UW-VexU/UWAT-Centurion-Board/centurion/fab/gerber_preview_copper_layers.png

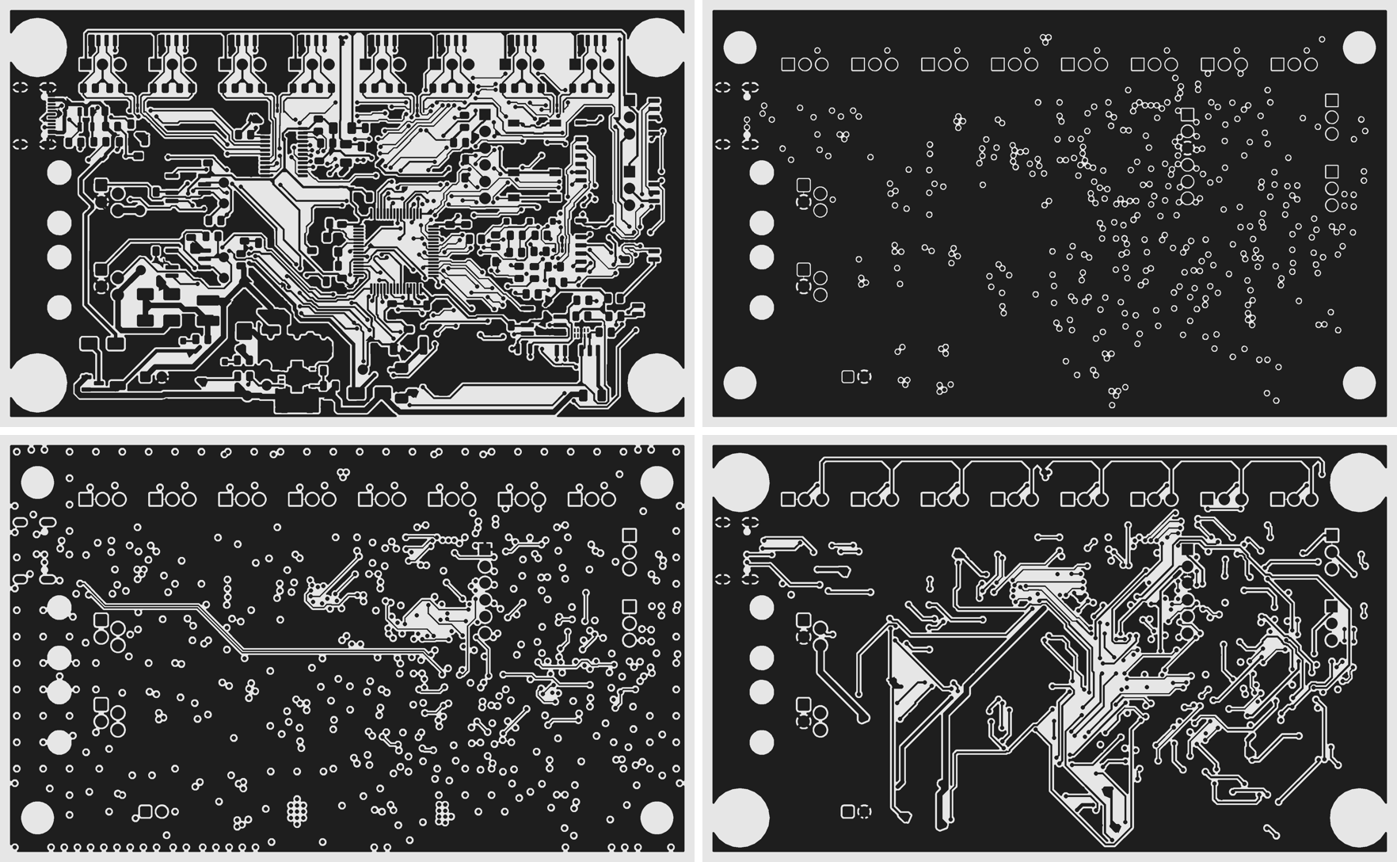
centurion/fab/gerber_preview_copper_layers.png
