UW-VexU/UWAT-Centurion-Board/centurion/sim/connectors_can.png

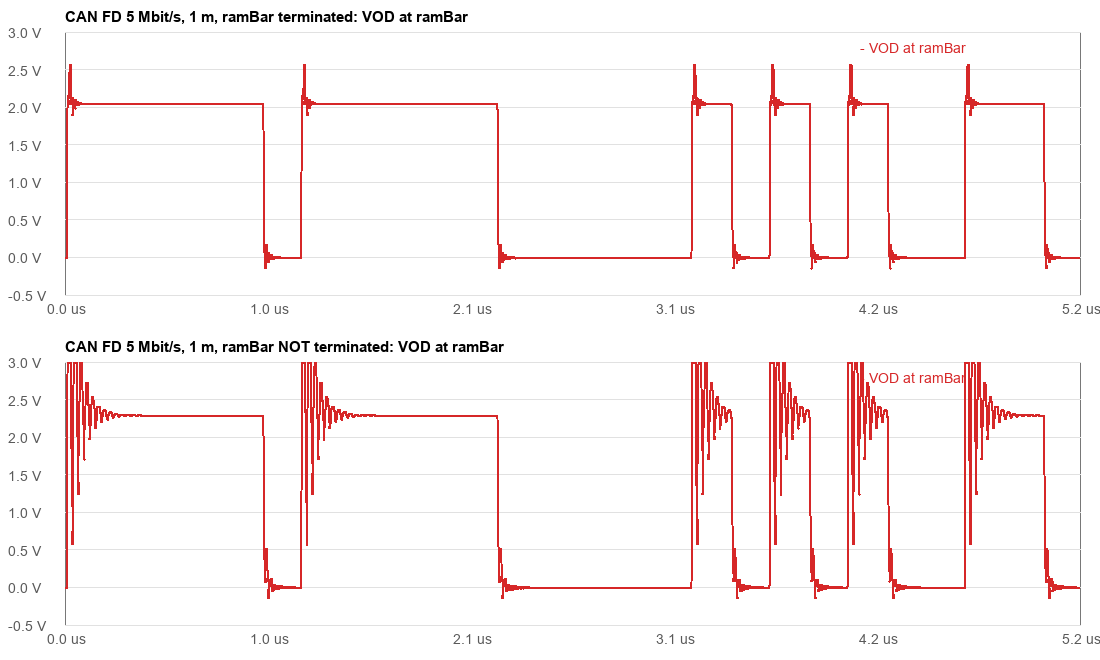
centurion/sim/connectors_can.png
