UW-VexU/UWAT-Centurion-Board/centurion/sim/connectors_i2c.png

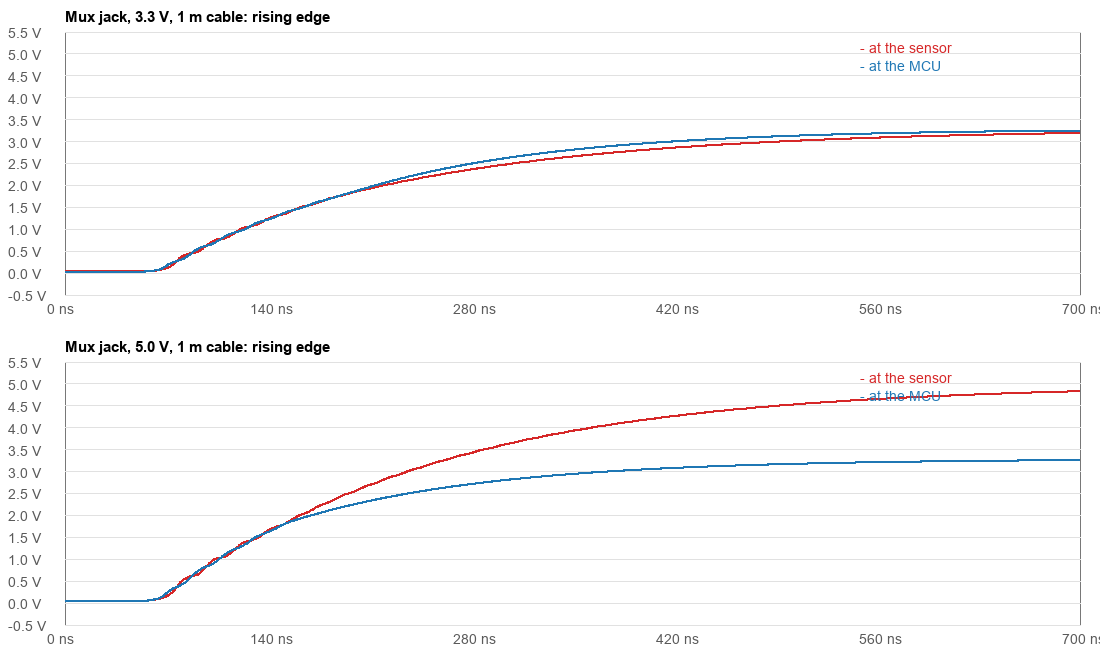
centurion/sim/connectors_i2c.png
