UW-VexU/UWAT-Centurion-Board/centurion/sim/connectors_power.png

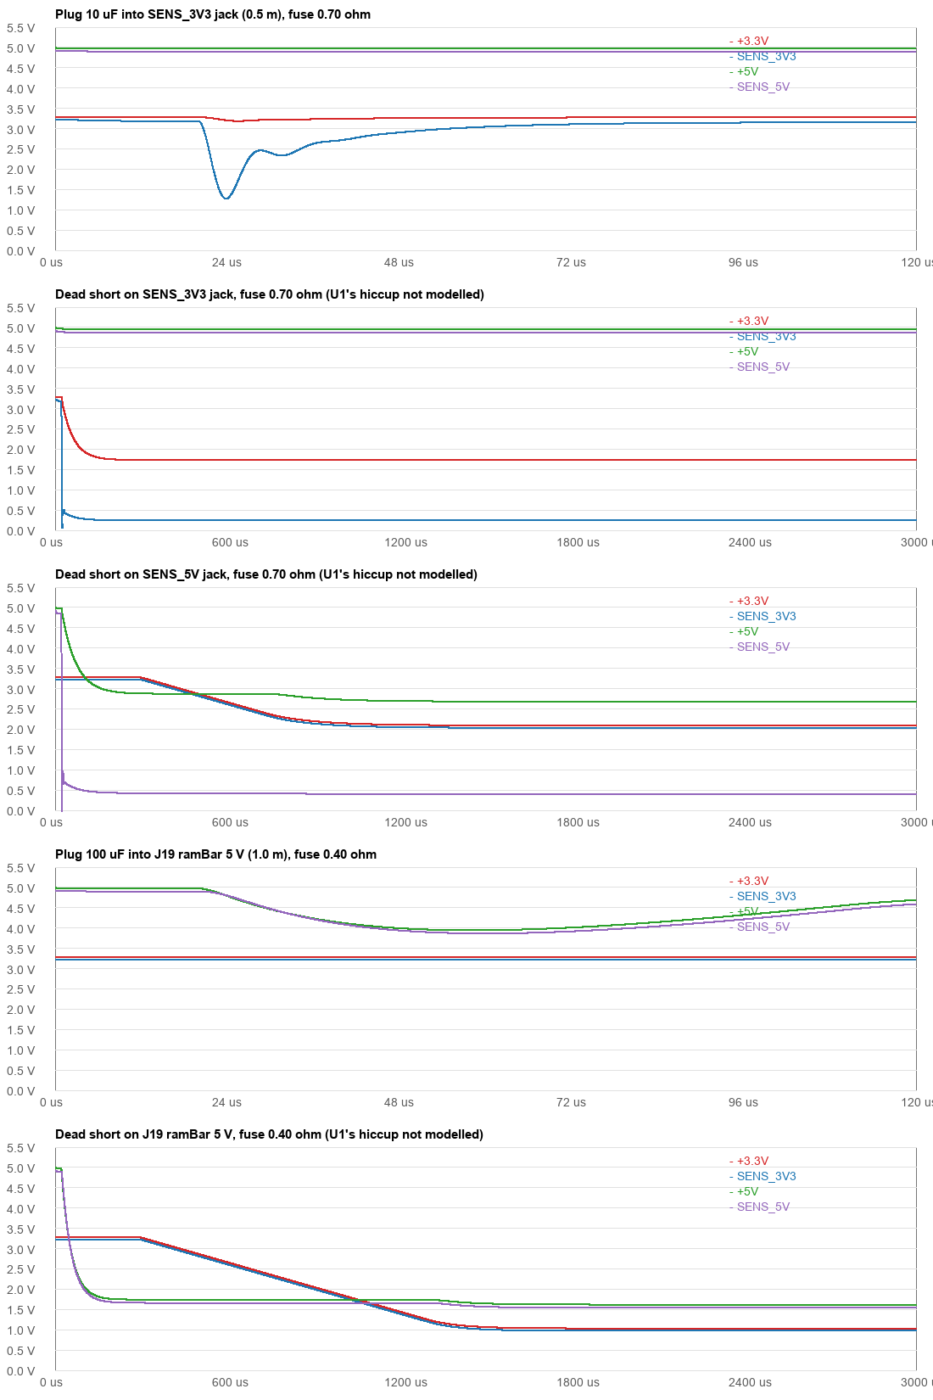
centurion/sim/connectors_power.png
