UW-VexU/UWAT-Centurion-Board/centurion/sim/connectors_rs485.png

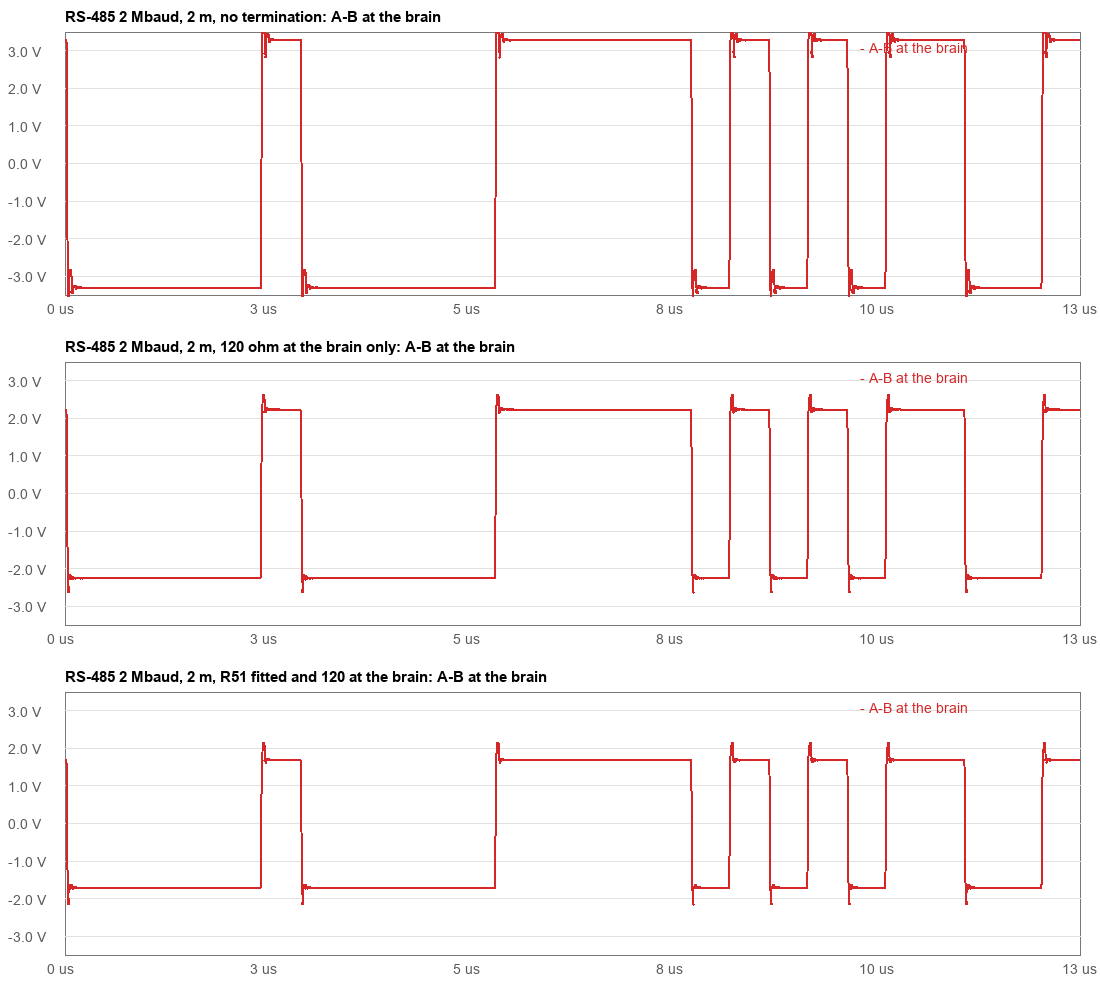
centurion/sim/connectors_rs485.png
