UW-VexU/UWAT-Centurion-Board/centurion/sim/connectors_spi.png

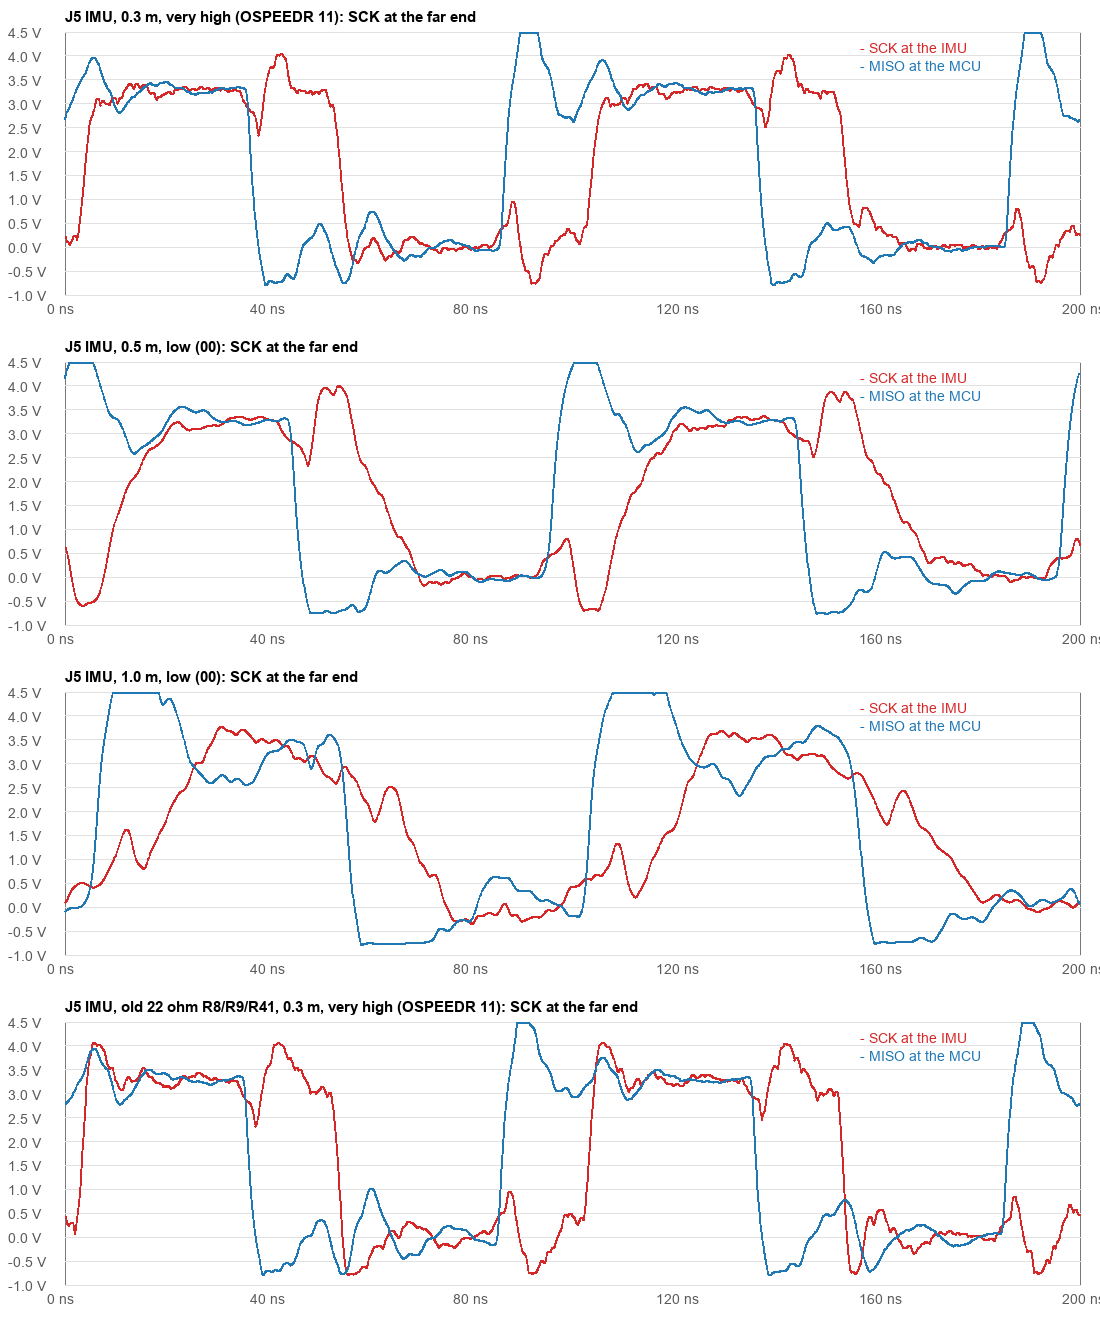
centurion/sim/connectors_spi.png
