UW-VexU/UWAT-Centurion-Board/centurion/sim/connectors_uart.png

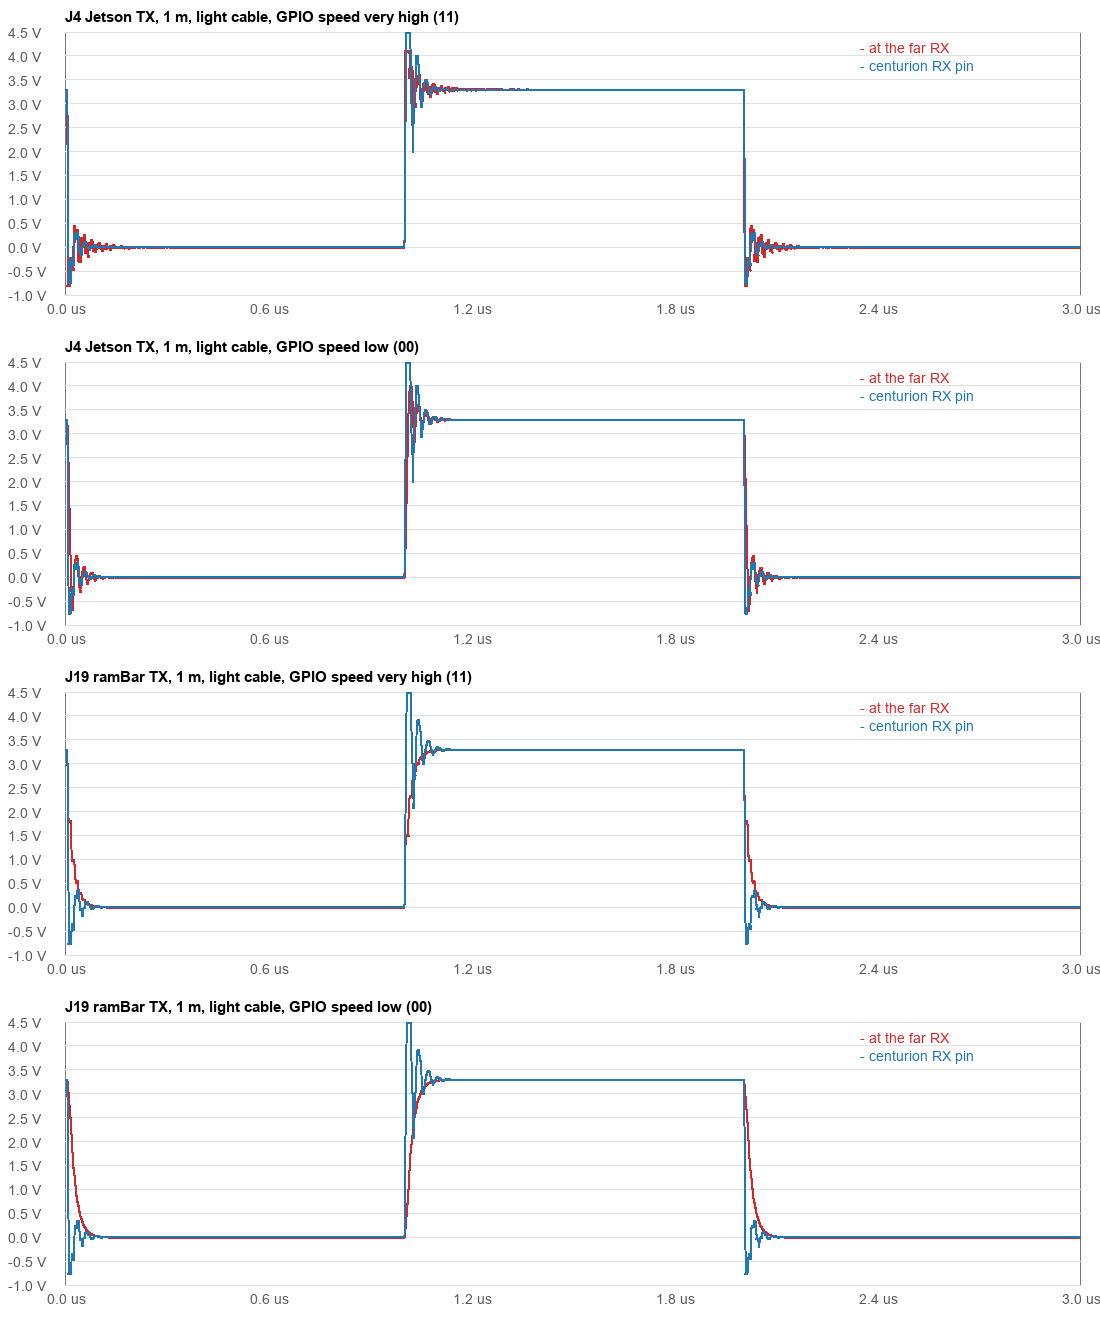
centurion/sim/connectors_uart.png
