UW-VexU/UWAT-Centurion-Board/centurion/sim/usb_hotplug_1u.png

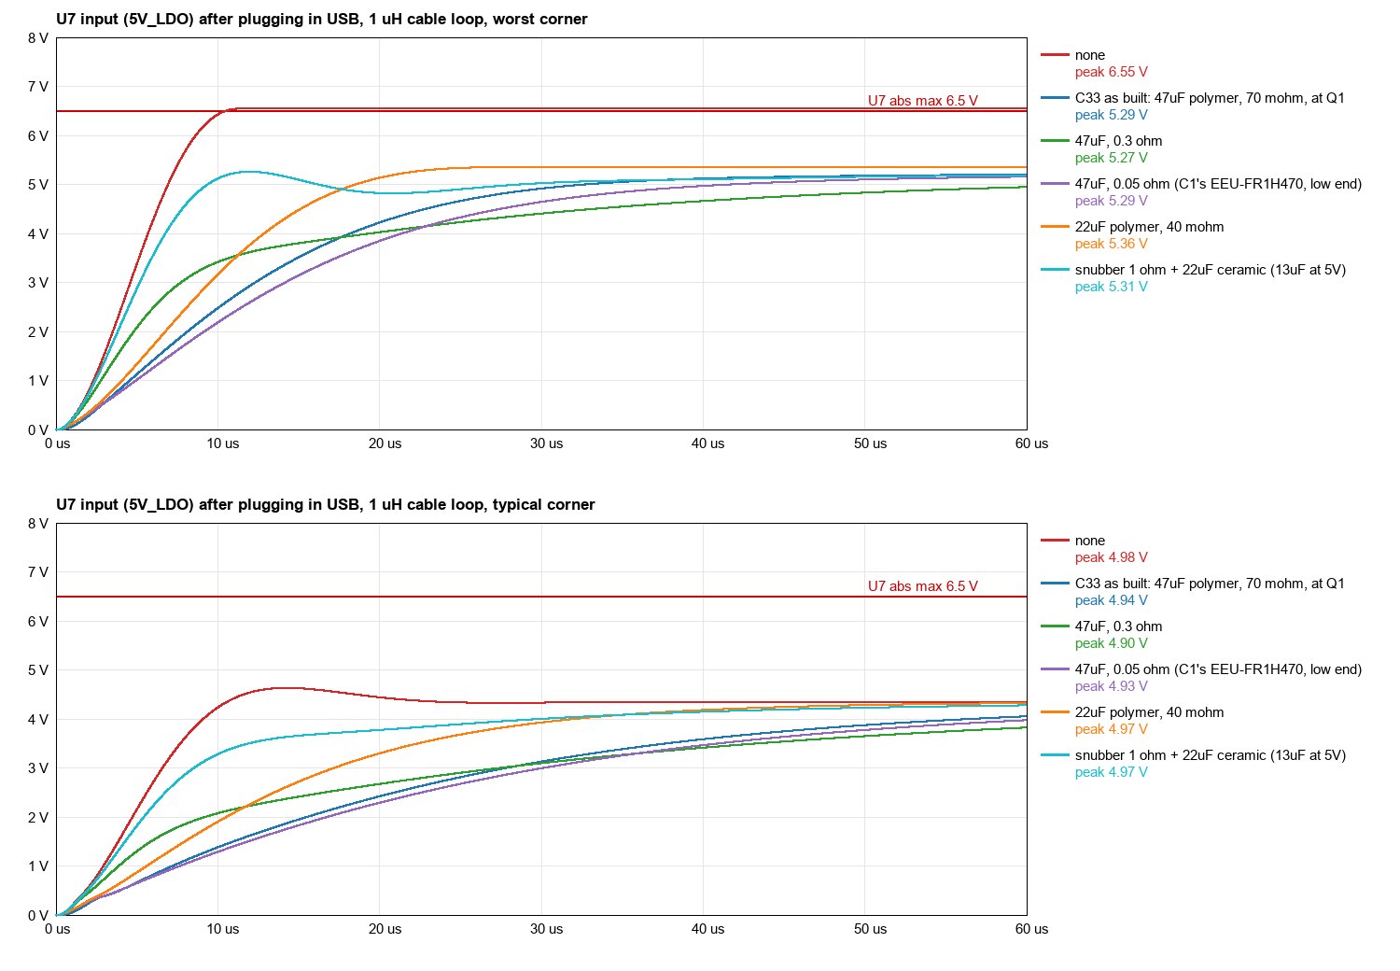
centurion/sim/usb_hotplug_1u.png
