UW-VexU/UWAT-Centurion-Board/centurion/sim/xtalk_worst.png

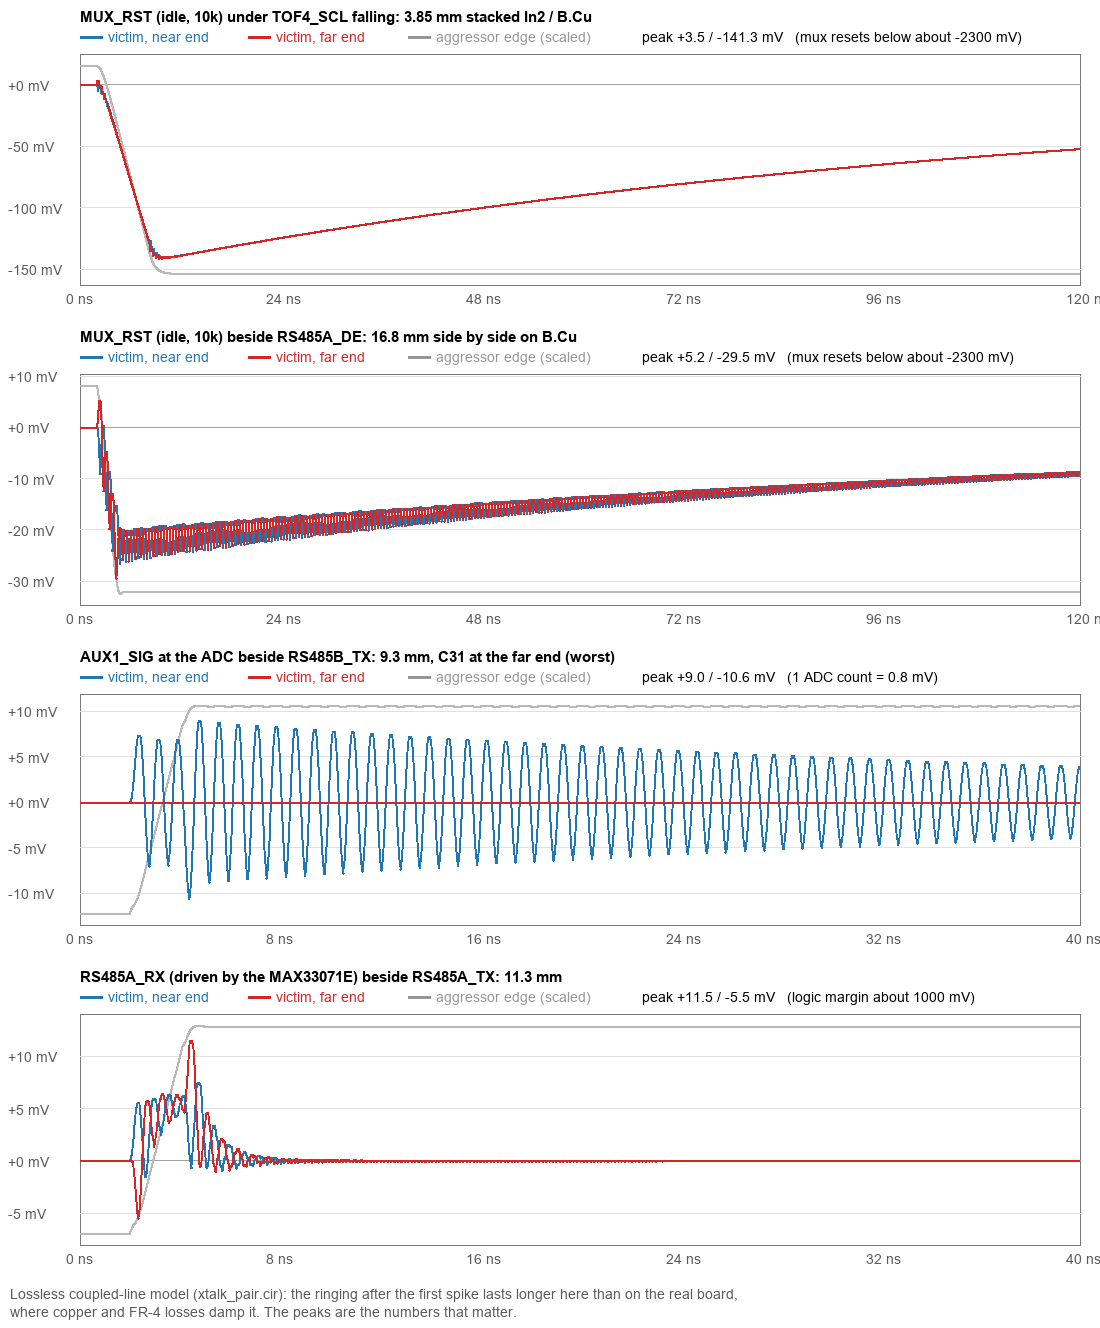
centurion/sim/xtalk_worst.png
