UW-VexU/UWAT-Centurion-Board/powerJackal/docs/images/scl_and_j2_ground.png

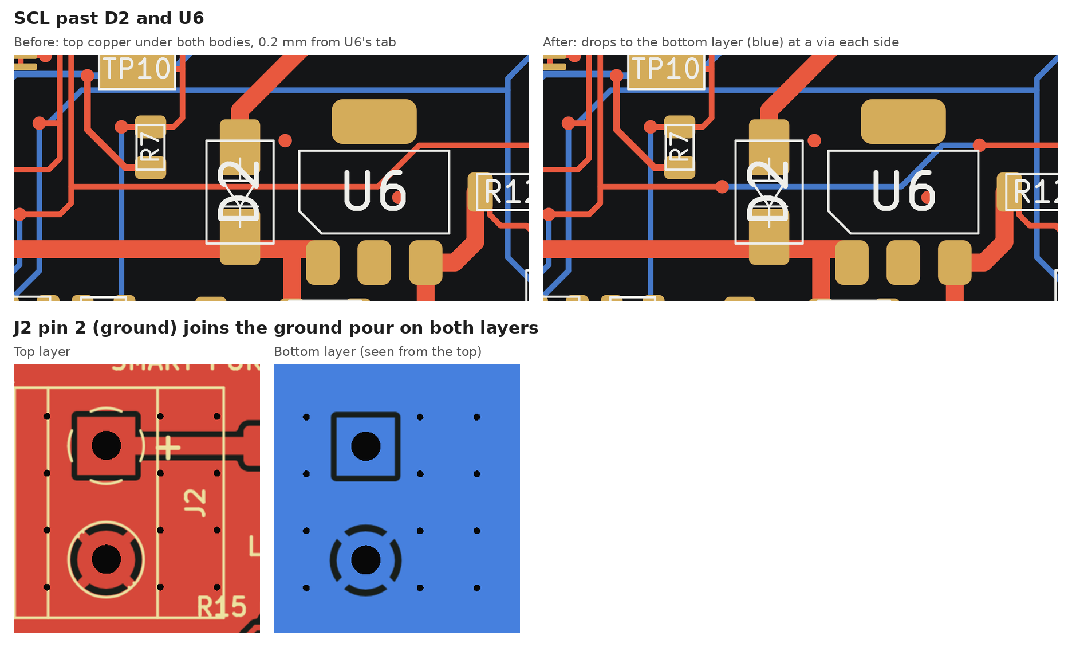
powerJackal/docs/images/scl_and_j2_ground.png
