UW-VexU/UWAT-Centurion-Board/stellaNova/docs/uwat-stellaNova-iso.png

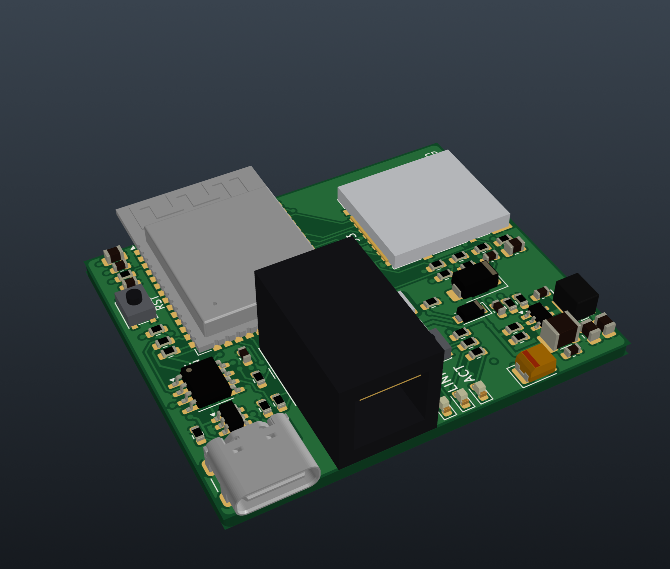
stellaNova/docs/uwat-stellaNova-iso.png
