UW-VexU/UWAT-Centurion-Board/centurion/bom/centurion_revA_BOM.xlsx

Sheet: BOM
Centurion Sensor Board, Bill of Materials, Rev A (STM32G491 + TCA9548A + TCAN334G, 103.2 x 62.6 mm, 4 layers)
UWAT VEXU. DigiKey Canada stock and CAD price breaks, read from digikey.ca on November 4, 2026; stock rechecked November 5, 2026 (parts also on powerJackal or stellaNova: October 29-30, 2026). The unit price follows the order quantity, using the breaks on the Price breaks tab. OUT OF STOCK at DigiKey CA on Nov 5, 2026: the JST GH right-angle headers SM04B-GHS-TB (J6-J13, J18) and SM03B-GHS-TB (J17), shaded red below. They come from LCSC only (link in column V, LCSC order tab). Two other parts that were out (TCA9548APWR, RC0805FR-07470RL) are replaced by in-stock equivalents; see their notes.
Boards to build |  | 6 | Edit the yellow cells. Type your own quantity in the yellow Your order qty column to override the suggested one. Order qty already takes off the parts left over from the powerJackal and stellaNova orders (On hand, from the Stock check tab).
Ref | Block | Description | Manufacturer | Mfr part number | DigiKey part number | Qty per board | Spares | Needed (boards x qty + spares) | Your order qty (optional) | Order qty | Unit price at order qty (CAD) | Order cost (CAD) | Next price break (qty) | Unit price at next break (CAD) | Tip | DigiKey stock | DigiKey Canada link | Notes | On hand (left from earlier orders) | Earlier order | LCSC link (only where DigiKey CA is out of stock) | LCSC stock (Nov 5, 2026)
C1 | Power | Aluminum electrolytic, 47 µF 50 V, 6.3 mm radial | Panasonic | EEU-FR1H470 | P124235-ND | 1 | 0 |  | 10 |  |  |  |  |  |  | 25727 | https://www.digikey.ca/en/products/detail/panasonic-industry/EEU-FR1H470/9921029 |  |  | powerJackal
C2, C3, C16, C32 | Power | Ceramic capacitor, 10 µF 50 V X7R, 1210 | Samsung Electro-Mechanics | CL32B106KBJNNNE | 1276-3387-1-ND | 4 | 2 |  | 50 |  |  |  |  |  |  | 628307 | https://www.digikey.ca/en/products/detail/samsung-electro-mechanics/CL32B106KBJNNNE/3889045 | C2, C3, C32: buck input ceramics at U1 VIN (TI asks for 20 uF effective). C16: LDO input. |  | powerJackal, stellaNova
C4, C5, C17 | Power | Ceramic capacitor, 47 µF 10 V X5R, 1206 | Murata | GRM31CR61A476ME15L | 490-5528-1-ND | 3 | 2 |  | 0 |  |  |  |  |  |  | 1078 | https://www.digikey.ca/en/products/detail/murata-electronics/GRM31CR61A476ME15L/2334879 |  |  | powerJackal
C6, C8, C9, C11, C12, C13, C14, C15, C19, C20, C21, C24, C25, C26, C27, C30 | Power, MCU, Sensor ports, Smart ports | Ceramic capacitor, 100 nF 50 V X7R, 0805 | Yageo | CC0805KRX7R9BB104 | 311-1140-1-ND | 16 | 2 |  | 50 |  |  |  |  |  |  | 4917789 | https://www.digikey.ca/en/products/detail/yageo/CC0805KRX7R9BB104/302874 | Place at NRST pin 7. Place at U14/U15 pin 8. Place at VBAT pin 1. Place at VDD pin 16. Place at VDD pin 32. Place at VDD pin 48. Place at VDD pin 64. Place at VDDA pin 29. Place at VREF+ pin 28. Place at the MCU ADC pin |  | powerJackal
D4 | Power | TVS diode, 16 V standoff, unidirectional, SMB | Littelfuse | SMBJ16A | SMBJ16ALFCT-ND | 1 | 1 |  | 10 |  |  |  |  |  |  | 22780 | https://www.digikey.ca/en/products/detail/littelfuse-inc/SMBJ16A/762784 |  |  | powerJackal
D9, D10 | Power | Schottky diode, 40 V 1 A, SMA | Vishay | SS14-E3/61T | SS14-E3/61TGICT-ND | 2 | 1 |  | 10 |  |  |  |  |  |  | 174599 | https://www.digikey.ca/en/products/detail/vishay-general-semiconductor-diodes-division/SS14-E3-61T/1091538 |  |  | powerJackal
F1 | Power | Polyfuse, 1.5 A hold, 33 V, 2016 | Littelfuse | 2016L150/33DR | 18-2016L150/33DRCT-ND | 1 | 1 |  | 10 |  |  |  |  |  |  | 29203 | https://www.digikey.ca/en/products/detail/littelfuse-inc/2016L150-33DR/6347051 |  |  | powerJackal
J16 | Power | USB-C receptacle, USB 2.0, 16 pin | GCT | USB4105-GF-A | 2073-USB4105-GF-ACT-ND | 1 | 0 |  | 0 |  |  |  |  |  |  | 82141 | https://www.digikey.ca/en/products/detail/gct/USB4105-GF-A/11198441 |  |  | powerJackal, stellaNova
Q1 | Power | P-channel MOSFET, -30 V, SOT-23 (USB power switch) | Alpha & Omega Semiconductor | AO3401A | 785-1001-1-ND | 1 | 1 |  | 10 |  |  |  |  |  |  | 303524 | https://www.digikey.ca/en/products/detail/alpha-omega-semiconductor-inc/AO3401A/1855773 | USB power switch. On only while the 5 V rail is down, so USB powers the board only with robot and bench power off. |  | powerJackal
R1 | Power | Resistor, 100 kΩ 1%, 0805 | Yageo | RC0805FR-07100KL | 311-100KCRCT-ND | 1 | 2 |  | 100 |  |  |  |  |  |  | 352614 | https://www.digikey.ca/en/products/detail/yageo/RC0805FR-07100KL/727544
R18, R32, R33 | Power, Sensor ports | Resistor, 2.2 kΩ 1%, 0805 | Yageo | RC0805FR-072K2L | 311-2.20KCRCT-ND | 3 | 2 |  | 0 |  |  |  |  |  |  | 375944 | https://www.digikey.ca/en/products/detail/yageo/RC0805FR-072K2L/727676 | R18: LED2. R32, R33: bus 2 (I2C3) pullups, 2.2k so two cables still meet 400 kHz rise time. |  | powerJackal
R29 | Power | Resistor, 2.49 kΩ 1%, 0805 (5 V feedback) | Yageo | RC0805FR-072K49L | 311-2.49KCRCT-ND | 1 | 2 |  | 0 |  |  |  |  |  |  | 1175983 | https://www.digikey.ca/en/products/detail/yageo/RC0805FR-072K49L/727695 | RFBB, sets 5.0 V |  | powerJackal
R31, R37, R48 | Power | Resistor, 5.1 kΩ 1%, 0805 | Stackpole Electronics | RMCF0805FT5K10 | RMCF0805FT5K10CT-ND | 3 | 2 |  | 0 |  |  |  |  |  |  | 122915 | https://www.digikey.ca/en/products/detail/stackpole-electronics-inc/RMCF0805FT5K10/1760394 |  |  | powerJackal
R40 | Power | Resistor, 22 kΩ 1%, 0805 | Yageo | RC0805FR-0722KL | 311-22.0KCRCT-ND | 1 | 2 |  | 100 |  |  |  |  |  |  | 186684 | https://www.digikey.ca/en/products/detail/yageo/RC0805FR-0722KL/727736 | Battery sense, 100k over 22k: 3.3 V full scale is 18.3 V.
U1 | Power | 5 V step-down power module, 2 A, B3QFN-14 | Texas Instruments | TPSM53602RDAR | 296-TPSM53602RDARCT-ND | 1 | 0 |  | 5 |  |  |  |  |  |  | 2776 | https://www.digikey.ca/en/products/detail/texas-instruments/TPSM53602RDAR/11502301 | EN tied to VIN. DNC pins 4, 5 and V5V (13) stay unconnected. |  | powerJackal
U7 | Power | LDO regulator, 3.3 V 1 A, SOT-223 | Microchip Technology | MCP1826ST-3302E/DB | MCP1826ST-3302E/DBCT-ND | 1 | 0 |  | 0 |  |  |  |  |  |  | 39394 | https://www.digikey.ca/en/products/detail/microchip-technology/MCP1826ST-3302E-DB/1635505 | Drawn with the AP7361C-33E symbol. Same SOT-223 pinout: 1 IN, 2 GND and tab, 3 OUT. |  | powerJackal
U13 | Power | USB ESD protection, SOT-23-6 | STMicroelectronics | USBLC6-2SC6 | 497-5235-1-ND | 1 | 1 |  | 0 |  |  |  |  |  |  | 32077 | https://www.digikey.ca/en/products/detail/stmicroelectronics/USBLC6-2SC6/1040559 |  |  | powerJackal, stellaNova
D5, D11 | Smart ports | Schottky diode, 40 V 3 A, SMA (smart port OR diodes) | Diodes Incorporated | B340A-13-F | B340A-FDICT-ND | 2 | 1 |  | 0 |  |  |  |  |  |  | 233706 | https://www.digikey.ca/en/products/detail/diodes-incorporated/B340A-13-F/725015 |  |  | powerJackal
J1, J2 | Smart ports | Smart port jack, 4P4C modular, right angle, through hole | Molex | 0955012441 | WM5568-ND | 2 | 0 |  | 10 |  |  |  |  |  |  | 4091 | https://www.digikey.ca/en/products/detail/molex/0955012441/1835860 | Pin map assumes the usual black, red, green, yellow order. Check with a meter. |  | powerJackal, stellaNova
U14, U15 | Smart ports | RS-485 transceiver, half duplex, 3.3 V, ±65 V fault protected, 2 Mbps, SOIC-8 | Analog Devices | MAX33071EASA+ | 505-MAX33071EASA+-ND | 2 | 0 |  | 10 |  |  |  |  |  |  | 2911 | https://www.digikey.ca/en/products/detail/analog-devices-inc-maxim-integrated/MAX33071EASA/14115470 | RE tied low: the receiver is always on, so the MCU hears its own echo when sending. |  | stellaNova
C10, C28, C29 | MCU, Sensor ports | Ceramic capacitor, 10 µF 25 V X5R, 0805 | Murata | GRM21BR61E106KA73K | 490-16824-1-ND | 3 | 2 |  | 20 |  |  |  |  |  |  | 27467 | https://www.digikey.ca/en/products/detail/murata-electronics/GRM21BR61E106KA73K/4905532 | C10: bulk at U3. C28, C29: bulk on SENS_3V3 and SENS_5V after F2/F3. |  | stellaNova
C18 | MCU | Ceramic capacitor, 1 µF 25 V X7R, 0805 | Yageo | CC0805KKX7R8BB105 | 311-1456-1-ND | 1 | 2 |  | 0 |  |  |  |  |  |  | 327250 | https://www.digikey.ca/en/products/detail/yageo/CC0805KKX7R8BB105/2833621 | Place at VDDA pin 29 |  | powerJackal
D6, LED1, LED2 | MCU, Power | LED, green, 0603 | Lite-On | LTST-C191KGKT | 160-1446-1-ND | 3 | 2 |  | 100 |  |  |  |  |  |  | 2259167 | https://www.digikey.ca/en/products/detail/liteon/LTST-C191KGKT/386835 |  |  | stellaNova
D7 | MCU | LED, orange, 0603 | Lite-On | LTST-C191KFKT | 160-1445-1-ND | 1 | 2 |  | 10 |  |  |  |  |  |  | 185113 | https://www.digikey.ca/en/products/detail/liteon/LTST-C191KFKT/386833 |  |  | stellaNova
D8 | MCU | LED, red, 0603 | Lite-On | LTST-C191KRKT | 160-1447-1-ND | 1 | 2 |  | 10 |  |  |  |  |  |  | 1343250 | https://www.digikey.ca/en/products/detail/liteon/LTST-C191KRKT/386837 |  |  | stellaNova
J3, JP1, JP2, JP3, JP4, JP5, JP6, JP7, JP8, JP9, JP10 | MCU, Sensor ports | Pin header, 2.54 mm, 40-pin breakaway strip (cut to 1x6 and ten 1x3) | Sullins Connector Solutions | PRPC040SAAN-RC |  | 1 | 0 |  | 0 |  |  |  |  |  |  |  |  | Team stock: not ordered from DigiKey. One strip per board: 6 pins for J3 (SWD) and 30 for the ten shunt headers JP1 to JP10. |  | Team stock
R2, R10, R17, R30, R34, R45, R46, R49, R50, R54, R56, R57, R58 | MCU, Sensor ports, Power, Smart ports | Resistor, 10 kΩ 1%, 0805 | Yageo | RC0805FR-0710KL | 311-10.0KCRCT-ND | 13 | 2 |  | 100 |  |  |  |  |  |  | 1315842 | https://www.digikey.ca/en/products/detail/yageo/RC0805FR-0710KL/727535 | RFBT |  | powerJackal
R3, R4, R5, R44 | MCU, Sensor ports | Resistor, 1 kΩ 1%, 0805 | Yageo | RC0805FR-071KL | 311-1.00KCRCT-ND | 4 | 2 |  | 0 |  |  |  |  |  |  | 418142 | https://www.digikey.ca/en/products/detail/yageo/RC0805FR-071KL/730391 |  |  | powerJackal
SW1, SW2 | MCU | Tactile switch, SMD, low profile | E-Switch | TL3342F160QG | EG2531CT-ND | 2 | 1 |  | 10 |  |  |  |  |  |  | 71875 | https://www.digikey.ca/en/products/detail/e-switch/TL3342F160QG-TR/379004 |  |  | powerJackal
U3 | MCU | MCU, Cortex-M4F 170 MHz, 512 KB flash, LQFP-64 | STMicroelectronics | STM32G491RET6 | 497-STM32G491RET6-ND | 1 | 0 |  | 10 |  |  |  |  |  |  | 508 | https://www.digikey.ca/en/products/detail/stmicroelectronics/STM32G491RET6/13592591 | Pin plan in centurion/README.md. USART2 and USART3 drive RS-485 DE in hardware.
F2, F3 | Sensor ports | Polyfuse, 0.5 A hold, 1206 (sensor 3.3 V and 5 V branches) | Bourns | MF-NSMF050-2 | MF-NSMF050-2CT-ND | 2 | 1 |  | 50 |  |  |  |  |  |  | 61010 | https://www.digikey.ca/en/products/detail/bourns-inc/MF-NSMF050-2/662808 | F2 feeds SENS_3V3, F3 feeds SENS_5V. 0.5 A hold derates to about 0.35 A at 60 C. F2 was 0.35 A (MF-NSMF035X-2) until the 2026-11-04 review: 8 or more jacks on 3.3 V would trip it.
J6, J7, J8, J9, J10, J11, J12, J13, J18 | Sensor ports | JST GH 4-pin, right angle SMD | JST | SM04B-GHS-TB | 455-1566-1-ND | 9 | 0 |  | 55 |  |  |  |  |  |  | 0 | https://www.digikey.ca/en/products/detail/jst-sales-america-inc/SM04B-GHS-TB/807788 | OUT OF STOCK AT DIGIKEY CA (0 on Nov 5, 2026; 2,500 due Nov 16) and 0 at Mouser. Bought from LCSC only (C189895, genuine JST SM04B-GHS-TB(LF)(SN), link in column V): 55 for the 6 boards (9 x 6 = 54, LCSC sells in 5s). Not ordered from DigiKey. Unit price is LCSC USD x the rate on the LCSC order tab. No other connector fits this footprint and takes GH cables. |  |  | https://www.lcsc.com/product-detail/C189895.html | 17515
J14 | Sensor ports | JST GH 5-pin, right angle SMD | JST | SM05B-GHS-TB | 455-SM05B-GHS-TBCT-ND | 1 | 0 |  | 10 |  |  |  |  |  |  | 12473 | https://www.digikey.ca/en/products/detail/jst-sales-america-inc/SM05B-GHS-TB/807789
J17 | Sensor ports | JST GH 3-pin, right angle SMD | JST | SM03B-GHS-TB | 455-SM03B-GHS-TBCT-ND | 1 | 0 |  | 10 |  |  |  |  |  |  | 0 | https://www.digikey.ca/en/products/detail/jst-sales-america-inc/SM03B-GHS-TB/807787 | OUT OF STOCK AT DIGIKEY CA (0 on Nov 5, 2026; 2,500 due Nov 16) and 0 at Mouser. Bought from LCSC only (C514175, genuine JST SM03B-GHS-TB(LF)(SN), link in column V): 10 for the 6 boards (6 needed; LCSC sells in 5s). Not ordered from DigiKey. Unit price is LCSC USD x the rate on the LCSC order tab. |  |  | https://www.lcsc.com/product-detail/C514175.html | 30395
R11, R12 | Sensor ports | Resistor, 4.7 kΩ 1%, 0805 | Yageo | RC0805FR-074K7L | 311-4.70KCRCT-ND | 2 | 2 |  | 0 |  |  |  |  |  |  | 571750 | https://www.digikey.ca/en/products/detail/yageo/RC0805FR-074K7L/727929 | R11, R12: upstream I2C pullups to the mux. |  | powerJackal
R35, R47 | Sensor ports, Power | Resistor, 15 kΩ 1%, 0805 | Yageo | RC0805FR-0715KL | 311-15.0KCRCT-ND | 2 | 2 |  | 100 |  |  |  |  |  |  | 33866 | https://www.digikey.ca/en/products/detail/yageo/RC0805FR-0715KL/727608
U6 | Sensor ports | I2C mux, 8 channel, TSSOP-24 | NXP USA Inc. | PCA9548APW,118 | 568-10297-1-ND | 1 | 0 |  | 10 |  |  |  |  |  |  | 14996 | https://www.digikey.ca/en/products/detail/nxp-usa-inc/PCA9548APW-118/1157063 | Drop-in for TCA9548APWR, which was 0 at DigiKey CA on Nov 5, 2026 (2,000 due Nov 10). NXP's PCA9548A has the same TSSOP-24 pinout, I2C addresses (0x70-0x77) and control register, 2.3-5.5 V supply and 5 V tolerant channels, so the footprint and firmware are unchanged. The schematic and silkscreen still say TCA9548APWR. Mouser also had 32 TCA9548APWR (595-TCA9548APWR) if you would rather keep the TI part.
U5, U8, U9, U10, U11, U12, U17 | IMU and spare SPI, Sensor ports, ramBar link | ESD protection, 4 channel, USON-10 (automotive grade) | Texas Instruments | TPD4E05U06QDQARQ1 | 296-40696-1-ND | 7 | 1 |  | 50 |  |  |  |  |  |  | 131276 | https://www.digikey.ca/en/products/detail/texas-instruments/TPD4E05U06QDQARQ1/4972148 | TPD4E05U06-Q1: TI's AEC-Q101 version of TPD4E05U06DQAR, same 10-USON (DQA) package, pinout and ratings. Picked because TPD4E05U06DQAR is out of stock at DigiKey CA until Feb 18, 2027.
Y1 | MCU | Crystal, 8 MHz, 8 pF load, 4-pad SMD, 3.2 x 2.5 mm | Abracon | ABM8AIG-8.000MHZ-8-V1R-T | 535-15255-1-ND | 1 | 1 |  | 10 |  |  |  |  |  |  | 1456 | https://www.digikey.ca/en/products/detail/abracon-llc/ABM8AIG-8-000MHZ-8-V1R-T/10313750 | Now fitted: CAN FD needs an accurate clock, and the USB DFU bootloader then doesn't rely on HSI.
C22, C23 | MCU | Ceramic capacitor, 10 pF 50 V C0G, 0805 | Yageo | CC0805JRNPO9BN100 | 311-1099-1-ND | 2 | 2 |  | 50 |  |  |  |  |  |  | 76359 | https://www.digikey.ca/en/products/detail/yageo/CC0805JRNPO9BN100/302833 | Y1 load caps: 2 x (8 pF load - about 3 pF stray)
J4 | Jetson link | JST GH 3-pin, vertical (top entry) SMD | JST | BM03B-GHS-TBT | 455-BM03B-GHS-TBTCT-ND | 1 | 0 |  | 10 |  |  |  |  |  |  | 99570 | https://www.digikey.ca/en/products/detail/jst-sales-america-inc/BM03B-GHS-TBT/807801 | 1 TX, 2 RX, 3 GND
J5 | IMU and spare SPI | JST GH 8-pin, vertical (top entry) SMD | JST | BM08B-GHS-TBT | 455-BM08B-GHS-TBTCT-ND | 1 | 0 |  | 10 |  |  |  |  |  |  | 35487 | https://www.digikey.ca/en/products/detail/jst-sales-america-inc/BM08B-GHS-TBT/807806
J15 | IMU and spare SPI | JST GH 7-pin, vertical (top entry) SMD | JST | BM07B-GHS-TBT | 455-BM07B-GHS-TBTCT-ND | 1 | 0 |  | 10 |  |  |  |  |  |  | 21317 | https://www.digikey.ca/en/products/detail/jst-sales-america-inc/BM07B-GHS-TBT/807805
J19 | ramBar link | JST GH 6-pin, vertical (top entry) SMD | JST | BM06B-GHS-TBT | 455-BM06B-GHS-TBTCT-ND | 1 | 0 |  | 10 |  |  |  |  |  |  | 24646 | https://www.digikey.ca/en/products/detail/jst-sales-america-inc/BM06B-GHS-TBT/807804 | 1 5V, 2 TX, 3 RX, 4 GND, 5 CANH, 6 CANL
U16 | ramBar link | CAN FD transceiver, 3.3 V, 5 Mbps, SOIC-8 | Texas Instruments | TCAN334GDR | 296-49940-1-ND | 1 | 1 |  | 10 |  |  |  |  |  |  | 315 | https://www.digikey.ca/en/products/detail/texas-instruments/TCAN334GDR/5957539 | SHDN and STB tied low: always on
R38, R39 | Power | Resistor, 0 Ω jumper, 0805 (USB D+ / D- series position) | Yageo | RC0805JR-070RL | 311-0.0ARCT-ND | 2 | 2 |  | 100 |  |  |  |  |  |  | 2238394 | https://www.digikey.ca/en/products/detail/yageo/RC0805JR-070RL/728216 | 0 Ω: the STM32G4's USB pins need no external series resistor (DS13122); 22 Ω came from an ESP32 design and pushed the line outside the USB full-speed spec. The pads stay for tuning.
R53 | ramBar link | Resistor, 120 Ω 1%, 0805 | Yageo | RC0805FR-07120RL | 311-120CRCT-ND | 1 | 2 |  | 100 |  |  |  |  |  |  | 171849 | https://www.digikey.ca/en/products/detail/yageo/RC0805FR-07120RL/727575 | CAN termination at this end of the bus. Same part as the not-fitted R51/R52.
R8, R9, R41, R55 | IMU and spare SPI, Sensor ports | Resistor, 100 Ω 1%, 0805 | Yageo | RC0805FR-07100RL | 311-100CRCT-ND | 4 | 2 |  | 100 |  |  |  |  |  |  | 876166 | https://www.digikey.ca/en/products/detail/yageo/RC0805FR-07100RL/727543 | R8, R9, R41: IMU SPI series resistors (SCK, MOSI, CS). 100 Ω (was 22 Ω) damps the JST GH cable: see centurion/sim/README.md. R55: turret pot supply from +3.3V (same rail as VREF+), limits a cable short.
D12 | ramBar link | CAN bus TVS, dual line, 24 V working, SOT-23 | onsemi | NUP2105LT1G | NUP2105LT1GOSCT-ND | 1 | 1 |  | 10 |  |  |  |  |  |  | 4738 | https://www.digikey.ca/en/products/detail/onsemi/NUP2105LT1G/1749081 | Clamps CANH and CANL without clipping CAN's -2 to +7 V common mode.
JP1, JP2, JP3, JP4, JP5, JP6, JP7, JP8, JP9, JP10 | Sensor ports | Jumper shunt, 2.54 mm, 2 position | Sullins Connector Solutions | QPC02SXGN-RC | S9337-ND | 10 | 0 |  | 60 |  |  |  |  |  |  | 3272954 | https://www.digikey.ca/en/products/detail/sullins-connector-solutions/QPC02SXGN-RC/2618262 | One per shunt header: pins 1-2 = 3.3 V, pins 2-3 = 5 V, none = jack off. Ordered from DigiKey (team stock is short of the 60 needed for 6 boards). | 0
R13, R14, R15, R16, R19, R20, R21, R22, R23, R24, R25, R26, R27, R28, R42, R43 | Sensor ports | Resistor, 2.7 kΩ 1%, 0805 | Yageo | RC0805FR-072K7L | 311-2.70KCRCT-ND | 16 | 2 |  | 250 |  |  |  |  |  |  | 78988 | https://www.digikey.ca/en/products/detail/yageo/RC0805FR-072K7L/727706 | Jack I2C pullups, to each jack's VCC. 2.7k meets 400 kHz rise time on a 1 m cable and stays under 3 mA on a 5 V jack.
F4 | ramBar link | Polyfuse, 0.75 A hold, 1206 (5 V to ramBar) | Bourns | MF-NSMF075-2 | MF-NSMF075-2CT-ND | 1 | 1 |  | 10 |  |  |  |  |  |  | 53656 | https://www.digikey.ca/en/products/detail/bourns-inc/MF-NSMF075-2/662809 | 6 V rating. Holds about 0.52 A at 60 C, so ramBar can draw up to about 0.5 A.
R59 | ramBar link | Resistor, 470 Ω 1%, 0805 | Yageo | RC0805FR-13470RL | 13-RC0805FR-13470RLCT-ND | 1 | 2 |  | 100 |  |  |  |  |  |  | 38067 | https://www.digikey.ca/en/products/detail/yageo/RC0805FR-13470RL/14286700 | Same Yageo resistor as RC0805FR-07470RL, from a 13-inch reel instead of 7-inch (-07 was 0 at DigiKey CA on Nov 5, 2026). RAMBAR_TX series: limits current into an unpowered ramBar, damps the 1 m cable. 0 in stock at DigiKey CA on Nov 4, 2026; 5,000 expected Nov 9, 2026. Any 470 Ω 0805 resistor works.
R60 | Sensor ports | Resistor, 1 MΩ 1%, 0805 | Yageo | RC0805FR-071ML | 311-1.00MCRCT-ND | 1 | 2 |  | 100 |  |  |  |  |  |  | 644254 | https://www.digikey.ca/en/products/detail/yageo/RC0805FR-071ML/727445 | POT_IN pulldown: an unplugged pot reads 0.
C31 | Sensor ports | Ceramic capacitor, 10 nF 50 V X7R, 0805 | Yageo | CC0805KRX7R9BB103 | 311-1136-1-ND | 1 | 2 |  | 50 |  |  |  |  |  |  | 424884 | https://www.digikey.ca/en/products/detail/yageo/CC0805KRX7R9BB103/302870 | AUX1 ADC input cap on PC2.
C33 | Power | Polymer tantalum capacitor, 47 µF 10 V, 70 mΩ ESR, 3528 (EIA case B) | KEMET | T520B476M010ATE070 | 399-4982-1-ND | 1 | 1 |  | 10 |  |  |  |  |  |  | 50082 | https://www.digikey.ca/en/products/detail/kemet/T520B476M010ATE070/1129669 | Bulk cap on 5V_LDO, next to Q1. Damps the USB hot-plug ring so U7 stays under its 6.5 V rating (sim/README.md: 5.3 to 5.5 V instead of up to 7.2 V). Polymer, 100% surge tested. Panasonic 10TPB47M is the same spec.
R36 | Sensor ports | Resistor, 0 Ω jumper, 0805 (not fitted) | Yageo | RC0805JR-070RL | 311-0.0ARCT-ND | 0 | 0 |  |  |  |  |  |  |  |  | 2238394 | https://www.digikey.ca/en/products/detail/yageo/RC0805JR-070RL/728216 | Not fitted
R51, R52 | Smart ports | Resistor, 120 Ω 1%, 0805 (not fitted) | Yageo | RC0805FR-07120RL | 311-120CRCT-ND | 0 | 0 |  |  |  |  |  |  |  |  | 171849 | https://www.digikey.ca/en/products/detail/yageo/RC0805FR-07120RL/727575 | Not fitted
 |  | Order total at the quantities above (CAD; the two LCSC lines at the LCSC order tab rate)
 |  | Parts cost for 1 board at the order unit prices, everything on the board (CAD)
 |  | Lines still to order (DigiKey and LCSC)
 |  | Lines covered by parts on hand (earlier orders or team stock)
 |  | Lines where stock (DigiKey, or LCSC for the GH headers) is below the order qty
 |  | Lowest DigiKey stock on any line
Unit prices are digikey.ca CAD on cut tape (tray for U3), at the price break for the order qty, or for the needed qty on lines already covered by parts on hand. The yellow order quantities are suggestions: what is still needed after the parts on hand, rounded up to a price break when that costs at most $0.50 more in total (free spares on cheap parts). Tip: a green cell means buying up to the next break costs less in total. Stock turns red if it is below the order qty. Not fitted lines (qty 0) and Team stock lines are not ordered. Cable parts and crimping tools are on the Cables and tools tab. The PCB itself, sensors, screws and shipping are not included. Blue cells are inputs, black cells are formulas.

Sheet: Cables and tools
Centurion cables and crimping tools (JST GH)
Every cable jack on centurion is JST GH: 1.25 mm pitch, with a latch. Qwiic and STEMMA QT are JST SH, which is smaller (1.0 mm) and uses a different pin order, so Qwiic cables do not plug in. DigiKey Canada stock and CAD prices read from digikey.ca on November 4, 2026.
Cable sets to make |  | 3 | Two robots plus a spare set. A set is one cable for every centurion jack: J4, J5, J6 to J14, J15, J17, J18 and J19. Edit the yellow cells.
Extra contacts for bad crimps |  | 50% | Crimping 1.25 mm contacts takes practice: expect to scrap some while learning.
Item | Use | Description | Manufacturer | Mfr part number | DigiKey part number | Per set | Spares | Needed | Your order qty (optional) | Order qty | Unit price at order qty (CAD) | Order cost (CAD) | DigiKey stock | DigiKey Canada link | Notes
Connector housings: one per cable end
GH 3-pin housing | J4 Jetson UART, J17 pot | Housing, JST GH, 3 positions, 1.25 mm, natural | JST | GHR-03V-S | 455-1593-ND | 2 | 2 |  |  |  |  |  | 7683 | https://www.digikey.ca/en/products/detail/jst-sales-america-inc/GHR-03V-S/807815 | Centurion end of J4 and J17.
GH 4-pin housing | J6 to J13 sensors, J18 | Housing, JST GH, 4 positions, 1.25 mm, natural | JST | GHR-04V-S | 455-1594-ND | 9 | 4 |  |  |  |  |  | 15391 | https://www.digikey.ca/en/products/detail/jst-sales-america-inc/GHR-04V-S/807816 | Centurion end of the eight mux jacks and J18. Add one per sensor if the sensor end is JST GH too (a custom sensor board).
GH 5-pin housing | J14 AUX1 | Housing, JST GH, 5 positions, 1.25 mm, natural | JST | GHR-05V-S | 455-1595-ND | 1 | 2 |  |  |  |  |  | 57574 | https://www.digikey.ca/en/products/detail/jst-sales-america-inc/GHR-05V-S/807817 | Centurion end of J14.
GH 6-pin housing | J19 ramBar, both ends | Housing, JST GH, 6 positions, 1.25 mm, natural | JST | GHR-06V-S | 455-1596-ND | 2 | 2 |  |  |  |  |  | 38927 | https://www.digikey.ca/en/products/detail/jst-sales-america-inc/GHR-06V-S/807818 | J19 and ramBar's matching jack, joined with the pre-crimped leads below.
GH 7-pin housing | J15 spare SPI | Housing, JST GH, 7 positions, 1.25 mm, natural | JST | GHR-07V-S | 455-1597-ND | 1 | 1 |  |  |  |  |  | 41226 | https://www.digikey.ca/en/products/detail/jst-sales-america-inc/GHR-07V-S/807819 | J15 is a spare port: make its cable when something plugs in.
GH 8-pin housing | J5 IMU, both ends | Housing, JST GH, 8 positions, 1.25 mm, natural | JST | GHR-08V-S | 455-1598-ND | 2 | 2 |  |  |  |  |  | 85156 | https://www.digikey.ca/en/products/detail/jst-sales-america-inc/GHR-08V-S/807820 | J5, plus the IMU end if the IMU board has a JST GH 8-pin jack. Keep this cable 30 cm or less (sim/README.md).
Contacts, pre-crimped leads and wire
GH crimp contact | Every crimped GH end | Socket contact, JST GH, 26 to 30 AWG, tin, loose strip | JST | SSHL-002T-P0.2 |  | 54 |  |  |  |  |  |  | 8300 | https://www.digikey.ca/en/products/detail/jst-sales-america-inc/SSHL-002T-P0-2/27687535 | Per set: J4 3 + J17 3 + nine 4-pin cables 36 + J14 5 + J15 7 = 54, centurion ends only (add the sensor ends if they are JST GH too). ramBar and IMU cables use the pre-crimped leads. Sold in strips of 100, 500 or 1000; the DigiKey number follows the order qty (stock is for the strip of 100).
Pre-crimped GH lead, 305 mm | J19 ramBar and J5 IMU cables | Jumper wire, 28 AWG, JST GH contact on both ends, 305 mm (12 in) | JST | AGHGH28K305 | 455-3074-ND | 14 | 4 |  |  |  |  |  | 280056 | https://www.digikey.ca/en/products/detail/jst-sales-america-inc/AGHGH28K305/6009450 | No crimping: push one end into each housing. Per set: 6 for ramBar (J19) and 8 for the IMU (J5). 305 mm is the longest JST makes; crimp longer cables from wire instead. Twist pins 5 and 6 (CANH, CANL) together.
Wire, red | VCC | Hook-up wire, 28 AWG stranded, PVC (UL1061), red, 100 ft | Alpha Wire | 422807 RD005 | A422807R-100-ND | 25 | 0 |  |  |  |  |  | 197 | https://www.digikey.ca/en/products/detail/alpha-wire/422807-RD005/4928104 | VCC on every cable. Per set and Spares are in feet (about 2 ft per wire, with waste); Needed and the order are 100 ft spools. 28 AWG 7/36 with 0.89 mm insulation: inside the GH contact's 26 to 30 AWG and 0.8 to 1.0 mm.
Wire, black | GND | Hook-up wire, 28 AWG stranded, PVC (UL1061), black, 100 ft | Alpha Wire | 422807 BK005 | A422807B-100-ND | 30 | 0 |  |  |  |  |  | 319 | https://www.digikey.ca/en/products/detail/alpha-wire/422807-BK005/4928099 | GND on every cable. Same wire as the red line.
Wire, yellow | SCL, Jetson TX | Hook-up wire, 28 AWG stranded, PVC (UL1061), yellow, 100 ft | Alpha Wire | 422807 YL005 | A422807Y-100-ND | 25 | 0 |  |  |  |  |  | 72 | https://www.digikey.ca/en/products/detail/alpha-wire/422807-YL005/4928108 | SCL, and TX on the Jetson cable. Same wire as the red line.
Wire, blue | SDA, Jetson RX | Hook-up wire, 28 AWG stranded, PVC (UL1061), blue, 100 ft | Alpha Wire | 422807 BL005 | A422807L-100-ND | 25 | 0 |  |  |  |  |  | 54 | https://www.digikey.ca/en/products/detail/alpha-wire/422807-BL005/4928100 | SDA, and RX on the Jetson cable. Same wire as the red line.
Wire, white | Other signals | Hook-up wire, 28 AWG stranded, PVC (UL1061), white, 100 ft | Alpha Wire | 422807 WH005 | A422807W-100-ND | 15 | 0 |  |  |  |  |  | 78 | https://www.digikey.ca/en/products/detail/alpha-wire/422807-WH005/4928107 | AUX1 signal, pot wiper and the spare SPI lines. Same wire as the red line.
Tools: one each for the team
Crimper | JST GH (and SH, Dupont, PH) contacts | Micro connector crimping pliers, 20 to 32 AWG (Engineer PA-09) | Adafruit | 350 | 1528-350-ND |  |  | 1 |  |  |  |  | 277 | https://www.digikey.ca/en/products/detail/adafruit-industries-llc/350/6026207 | The Engineer PA-09, sold by Adafruit as product 350. JST's own GH hand tool (YRS-1590) is $2,737 and out of stock. Practice on a few contacts before the real cables, and tug-test every crimp.
Wire stripper | 28 AWG wire | Adjustable wire stripper, 20 to 30 AWG | American Hakko | CSP-30-1 | 1691-1281-ND |  |  | 1 |  |  |  |  | 709 | https://www.digikey.ca/en/products/detail/american-hakko-products-inc/CSP-30-1/8346234 | Set the stop for 28 AWG so it doesn't nick the strands. Strip only enough to fill the contact's wire barrel.
Optional: sensors with a Qwiic or STEMMA QT jack
Qwiic cable, 150 mm | Sensor end for a Qwiic breakout | Cable, JST SH 4-pin on both ends, 150 mm (STEMMA QT / Qwiic) | Adafruit | 4397 | 1528-4397-ND | 0 | 0 |  |  |  |  |  | 8009 | https://www.digikey.ca/en/products/detail/adafruit-industries-llc/4397/10824270 | Type how many Qwiic sensors one set has in the yellow Per set cell. Cut each cable in half: each half is a sensor-end tail. Solder it to the 28 AWG wire and cover the joint with heat shrink. Qwiic is GND, VCC, SDA, SCL (black, red, blue, yellow) and centurion is VCC, SCL, SDA, GND, so match by colour, not position. JST SH contacts only take wire up to 0.8 mm over the insulation, so the wire above won't crimp into them. Cut 2.2k pull-ups on the breakout (sim/README.md).
 |  | Order total (CAD), at the order unit prices
 |  | Lines to order
 |  | Lines where DigiKey stock is below the order qty
Wiring, looking at the pins as numbered on centurion
Jack | Cable | Pins, 1 first | Wire colours
J6 to J13, J18 | GH 4-pin, I2C sensor | 1 VCC, 2 SCL, 3 SDA, 4 GND | red, yellow, blue, black
J14 AUX1 | GH 5-pin | 1 VCC, 2 GND, 3 SDA, 4 SCL, 5 signal | red, black, blue, yellow, white
J17 pot | GH 3-pin | 1 POT_VCC, 2 wiper, 3 GND | red, white, black
J4 Jetson | GH 3-pin | 1 TX (centurion out), 2 RX, 3 GND | yellow, blue, black. Cross TX and RX at the Jetson end.
J5 IMU | GH 8-pin, pre-crimped leads | 1 3V3, 2 GND, 3 SCK, 4 MOSI, 5 MISO, 6 CS, 7 INT1, 8 INT2 | One colour: mark pin 1 at both ends. 30 cm at most.
J15 spare SPI | GH 7-pin | 1 3V3, 2 GND, 3 SCK, 4 MOSI, 5 MISO, 6 CS, 7 INT | red, black, then white
J19 ramBar | GH 6-pin, pre-crimped leads | 1 5V, 2 TX (centurion out), 3 RX, 4 GND, 5 CANH, 6 CANL | One colour: mark pin 1. Twist 5 and 6. Check TX/RX against ramBar's jack.
Not listed: heat shrink; the sensor-end parts, which depend on the breakouts (solder the wires straight to header-pin breakouts, or use the Qwiic tails above); and the Jetson end of J4, which plugs onto 0.1 in header pins (a female jumper wire cut in half works). Upload: save the lines with an order qty as CSV, or use bom/centurion_cables_tools_DigiKey_upload.csv, which has the suggested quantities.

Sheet: Price breaks
Mfr part number | Min qty | Unit price (CAD) | Packaging
EEU-FR1H470 | 1 | $0.70000 | Bulk
EEU-FR1H470 | 10 | $0.43200 | Bulk
EEU-FR1H470 | 50 | $0.31780 | Bulk
EEU-FR1H470 | 200 | $0.25150 | Bulk
EEU-FR1H470 | 600 | $0.21365 | Bulk
EEU-FR1H470 | 1000 | $0.19946 | Bulk
EEU-FR1H470 | 2600 | $0.17757 | Bulk
EEU-FR1H470 | 5000 | $0.16549 | Bulk
CL32B106KBJNNNE | 1 | $1.02000 | Cut Tape
CL32B106KBJNNNE | 10 | $0.63600 | Cut Tape
CL32B106KBJNNNE | 50 | $0.48300 | Cut Tape
CL32B106KBJNNNE | 100 | $0.43600 | Cut Tape
CL32B106KBJNNNE | 500 | $0.35672 | Cut Tape
GRM31CR61A476ME15L | 1 | $0.61000 | Cut Tape
GRM31CR61A476ME15L | 10 | $0.36200 | Cut Tape
GRM31CR61A476ME15L | 50 | $0.26680 | Cut Tape
GRM31CR61A476ME15L | 100 | $0.23720 | Cut Tape
GRM31CR61A476ME15L | 500 | $0.18736 | Cut Tape
CC0805KRX7R9BB104 | 1 | $0.27000 | Cut Tape
CC0805KRX7R9BB104 | 10 | $0.14600 | Cut Tape
CC0805KRX7R9BB104 | 50 | $0.10180 | Cut Tape
CC0805KRX7R9BB104 | 100 | $0.08840 | Cut Tape
CC0805KRX7R9BB104 | 500 | $0.06584 | Cut Tape
SMBJ16A | 1 | $0.79000 | Cut Tape
SMBJ16A | 10 | $0.48700 | Cut Tape
SMBJ16A | 50 | $0.35220 | Cut Tape
SMBJ16A | 100 | $0.30840 | Cut Tape
SMBJ16A | 500 | $0.23086 | Cut Tape
SS14-E3/61T | 1 | $0.70000 | Cut Tape
SS14-E3/61T | 10 | $0.42500 | Cut Tape
SS14-E3/61T | 50 | $0.30680 | Cut Tape
SS14-E3/61T | 100 | $0.26820 | Cut Tape
SS14-E3/61T | 500 | $0.20024 | Cut Tape
2016L150/33DR | 1 | $1.32000 | Cut Tape
2016L150/33DR | 5 | $1.09800 | Cut Tape
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

Sheet: Stock check
Parts reused from the powerJackal and stellaNova orders: what is left over for centurion
Ordered = Order qty in each board's BOM xlsx (what was bought). Left over = ordered - boards built x qty per board, summed over both boards. The BOM tab's On hand column reads Left over from here.
Centurion boards to build
powerJackal boards built |  | 2
stellaNova boards built |  | 3
Ref | Mfr part number | Description | Qty per board | Spares | Need (boards x qty) | Need + spares | powerJackal qty per board | powerJackal ordered | stellaNova qty per board | stellaNova ordered | Left over | Short (with spares) | Verdict
C1 | EEU-FR1H470 | Aluminum electrolytic, 47 µF 50 V, 6.3 mm radial |  |  |  |  | 1 | 10
C2, C3, C16, C32 | CL32B106KBJNNNE | Ceramic capacitor, 10 µF 50 V X7R, 1210 |  |  |  |  | 3 | 25 | 1 | 10
C4, C5, C17 | GRM31CR61A476ME15L | Ceramic capacitor, 47 µF 10 V X5R, 1206 |  |  |  |  | 4 | 50
C6, C8, C9, C11, C12, C13, C14, C15, C19, C20, C21, C24, C25, C26, C27, C30 | CC0805KRX7R9BB104 | Ceramic capacitor, 100 nF 50 V X7R, 0805 |  |  |  |  | 6 | 100
D4 | SMBJ16A | TVS diode, 16 V standoff, unidirectional, SMB |  |  |  |  | 1 | 10
D9, D10 | SS14-E3/61T | Schottky diode, 40 V 1 A, SMA |  |  |  |  | 2 | 15
F1 | 2016L150/33DR | Polyfuse, 1.5 A hold, 33 V, 2016 |  |  |  |  | 1 | 10
J16 | USB4105-GF-A | USB-C receptacle, USB 2.0, 16 pin |  |  |  |  | 1 | 10 | 1 | 10
Q1 | AO3401A | P-channel MOSFET, -30 V, SOT-23 (USB power switch) |  |  |  |  | 1 | 10
R18, R32, R33 | RC0805FR-072K2L | Resistor, 2.2 kΩ 1%, 0805 |  |  |  |  | 1 | 100
R29 | RC0805FR-072K49L | Resistor, 2.49 kΩ 1%, 0805 (5 V feedback) |  |  |  |  | 1 | 110
R31, R37, R48 | RMCF0805FT5K10 | Resistor, 5.1 kΩ 1%, 0805 |  |  |  |  | 2 | 250
U1 | TPSM53602RDAR | 5 V step-down power module, 2 A, B3QFN-14 |  |  |  |  | 1 | 5
U7 | MCP1826ST-3302E/DB | LDO regulator, 3.3 V 1 A, SOT-223 |  |  |  |  | 1 | 10
U13 | USBLC6-2SC6 | USB ESD protection, SOT-23-6 |  |  |  |  | 1 | 10 | 1 | 10
D5, D11 | B340A-13-F | Schottky diode, 40 V 3 A, SMA (smart port OR diodes) |  |  |  |  | 2 | 25
J1, J2 | 0955012441 | Smart port jack, 4P4C modular, right angle, through hole |  |  |  |  | 1 | 10 | 1 | 10
U14, U15 | MAX33071EASA+ | RS-485 transceiver, half duplex, 3.3 V, ±65 V fault protected, 2 Mbps, SOIC-8 |  |  |  |  |  |  | 1 | 10
C10, C28, C29 | GRM21BR61E106KA73K | Ceramic capacitor, 10 µF 25 V X5R, 0805 |  |  |  |  |  |  | 2 | 15
C18 | CC0805KKX7R8BB105 | Ceramic capacitor, 1 µF 25 V X7R, 0805 |  |  |  |  | 1 | 20
D6, LED1, LED2 | LTST-C191KGKT | LED, green, 0603 |  |  |  |  |  |  | 1 | 10
D7 | LTST-C191KFKT | LED, orange, 0603 |  |  |  |  |  |  | 1 | 10
D8 | LTST-C191KRKT | LED, red, 0603 |  |  |  |  |  |  | 1 | 10
R2, R10, R17, R30, R34, R45, R46, R49, R50, R54, R56, R57, R58 | RC0805FR-0710KL | Resistor, 10 kΩ 1%, 0805 |  |  |  |  | 7 | 100
R3, R4, R5, R44 | RC0805FR-071KL | Resistor, 1 kΩ 1%, 0805 |  |  |  |  | 1 | 100
SW1, SW2 | TL3342F160QG | Tactile switch, SMD, low profile |  |  |  |  | 2 | 12
R11, R12 | RC0805FR-074K7L | Resistor, 4.7 kΩ 1%, 0805 |  |  |  |  | 2 | 250
Blue cells are inputs copied from the powerJackal and stellaNova BOMs, black cells are formulas.

Sheet: DigiKey upload
Quantity | Manufacturer Part Number | Manufacturer | DigiKey Part Number | Customer Reference
This sheet follows the Order qty column on the BOM tab and lists the fitted parts bought from DigiKey (not fitted R36, R51, R52 and the team-stock header strip are left out; the JST GH right-angle headers J6-J13, J18 and J17 are bought from LCSC only (LCSC order tab)). Lines with quantity 0 are covered by parts left over from earlier orders: delete them before uploading. After changing quantities, save this sheet as CSV and upload it in DigiKey BOM Manager on digikey.ca. The CSV sent with this file uses the suggested quantities and leaves out the 0 lines.

Sheet: LCSC order
LCSC order: JST GH right-angle headers (0 at DigiKey CA and Mouser on Nov 5, 2026)
USD to CAD rate (edit) |  | 1.4 | Estimate: web sources gave 1.35-1.41 on Nov 5, 2026. LCSC sells in USD only. The BOM tab prices these two lines in CAD with this rate.
Quantity | Manufacturer Part Number | Manufacturer | LCSC Part Number | Customer Reference | Unit price at qty (USD) | Line total (USD) | LCSC stock (Nov 5, 2026) | Link
 | SM04B-GHS-TB(LF)(SN) | JST | C189895 |  |  |  | 17515 | https://www.lcsc.com/product-detail/C189895.html
 | SM03B-GHS-TB(LF)(SN) | JST | C514175 |  |  |  | 30395 | https://www.lcsc.com/product-detail/C514175.html
 |  |  |  |  | Total (USD)
 |  |  |  |  | Total (CAD, at the rate above)
Upload: in LCSC BOM Tool (lcsc.com, BOM Tool), upload centurion_revA_LCSC_upload.csv and map Quantity and LCSC Part Number. Shipping and import duties to Canada are extra and shown at checkout.

Sheet: Design notes
Topic | Note
Board | 103.2 x 62.6 mm, 4 layers, 1.6 mm: F.Cu signals, In1 solid GND plane, In2 +3.3 V plane, B.Cu signals with a GND pour. Four 4.5 mm #8-32 holes for the VEX bracket, not tied to GND. Order a standard 4-layer board with no impedance control, ENIG or lead-free HASL.
MCU | STM32G491RET6 (U3), LQFP-64, 170 MHz Cortex-M4F with FDCAN. Y1 8 MHz crystal with C22/C23 10 pF: CAN FD needs the crystal's accuracy. Full pin map in centurion/README.md.
Power | Smart port battery through the OR diodes D5/D11 and F1 to U1 (TPSM53602, 5.0 V, same as powerJackal), then U7 (MCP1826S) for 3.3 V. On USB-C alone, Q1 feeds the 3.3 V side and the 5 V jacks stay off.
USB hot-plug | C33 (47 µF polymer tantalum) on 5V_LDO keeps the USB plug-in spike to about 5.3 V. See centurion/sim/README.md.
Smart ports | J1, J2: two MAX33071E half-duplex RS-485 transceivers (U14, U15) on USART2 and USART3, with hardware DE. RE is tied low, so the MCU hears its own bytes.
Sensor ports | U6 TCA9548A I2C mux to J6 to J13 (JST GH 4-pin), plus J18 on I2C bus 2, J14 AUX1 and J17 pot. Each jack picks 3.3 V or 5 V with a shunt on JP1 to JP10. 2.7k pullups go to each jack's VCC. F2 (3.3 V) and F3 (5 V) are 0.5 A hold polyfuses.
ESD | TPD4E05U06-Q1 clamps (U5, U8 to U12, U17) sit between every cable connector and the rest of the board. D12 NUP2105L clamps CANH/CANL, U13 USBLC6 the USB lines.
ramBar link | J19 (JST GH 6-pin): 5 V through F4 (0.75 A hold), UART5, and CAN FD through U16 TCAN334G. R53 terminates this end of the bus; ramBar needs 120 Ω at its end too.
IMU and Jetson | J5 (8-pin) carries the IMU's SPI with 100 Ω series resistors R8, R9, R41 on SCK, MOSI and CS; J15 (7-pin) is a spare SPI port. J4 (3-pin) is the Jetson backup UART.
Programming | USB DFU from the ROM bootloader: hold BOOT, tap RESET. Unplug the smart ports, the IMU and ramBar while flashing. J3 is SWD for step-through debugging only.
Stock (Nov 4, 2026) | Out of stock at DigiKey CA, restock expected: TCA9548APWR (Nov 10), SM04B-GHS-TB and SM03B-GHS-TB (Nov 16), RC0805FR-07470RL (Nov 9). TPD4E05U06DQAR was out until February 2027, so the board uses TPD4E05U06QDQARQ1 instead.
Not in this list | PCB, VEX smart cables, sensors (JST GH cable parts and crimping tools are on the Cables and tools tab), USB-C cable, #8-32 screws and standoffs, solder paste and stencil. TP1 to TP12 are bare copper pads, so they are not parts.
