UW-VexU/UWAT-Centurion-Board/imuBoard/bom/imuBoard_revA_BOM.xlsx

Sheet: BOM
Centurion IMU board, Bill of Materials, Rev A (BMI270 on SPI, plugs into centurion J5, 38 x 24 mm, 2 layers)
UWAT VEXU. DigiKey Canada stock and CAD price breaks, read from digikey.ca on November 4, 2026 (parts shared with centurion: from centurion's BOM, read the same day). The unit price follows the order quantity, using the breaks on the Price breaks tab.
Boards to build |  | 4 | Edit the yellow cells. Type your own quantity in the yellow Your order qty column to override the suggested one.
Ref | Block | Description | Manufacturer | Mfr part number | DigiKey part number | Qty per board | Spares | Needed (boards x qty + spares) | Your order qty (optional) | Order qty | Unit price at order qty (CAD) | Order cost (CAD) | Next price break (qty) | Unit price at next break (CAD) | Tip | DigiKey stock | DigiKey Canada link | Notes
U1 | IMU | 6-axis IMU (accelerometer and gyroscope), LGA-14 2.5 x 3.0 mm | Bosch Sensortec | BMI270 | 828-1091-1-ND | 1 | 1 | 5 |  | 5 | $5.9960 | $29.98 | 10 | $5.7370 |  | 32589 | https://www.digikey.ca/en/products/detail/bosch-sensortec/BMI270/9974486 | Reflow or hot air: the pads are under the part. Firmware uploads Bosch's config file at every power-up.
U2 | Cable jack | ESD protection, 4 channel, USON-10 (automotive grade) | Texas Instruments | TPD4E05U06QDQARQ1 | 296-40696-1-ND | 1 | 1 | 5 |  | 5 | $2.0600 | $10.30 | 10 | $1.3010 |  | 132598 | https://www.digikey.ca/en/products/detail/texas-instruments/TPD4E05U06QDQARQ1/4972148 | Same part as centurion U5, U8 to U12, U17. Flow-through: the traces run over pins 6, 7, 9 and 10.
J1 | Cable jack | JST GH 8-pin, vertical (top entry) SMD | JST | BM08B-GHS-TBT | 455-BM08B-GHS-TBTCT-ND | 1 | 0 | 4 |  | 4 | $0.7400 | $2.96 | 10 | $0.6360 |  | 35607 | https://www.digikey.ca/en/products/detail/jst-sales-america-inc/BM08B-GHS-TBT/807806 | Same jack as centurion J5; the cable is straight through (pin n to pin n). Cable parts are on centurion's Cables and tools tab.
R1 | IMU | Resistor, 100 Ω 1%, 0805 | Yageo | RC0805FR-07100RL | 311-100CRCT-ND | 1 | 2 | 6 | 10 | 10 | $0.0600 | $0.60 | 25 | $0.0448 |  | 926187 | https://www.digikey.ca/en/products/detail/yageo/RC0805FR-07100RL/727543 | MISO series resistor, same part as centurion R8, R9, R41, R55.
C1, C2 | IMU | Ceramic capacitor, 100 nF 50 V X7R, 0805 | Yageo | CC0805KRX7R9BB104 | 311-1140-1-ND | 2 | 2 | 10 |  | 10 | $0.1460 | $1.46 | 50 | $0.1018 |  | 4955773 | https://www.digikey.ca/en/products/detail/yageo/CC0805KRX7R9BB104/302874 | C1 at VDD (pin 8), C2 at VDDIO (pin 5).
C3 | Cable jack | Ceramic capacitor, 1 µF 25 V X7R, 0805 | Yageo | CC0805KKX7R8BB105 | 311-1456-1-ND | 1 | 2 | 6 | 10 | 10 | $0.2390 | $2.39 | 50 | $0.1704 |  | 327549 | https://www.digikey.ca/en/products/detail/yageo/CC0805KKX7R8BB105/2833621 | Bulk at the board input.
 |  | Order total (CAD), at the order unit prices |  |  |  |  |  |  |  |  |  | $47.69
 |  | Parts cost for 1 board at the order unit prices |  |  |  |  |  |  |  |  |  | $9.39
 |  | Lines to order |  |  |  |  |  |  |  |  |  | 6
 |  | Lines where DigiKey stock is below the order qty |  |  |  |  |  |  |  |  |  | 0
Unit prices are digikey.ca CAD on cut tape, at the price break for the order qty. The yellow order quantities are suggestions: what is needed, rounded up to a price break when that costs at most $0.50 more in total. Tip: a filled tip means buying up to the next break costs less in total. Stock turns red if it is below the order qty. H1 and H2 are screw holes, not parts. The PCB itself, the cable (centurion's Cables and tools tab), screws and shipping are not included. U2, R1, C1 to C3 and J1 are centurion parts too: when both boards are ordered together, combine those lines. Blue cells are inputs, black cells are formulas.

Sheet: Price breaks
Mfr part number | Min qty | Unit price (CAD) | Packaging
BMI270 | 1 | $6.7000 | Cut Tape
BMI270 | 5 | $5.9960 | Cut Tape
BMI270 | 10 | $5.7370 | Cut Tape
BMI270 | 25 | $5.4268 | Cut Tape
TPD4E05U06QDQARQ1 | 1 | $2.0600 | Cut Tape
TPD4E05U06QDQARQ1 | 10 | $1.3010 | Cut Tape
TPD4E05U06QDQARQ1 | 50 | $0.9676 | Cut Tape
TPD4E05U06QDQARQ1 | 100 | $0.8594 | Cut Tape
TPD4E05U06QDQARQ1 | 500 | $0.6696 | Cut Tape
BM08B-GHS-TBT | 1 | $0.7400 | Cut Tape
BM08B-GHS-TBT | 10 | $0.6360 | Cut Tape
BM08B-GHS-TBT | 100 | $0.5404 | Cut Tape
BM08B-GHS-TBT | 500 | $0.4823 | Cut Tape
BM08B-GHS-TBT | 1000 | $0.4592 | Cut Tape
RC0805FR-07100RL | 1 | $0.1600 | Cut Tape
RC0805FR-07100RL | 10 | $0.0600 | Cut Tape
RC0805FR-07100RL | 25 | $0.0448 | Cut Tape
RC0805FR-07100RL | 50 | $0.0368 | Cut Tape
RC0805FR-07100RL | 100 | $0.0304 | Cut Tape
RC0805FR-07100RL | 250 | $0.0240 | Cut Tape
RC0805FR-07100RL | 500 | $0.0204 | Cut Tape
RC0805FR-07100RL | 1000 | $0.0175 | Cut Tape
CC0805KRX7R9BB104 | 1 | $0.2700 | Cut Tape
CC0805KRX7R9BB104 | 10 | $0.1460 | Cut Tape
CC0805KRX7R9BB104 | 50 | $0.1018 | Cut Tape
CC0805KRX7R9BB104 | 100 | $0.0884 | Cut Tape
CC0805KRX7R9BB104 | 500 | $0.0658 | Cut Tape
CC0805KKX7R8BB105 | 1 | $0.4200 | Cut Tape
CC0805KKX7R8BB105 | 10 | $0.2390 | Cut Tape
CC0805KKX7R8BB105 | 50 | $0.1704 | Cut Tape
CC0805KKX7R8BB105 | 100 | $0.1495 | Cut Tape
CC0805KKX7R8BB105 | 500 | $0.1146 | Cut Tape
Source: digikey.ca product pages, CAD, November 4, 2026. One block per part, smallest break first. To update a price, edit the blue cells; add rows for new breaks inside the block of the same part, because the BOM tab takes the last break at or below the order quantity.

Sheet: DigiKey upload
Quantity | Manufacturer Part Number | Manufacturer | DigiKey Part Number | Customer Reference
5 | BMI270 | Bosch Sensortec | 828-1091-1-ND | U1
5 | TPD4E05U06QDQARQ1 | Texas Instruments | 296-40696-1-ND | U2
4 | BM08B-GHS-TBT | JST | 455-BM08B-GHS-TBTCT-ND | J1
10 | RC0805FR-07100RL | Yageo | 311-100CRCT-ND | R1
10 | CC0805KRX7R9BB104 | Yageo | 311-1140-1-ND | C1, C2
10 | CC0805KKX7R8BB105 | Yageo | 311-1456-1-ND | C3
This sheet follows the Order qty column on the BOM tab. After changing quantities, save this sheet as CSV and upload it in DigiKey BOM Manager on digikey.ca. The CSV sent with this file uses the suggested quantities.

Sheet: Design notes
Topic | Note
Board | 38 x 24 mm, 2 layers, 1.6 mm, GND pour on both sides. Two #8-32 holes (4.5 mm), 25.4 mm (1 in) apart on the long axis, not tied to GND, with a 5 mm copper keepout for the screw heads. Order a standard 2-layer board, ENIG or lead-free HASL.
IMU | U1 BMI270 on 4-wire SPI, 10 MHz max. ASDx, ASCx, OCSB and OSDO unconnected (BMI270 datasheet pin table). Firmware must do a dummy read to select SPI, then upload Bosch's 8 kB config file at every power-up.
Axes | Printed on the top silkscreen: +X toward J1, +Y toward H2, +Z up out of the board (BMI270 datasheet section 8.2, with U1 turned 180 degrees).
Cable | J1 matches centurion J5 pin for pin, so the cable is straight through: 1 3V3, 2 GND, 3 SCK, 4 MOSI, 5 MISO, 6 CS, 7 INT1, 8 INT2. Keep it 30 cm or less (centurion/sim/README.md); the JST pre-crimped 305 mm leads fit exactly.
Signal integrity | Centurion has 100 Ω in series with SCK, MOSI and CS (R8, R9, R41). R1 (100 Ω) does the same for MISO at the IMU: in centurion's spi_imu.cir it cuts the MISO overshoot at the MCU from 4.7 V to 3.6 V and lets a 0.5 m cable pass at any GPIO speed.
ESD | U2 TPD4E05U06-Q1 clamps SCK, MOSI, MISO and CS at the jack. INT1 and INT2 are outputs of the IMU and are not clamped.
Not in this list | PCB, the J5 cable (see centurion's BOM, Cables and tools tab), #8-32 screws and nuts, solder paste and stencil.
