UW-VexU/UWAT-Centurion-Board/powerJackal/bom/powerJackal_revA_DigiKey_upload.csv

Quantity | Manufacturer Part Number | Manufacturer | DigiKey Part Number | Customer Reference
10 | 0955012441 | Molex | WM5568-ND | J1
10 | 1935161 | Phoenix Contact | 277-1667-ND | J2
25 | B340A-13-F | Diodes Incorporated | B340A-FDICT-ND | D3, D5
10 | 2016L150/33DR | Littelfuse | 18-2016L150/33DRCT-ND | F1
10 | SMBJ16A | Littelfuse | SMBJ16ALFCT-ND | D1
10 | EEU-FR1H470 | Panasonic | P124235-ND | C1
5 | TPSM53602RDAR | Texas Instruments | 296-TPSM53602RDARCT-ND | U1
25 | CL32B106KBJNNNE | Samsung Electro-Mechanics | 1276-3387-1-ND | C2, C3, C10
50 | GRM31CR61A476ME15L | Murata | 490-5528-1-ND | C4, C5, C11, C12
110 | RC0805FR-072K49L | Yageo | 311-2.49KCRCT-ND | R4
12 | INA226AIDGSR | Texas Instruments | 296-29034-1-ND | U2, U3, U5
25 | WSL1206R0200FEA | Vishay Dale | WSLC-.02CT-ND | R1, R2
12 | WSL1206R0500FEA | Vishay Dale | WSLC-.05CT-ND | R12
100 | CC0805KRX7R9BB104 | Yageo | 311-1140-1-ND | C6 to C8, C13 to C15
20 | CC0805KKX7R8BB105 | Yageo | 311-1456-1-ND | C9
250 | RC0805FR-074K7L | Yageo | 311-4.70KCRCT-ND | R5, R6
10 | SM04B-SRSS-TB | JST | 455-SM04B-SRSS-TBCT-ND | J3
10 | MCP1826ST-3302E/DB | Microchip Technology | MCP1826ST-3302E/DBCT-ND | U6
15 | SS14-E3/61T | Vishay | SS14-E3/61TGICT-ND | D2, D4
10 | ESP32-C3-MINI-1U-N4X | Espressif Systems | 1965-ESP32-C3-MINI-1U-N4XCT-ND | U4
10 | USB4105-GF-A | GCT | 2073-USB4105-GF-ACT-ND | J7
10 | AO3401A | Alpha & Omega Semiconductor | 785-1001-1-ND | Q1
10 | USBLC6-2SC6 | STMicroelectronics | 497-5235-1-ND | U7
250 | RMCF0805FT5K10 | Stackpole Electronics | RMCF0805FT5K10CT-ND | R14, R15
100 | RC0805FR-0710KL | Yageo | 311-10.0KCRCT-ND | R3, R7, R8, R17, R21, R22, R23
100 | RC0805FR-0722RL | Yageo | 311-22.0CRCT-ND | R24, R25
100 | RC0805FR-071KL | Yageo | 311-1.00KCRCT-ND | R20
12 | TL3342F160QG | E-Switch | EG2531CT-ND | SW1, SW2
25 | LTST-C171GKT | Lite-On | 160-1423-1-ND | LED1 to LED3
100 | RC0805FR-072K2L | Yageo | 311-2.20KCRCT-ND | R9
10 | 1803277 | Phoenix Contact | 277-1206-ND | J6, J9
10 | 1803578 | Phoenix Contact | 277-1161-ND | J6 plug, J9 plug
