UW-VexU/UWAT-Centurion-Board/stellaNova/bom/uwat-stellaNova-BOM-JLCPCB.csv

Comment | Designator | Footprint | MPN
10uF 50V | C1 | C_1210_3225Metric | CL32B106KBJNNNE
100nF | C2,C3,C7,C9,C12 | C_0603_1608Metric | CC0603KRX7R9BB104
22uF | C4,C5 | C_0805_2012Metric | GRM21BR61A226ME51L
10uF | C8,C11 | C_0805_2012Metric | GRM21BR61E106KA73K
1uF | C10 | C_0603_1608Metric | C1608X5R1H105K080AB
56pF | C13 | C_0603_1608Metric | C0603C560J5GACTU
SMAJ18A | D1 | D_SMA | SMAJ18A
PMEG6020ER | D2,D3 | Nexperia_CFP3_SOD-123W | PMEG6020ER,115
USBLC6-2SC6 | D5 | SOT-23-6 | USBLC6-2SC6
Green | D6 | LED_0603_1608Metric | LTST-C191KGKT
Orange | D7 | LED_0603_1608Metric | LTST-C191KFKT
Red | D8 | LED_0603_1608Metric | LTST-C191KRKT
PTC 0.5 A 30 V | F1 | Fuse_1812_4532Metric | 0ZCG0050AF2C
V5 smart port (4P4C) | J1 | Molex_95501-2441_4P4C_Horizontal | 0955012441
USB-C 2.0 | J2 | USB_C_Receptacle_GCT_USB4105-xx-A_16P_TopMnt_Horizontal | USB4105-GF-A
microSD push-push | J3 | microSD_HC_Hirose_DM3AT-SF-PEJM5 | DM3AT-SF-PEJM5
10uH | L1 | L_Wuerth_MAPI-4030 | 74438357100
100k | R1 | R_0603_1608Metric | RMCF0603FT100K
10k | R3,R5,R6,R9,R10,R11,R12,R13,R14 | R_0603_1608Metric | RC0603FR-1310KL
5.1k | R7,R8,R22 | R_0603_1608Metric | RC0603FR-075K1L
1k | R15,R16,R17 | R_0603_1608Metric | RC0603FR-071KL
22 | R18,R19 | R_0603_1608Metric | RMCF0603FT22R0
93.1k | R20 | R_0603_1608Metric | RMCF0603FT93K1
30.1k | R21 | R_0603_1608Metric | RC0603FR-0730K1L
Tactile | SW1,SW2 | SW_SPST_PTS810 | PTS810 SJM 250 SMTR LFS
ESP32-S3-WROOM-1-N16R2 | U1 | ESP32-S3-WROOM-1 | ESP32-S3-WROOM-1-N16R2
AP63301WU-7 | U2 | TSOT-23-6 | AP63301WU-7
MAX33071EASA+ | U3 | SOIC-8_3.9x4.9mm_P1.27mm | MAX33071EASA+
Header 1x02 | J4 | PinHeader_1x02_P2.54mm_Vertical_Compact | PRPC040SAAN-RC
Header 1x01 | J5,J6 | PinHeader_1x01_P2.54mm_Vertical_Compact | PRPC040SAAN-RC
