UW-VexU/UWAT-Centurion-Board/centurion/bom/centurion_revA_LCSC_upload.csv

Quantity | Manufacturer Part Number | Manufacturer | LCSC Part Number | Customer Reference
55 | SM04B-GHS-TB(LF)(SN) | JST | C189895 | J6, J7, J8, J9, J10, J11, J12, J13, J18
10 | SM03B-GHS-TB(LF)(SN) | JST | C514175 | J17
