UW-VexU/UWAT-Centurion-Board/stellaNova/3dmodels/CK_PTS810.step

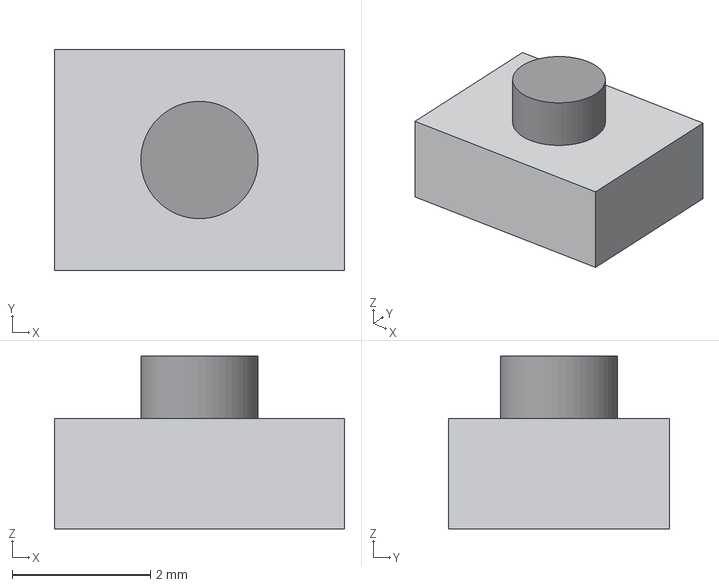
[picture p14: CAD file, 2026-10-31]
stellaNova/3dmodels/CK_PTS810.step
4.20 x 3.20 x 2.50 mm
