UW-VexU/UWAT-Centurion-Board/stellaNova/docs/uwat-stellaNova.step

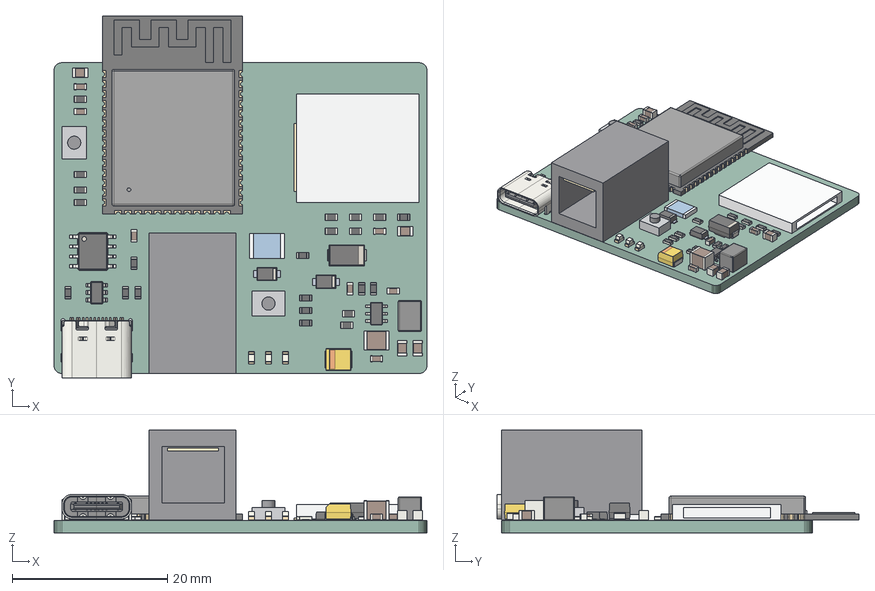
[picture p15: CAD file, 2026-10-31]
stellaNova/docs/uwat-stellaNova.step
48.0 x 46.6 x 13.2 mm
C_0603_1608Metric x 7
R_0603_1608Metric x 22
C_1210_3225Metric
SOIC_8_39x49mm_P127mm
C_0805_2012Metric x 4
USB_C_Receptacle_16P_TopMnt_Horizontal_GCT_USB4105-xx-A
LED_0603_1608Metric x 3
CP_EIA_3528_21_Kemet_B
ESP32-S3-WROOM-1
CQ assembly x 2
D_SMA
TSOT_23_6
SOT_23_6
L_Wuerth_MAPI_4030
uwat-stellaNova PCB
