UW-VexU/UWAT-Centurion-Board/stellaNova/3dmodels/Molex_0955012401.step

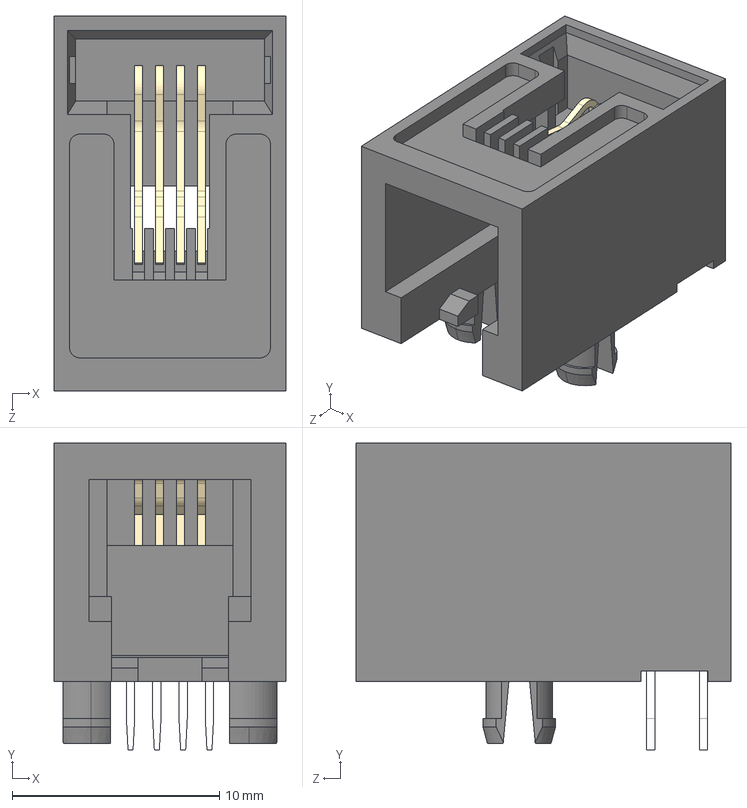
[picture p16: CAD file, 2026-10-31]
stellaNova/3dmodels/Molex_0955012401.step
11.2 x 14.8 x 18.1 mm
