UW-VexU/UWAT-Centurion-Board/powerJackal/docs/board_viewer/views/assembly.png

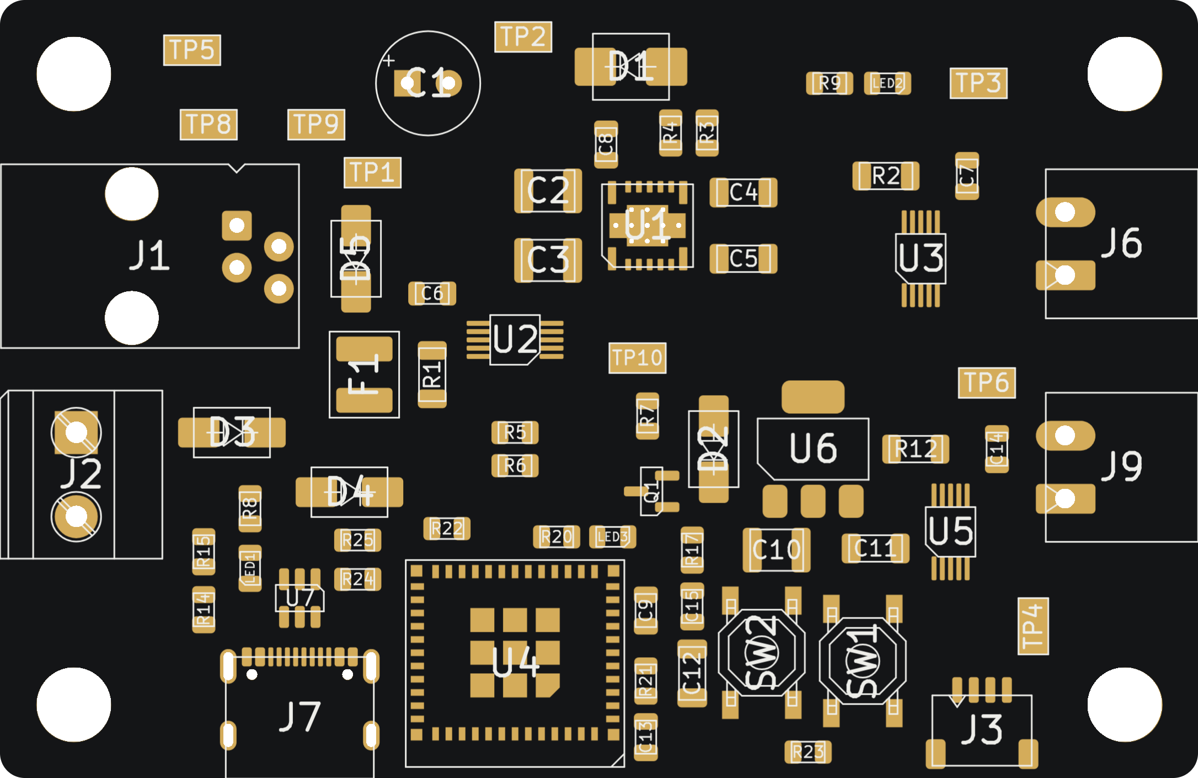
powerJackal/docs/board_viewer/views/assembly.png
