UW-VexU/UWAT-Centurion-Board/imuBoard/docs/imuBoard_schematic.pdf

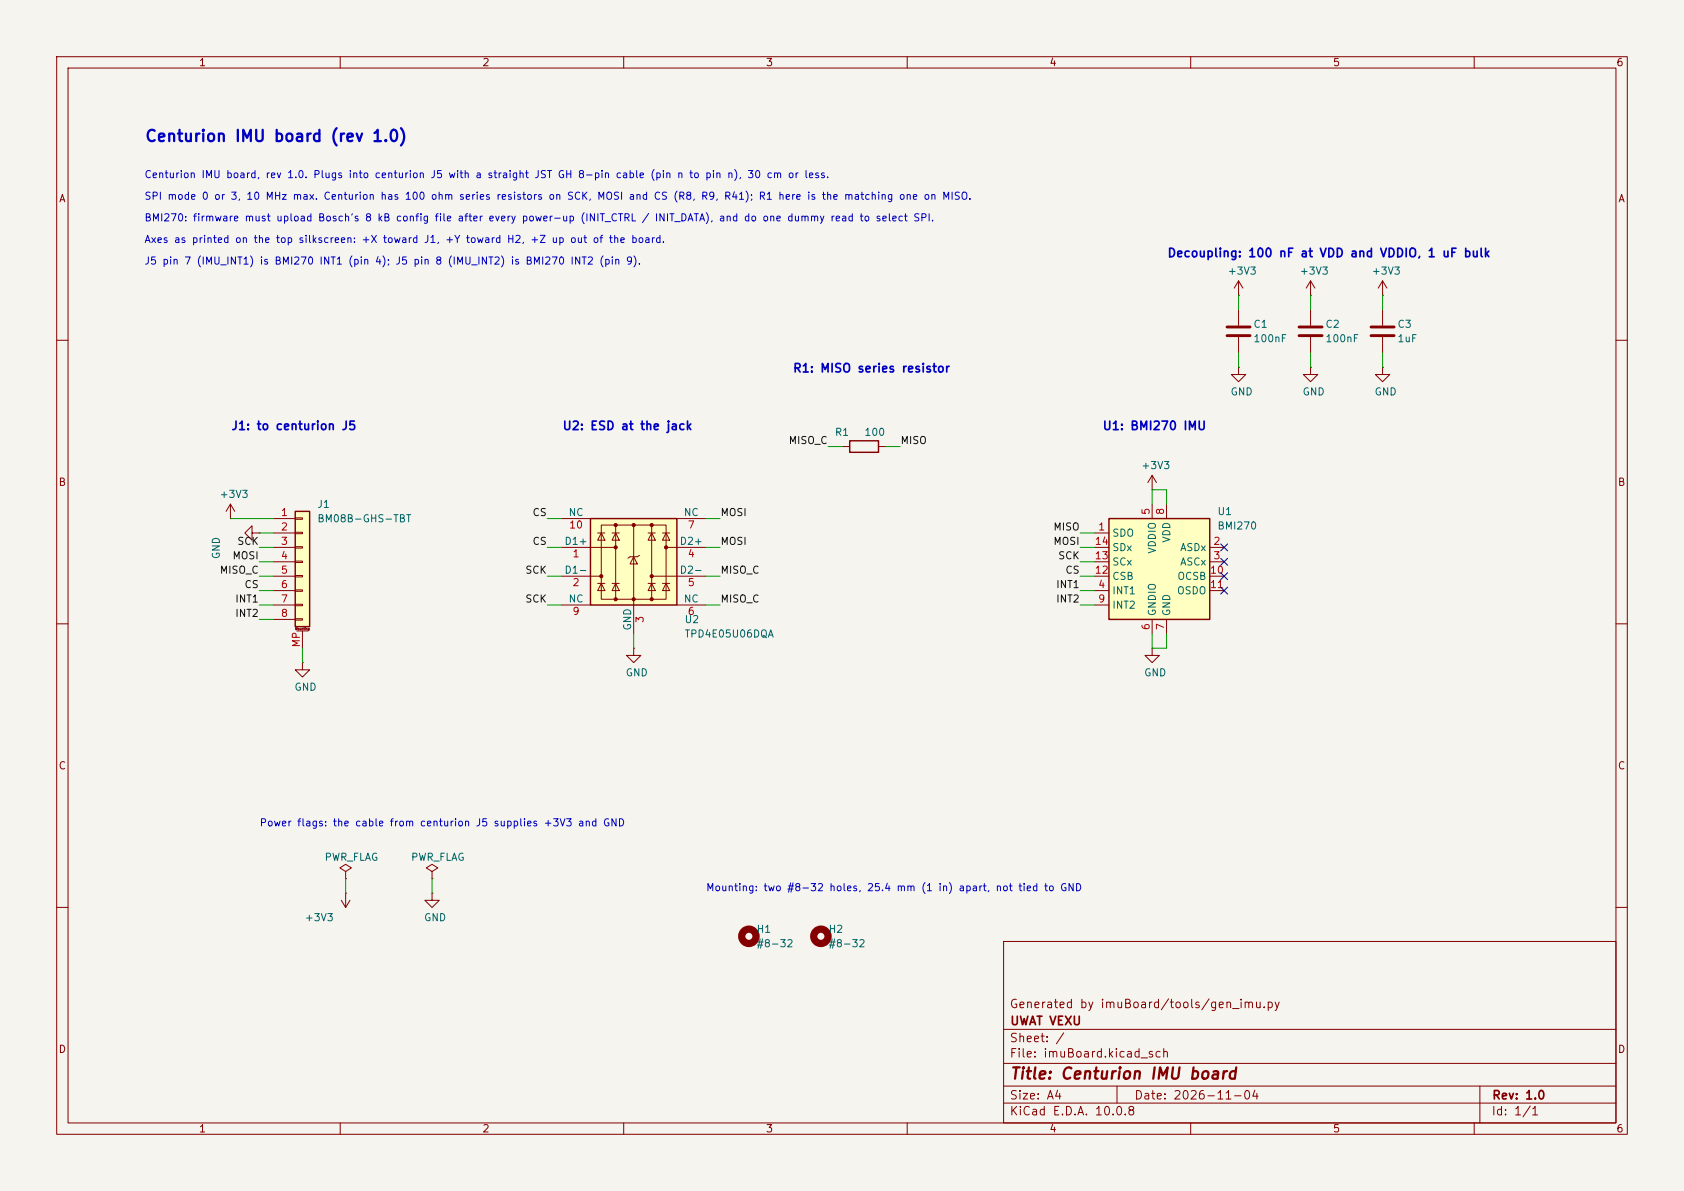
[picture p18: page 1]

Centurion IMU board (rev 1.0)

Decoupling: 100 nF at VDD and VDDIO, 1 uF bulk

J5 pin 7 (IMU_INT1) is BMI270 INT1 (pin 4); J5 pin 8 (IMU_INT2) is BMI270 INT2 (pin 9).

Power flags: the cable from centurion J5 supplies +3V3 and GND U2: ESD at the jack

Generated by imuBoard/tools/gen_imu.py PWR_FLAG

UWAT VEXU
Sheet: /
File: imuBoard.kicad_sch
Title: Centurion IMU board

Size: A4 | Rev: 1.0
KiCad E.D.A. 10.0.8 | Id: 1/1
