UW-VexU/UWAT-Centurion-Board/centurion/docs/centurion_revA_schematic.pdf

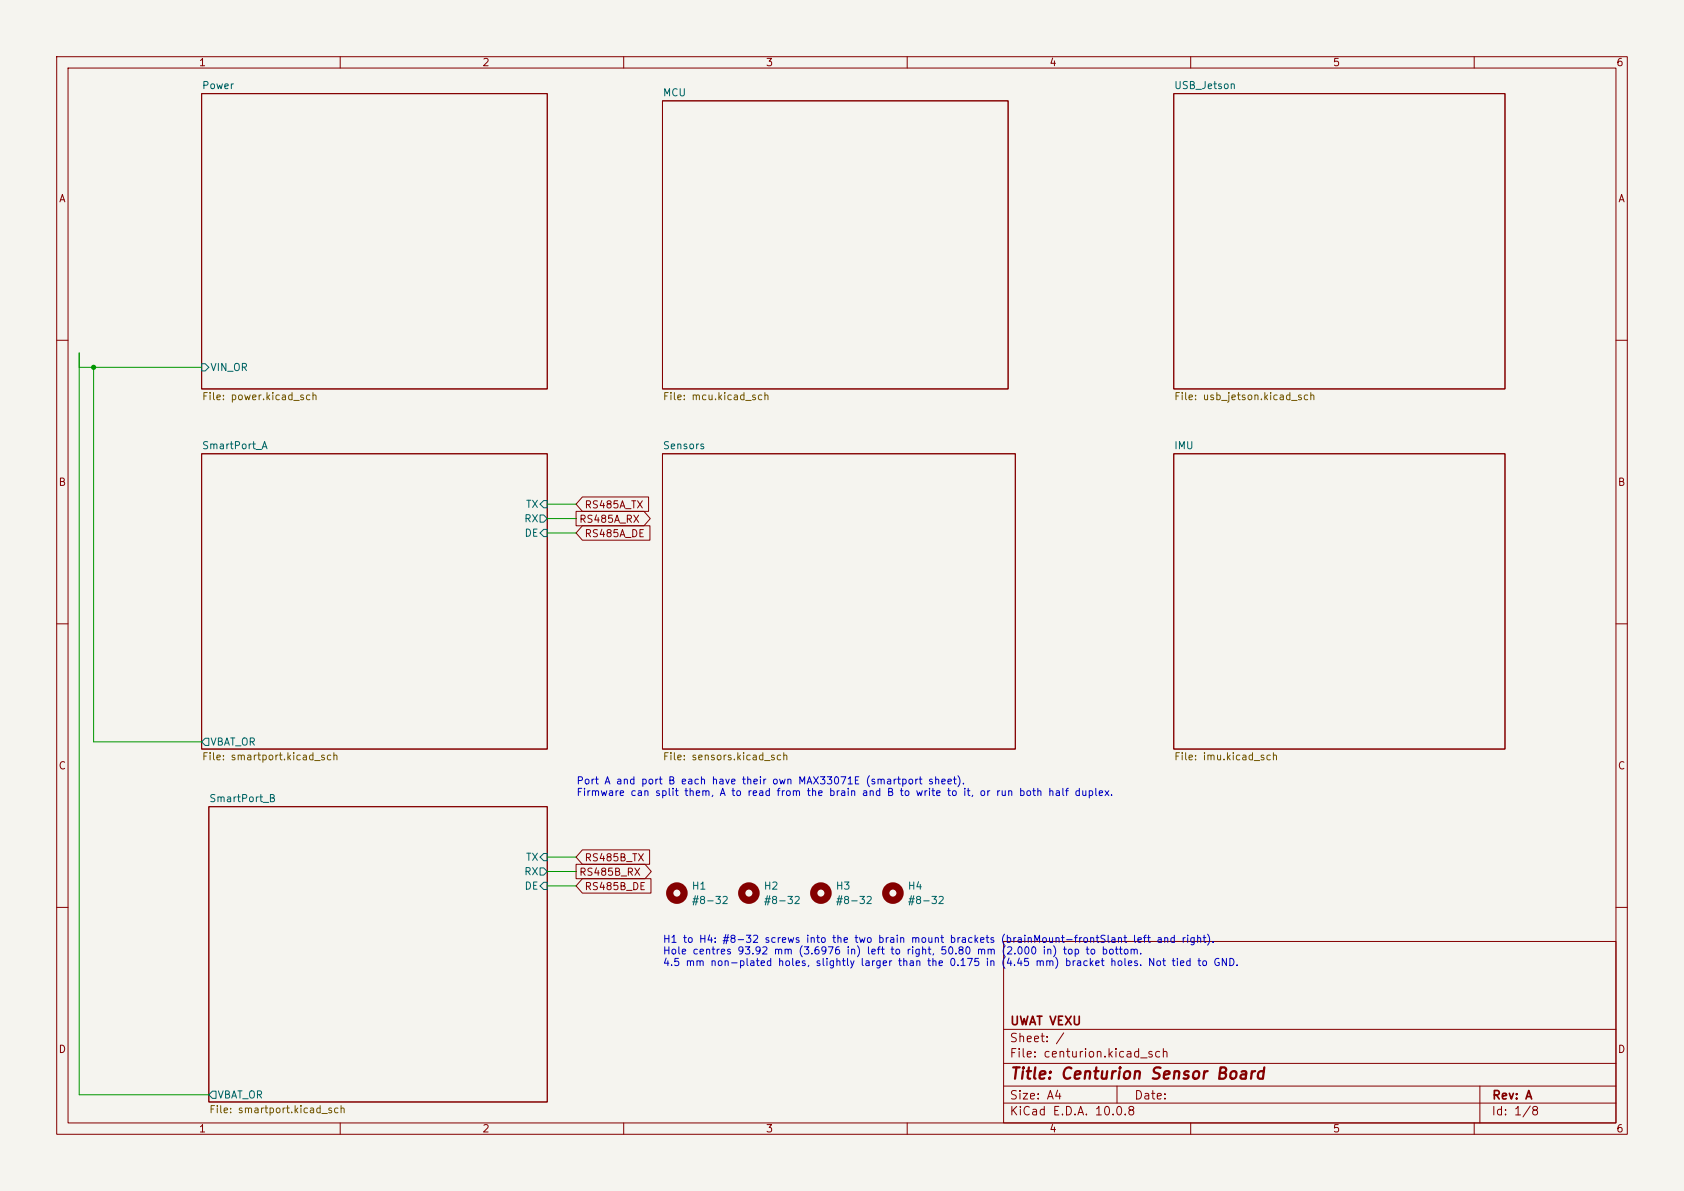
[picture p19: page 1]

File: mcu.kicad_sch Sensors File: sensors.kicad_sch

RS485B_DE Port A and port B each have their own MAX33071E (smartport sheet). Firmware can split them, A to read from the brain and B to write to it, or run both half duplex. H1 to H4: #8-32 screws into the two brain mount brackets (brainMount-frontSlant left and right). Hole centres 93.92 mm (3.6976 in) left to right, 50.80 mm (2.000 in) top to bottom. 4.5 mm non-plated holes, slightly larger than the 0.175 in (4.45 mm) bracket holes. Not tied to GND.

UWAT VEXU
Sheet: /
File: centurion.kicad_sch
Title: Centurion Sensor Board

Size: A4 | Rev: A
KiCad E.D.A. 10.0.8 | Id: 1/8

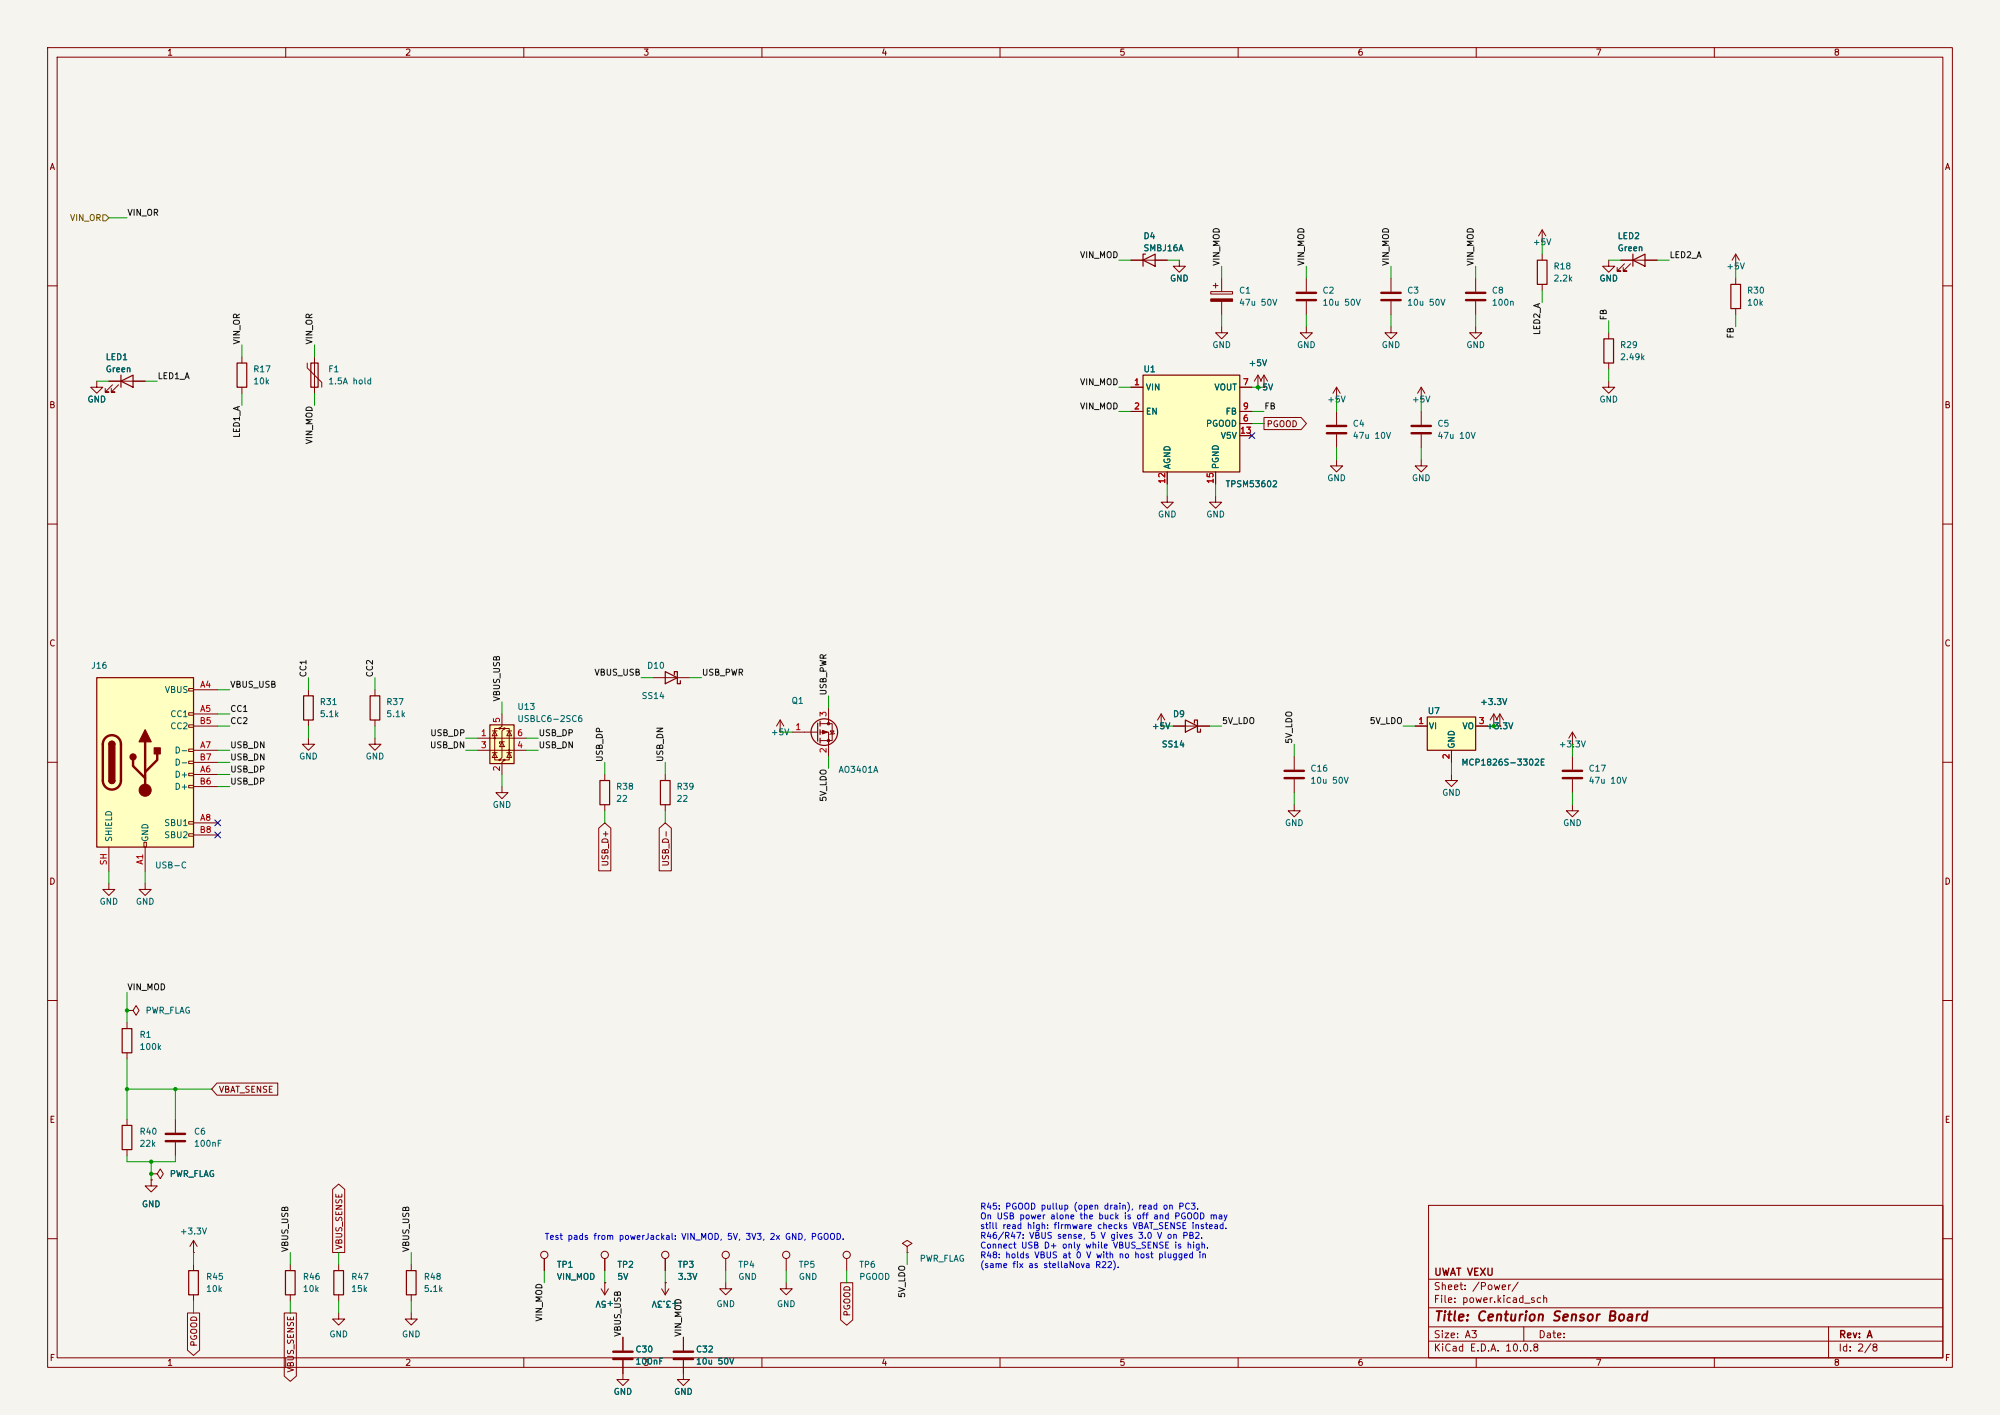
[picture p20: page 2]

(same fix as stellaNova R22).

UWAT VEXU
Sheet: /Power/
File: power.kicad_sch
Title: Centurion Sensor Board

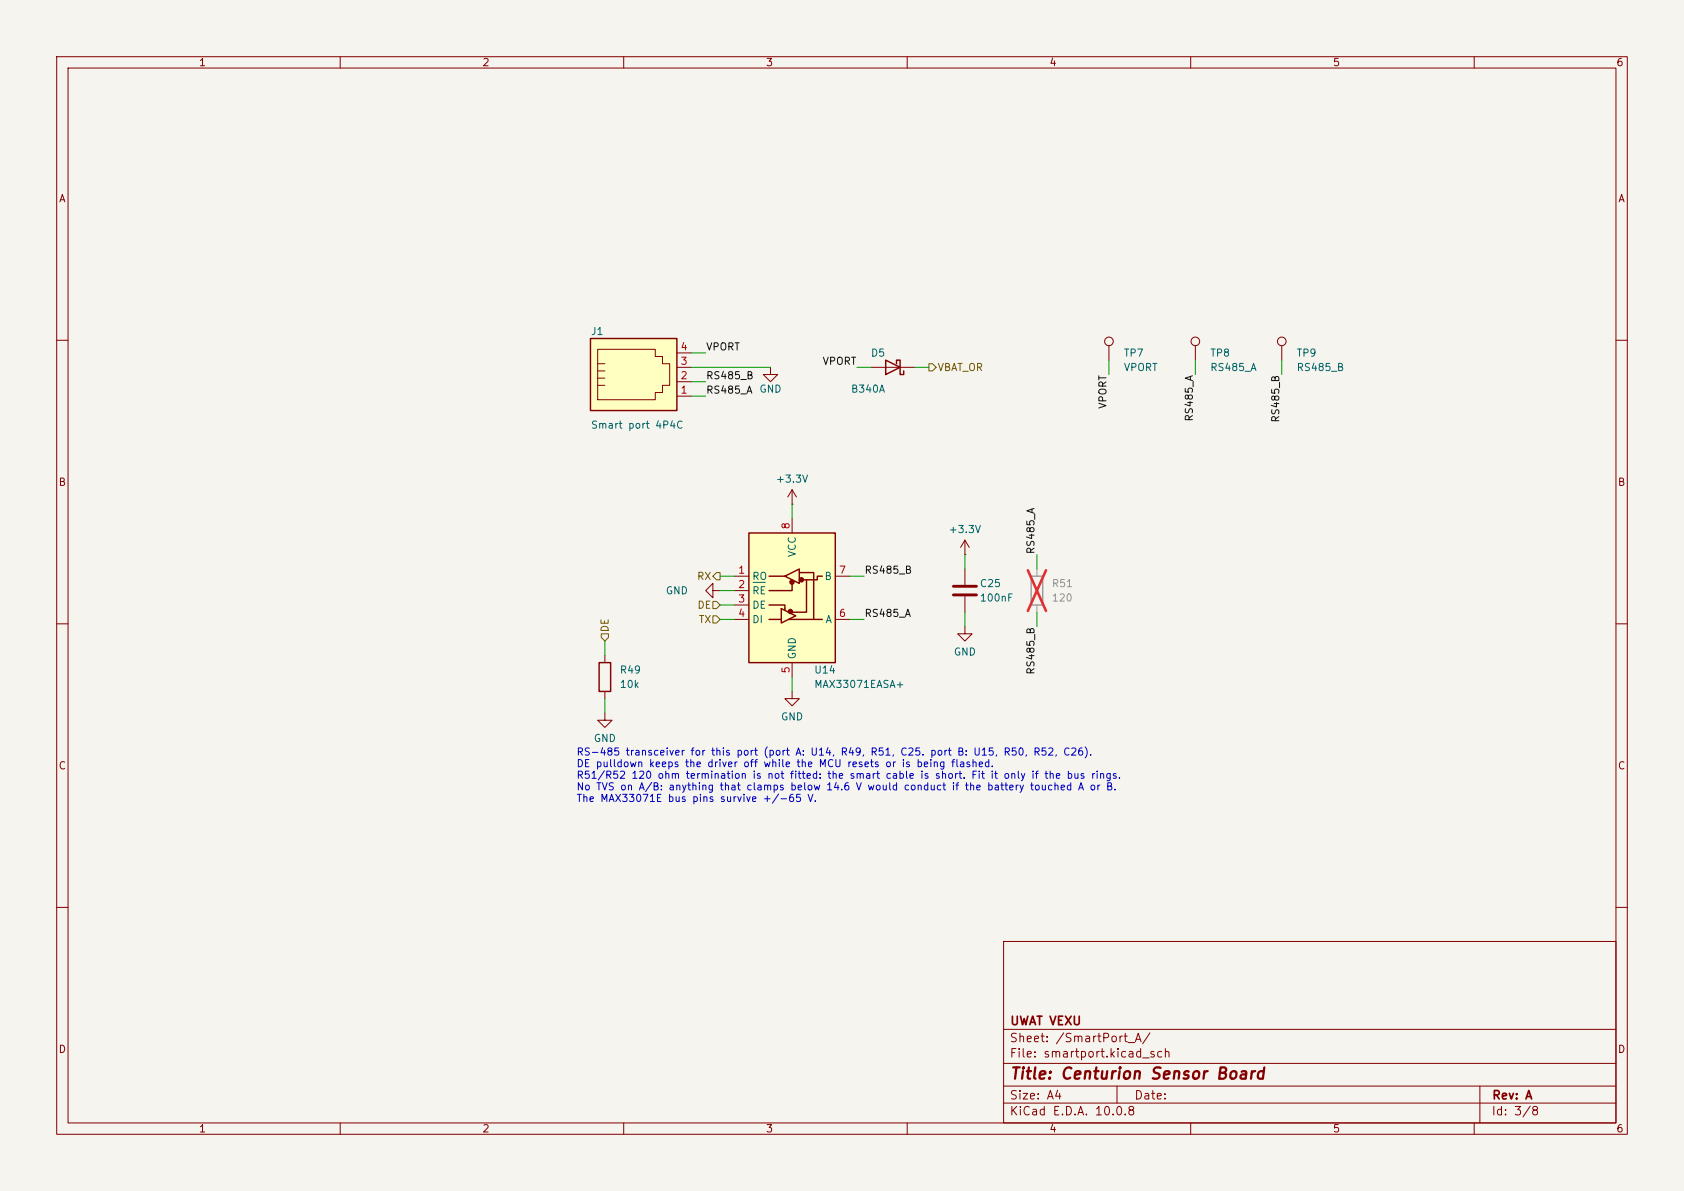
[picture p21: page 3]

RS-485 transceiver for this port (port A: U14, R49, R51, C25. port B: U15, R50, R52, C26). DE pulldown keeps the driver off while the MCU resets or is being flashed. R51/R52 120 ohm termination is not fitted: the smart cable is short. Fit it only if the bus rings. No TVS on A/B: anything that clamps below 14.6 V would conduct if the battery touched A or B. The MAX33071E bus pins survive +/-65 V.

UWAT VEXU
Sheet: /SmartPort_A/
File: smartport.kicad_sch
Title: Centurion Sensor Board

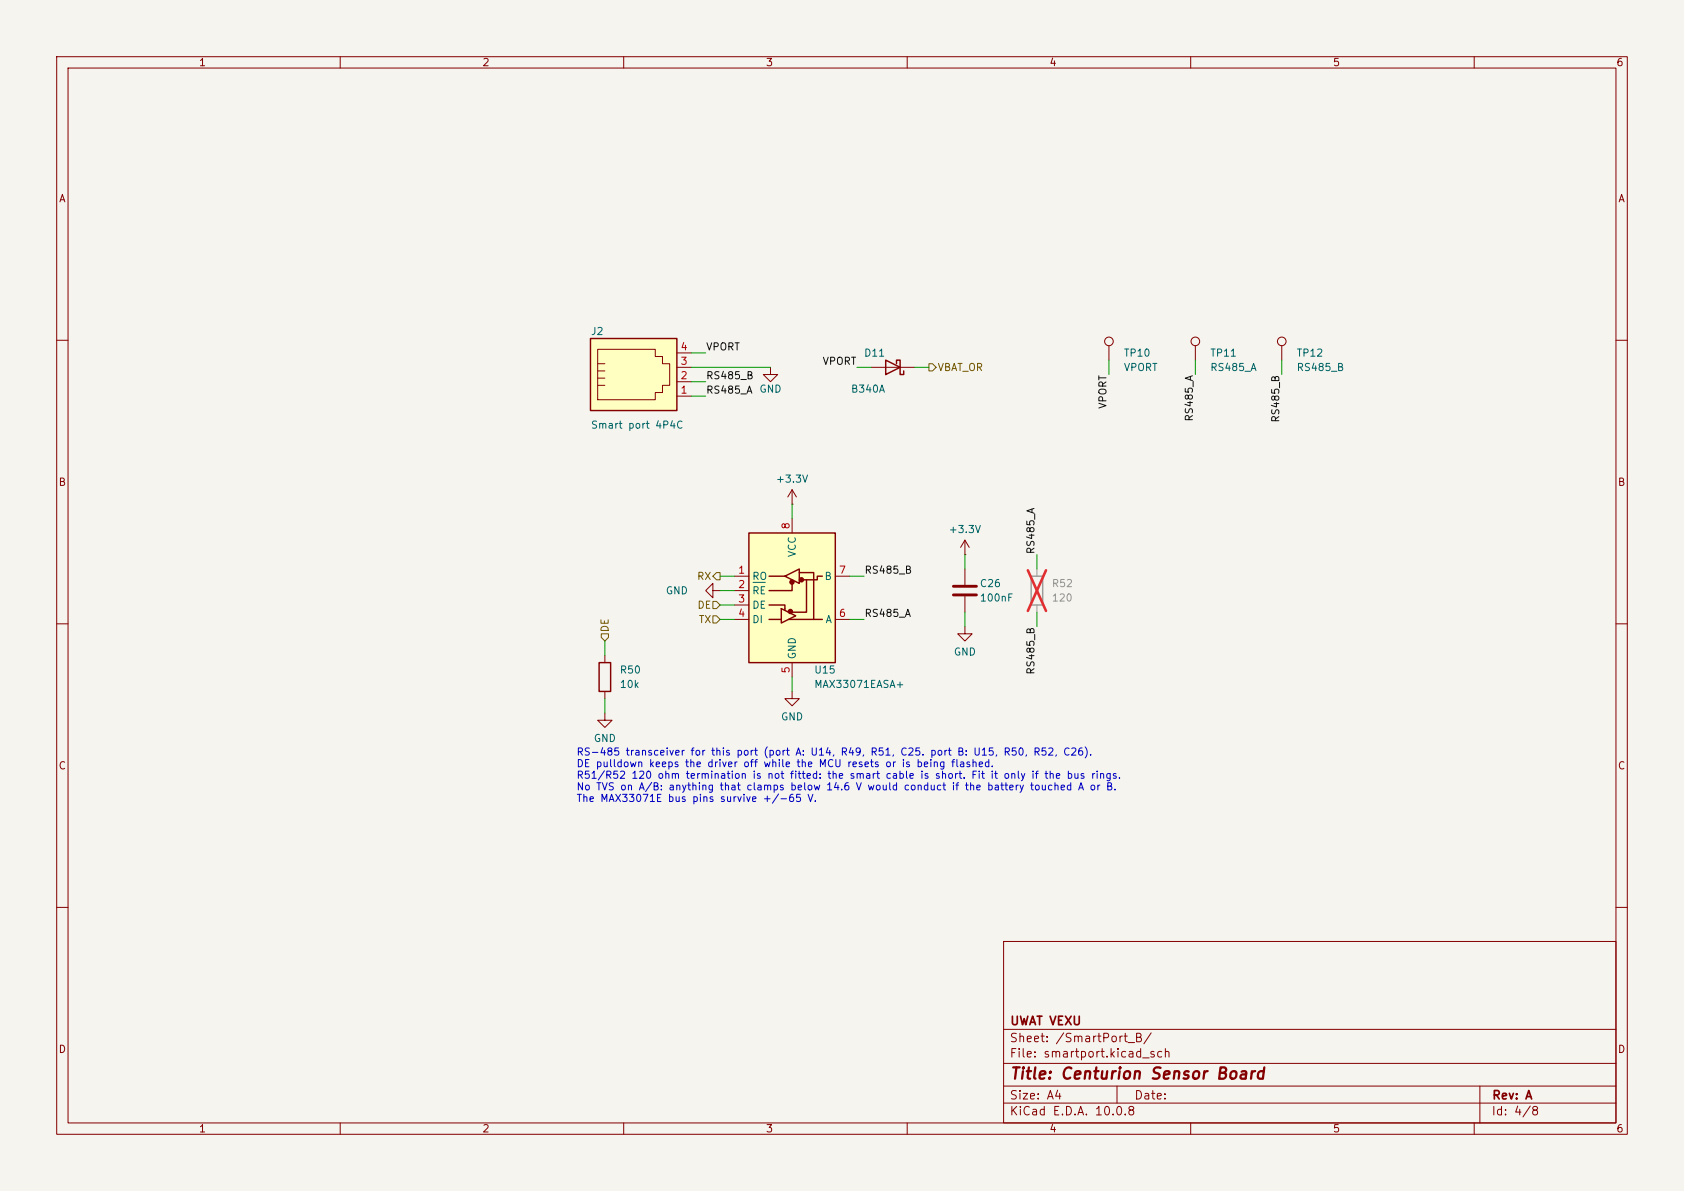
[picture p22: page 4]
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

UWAT VEXU
Sheet: /SmartPort_B/
File: smartport.kicad_sch
Title: Centurion Sensor Board

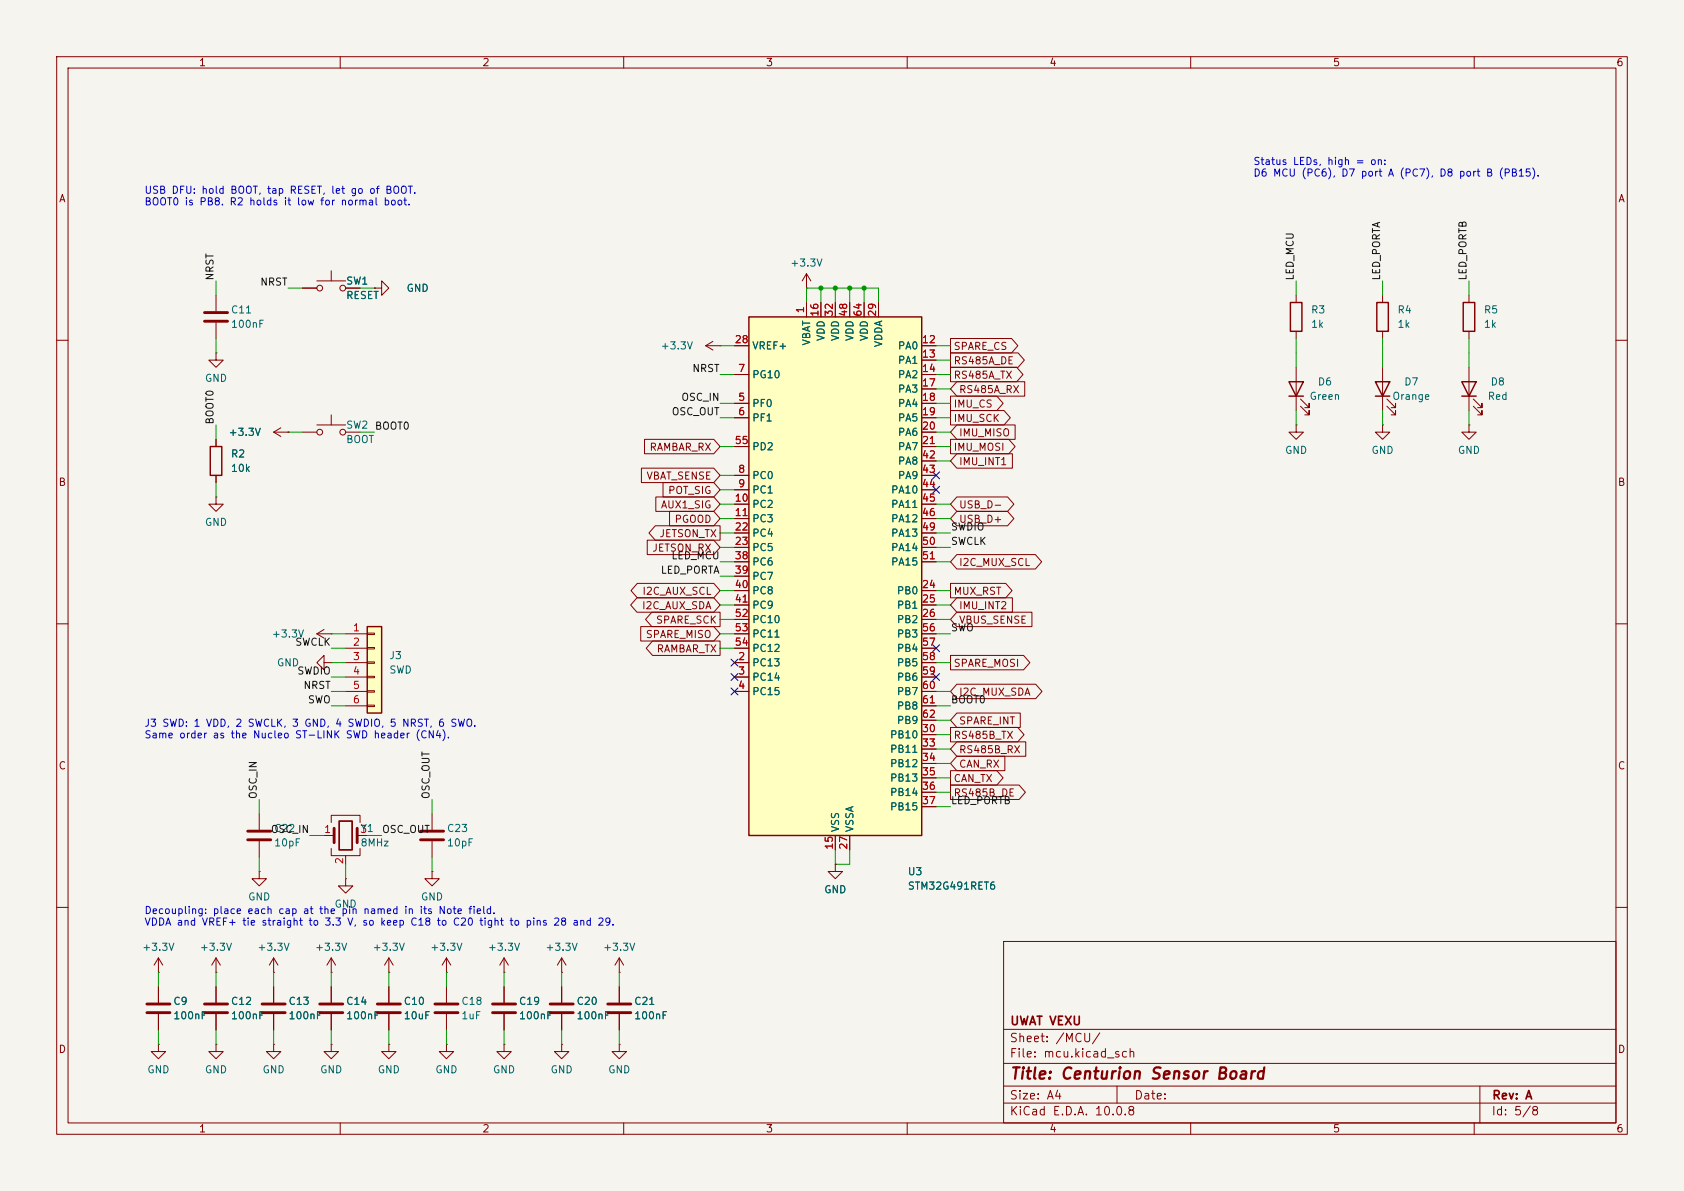
[picture p23: page 5]

J3 SWD: 1 VDD, 2 SWCLK, 3 GND, 4 SWDIO, 5 NRST, 6 SWO. Same order as the Nucleo ST-LINK SWD header (CN4).

Decoupling: place each cap at the pin named in its Note field. VDDA and VREF+ tie straight to 3.3 V, so keep C18 to C20 tight to pins 28 and 29.

UWAT VEXU
Sheet: /MCU/
File: mcu.kicad_sch
Title: Centurion Sensor Board

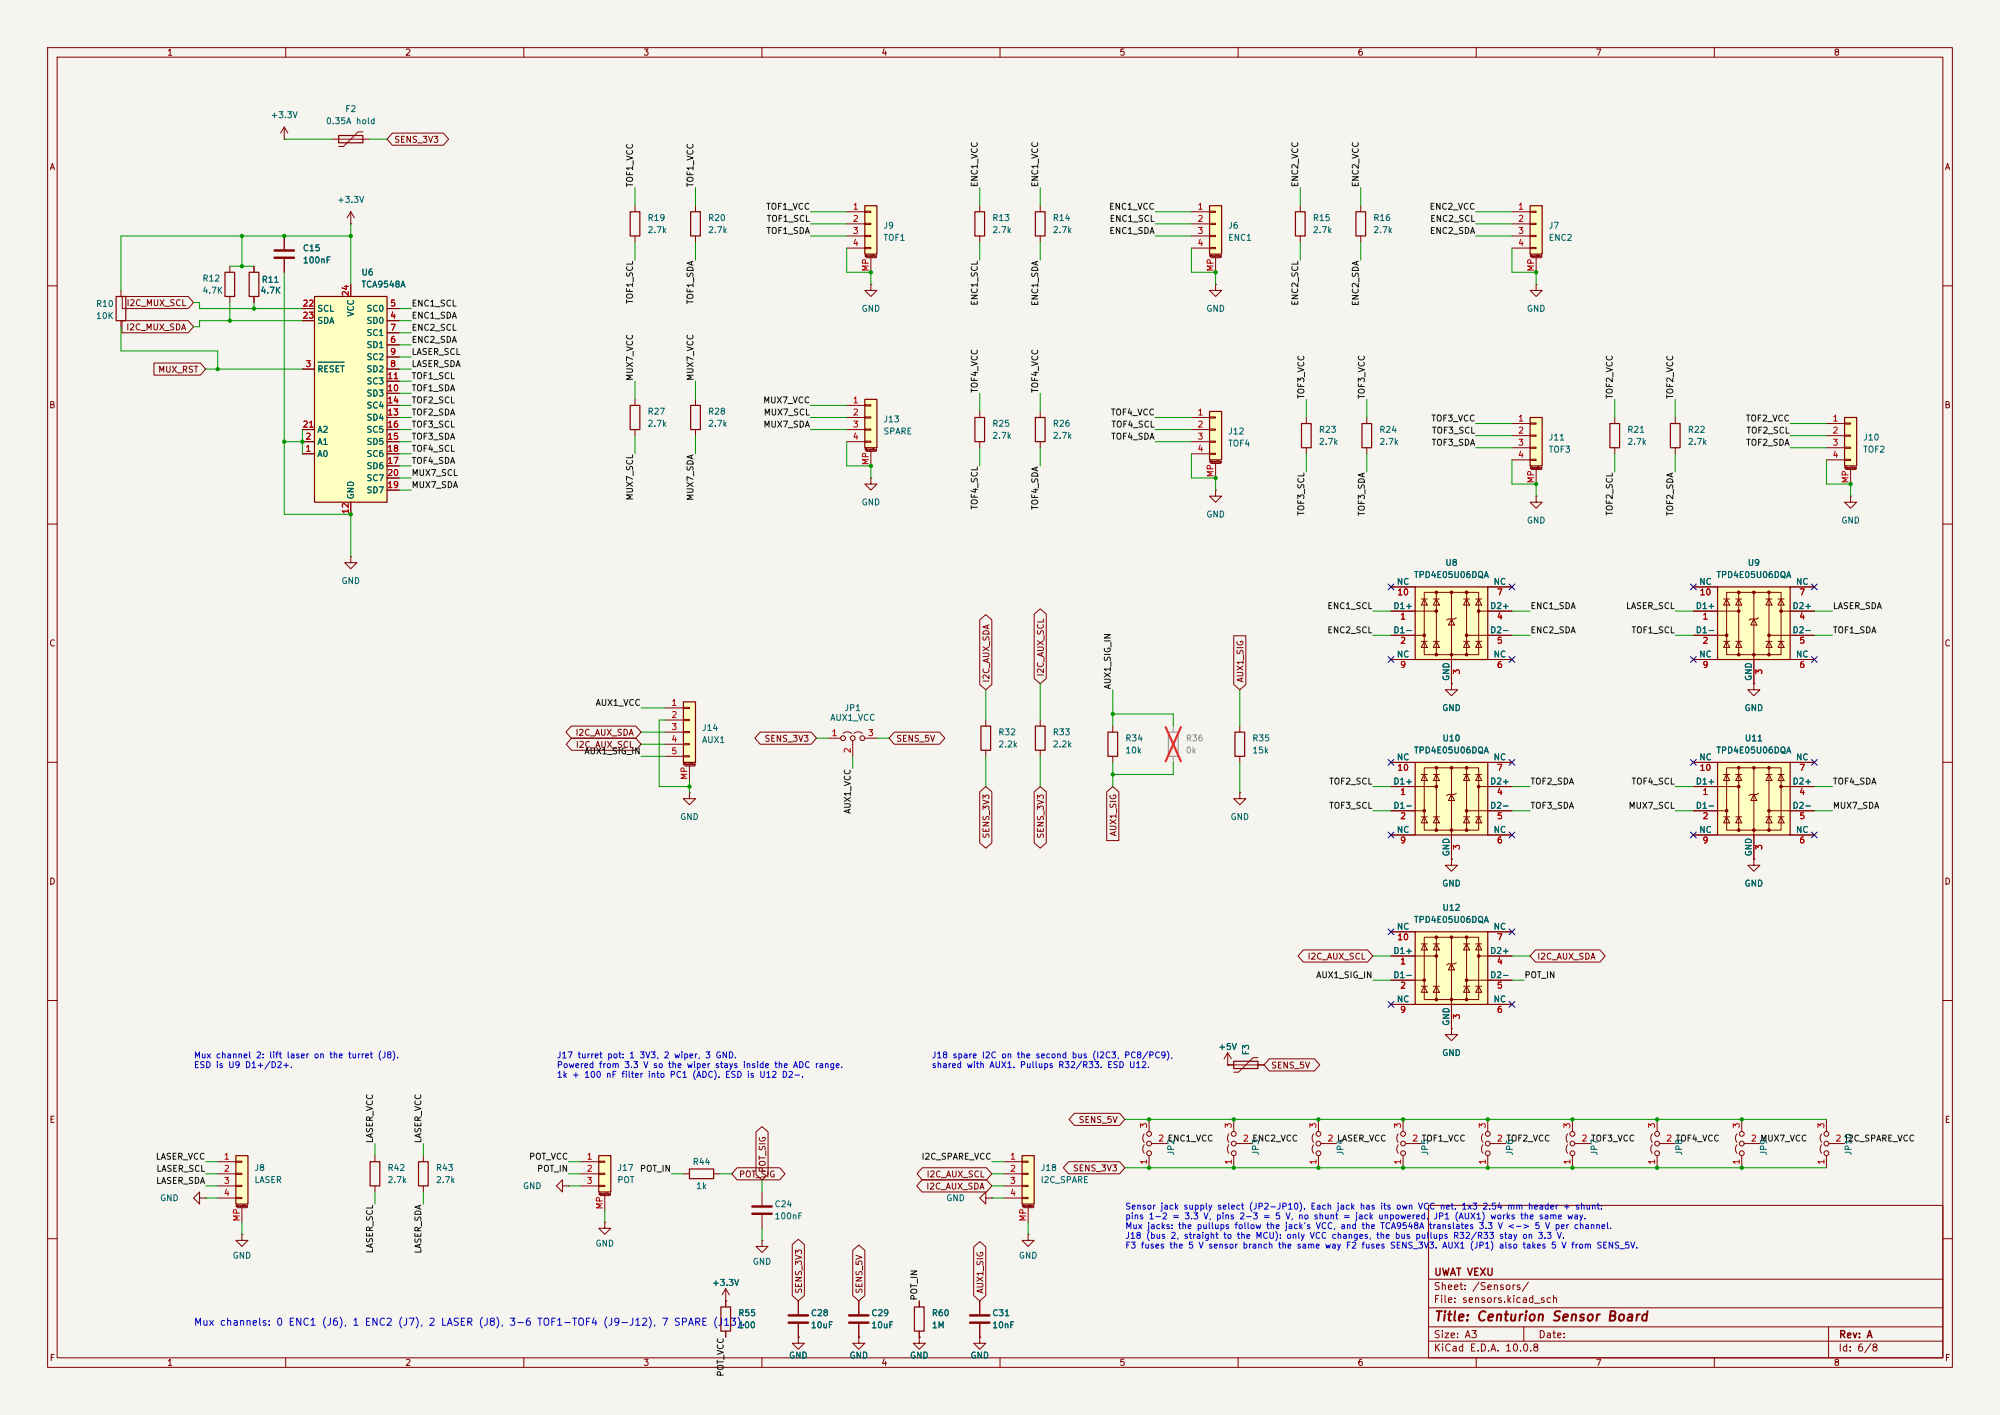
[picture p24: page 6]

UWAT VEXU
Sheet: /Sensors/
File: sensors.kicad_sch
Title: Centurion Sensor Board

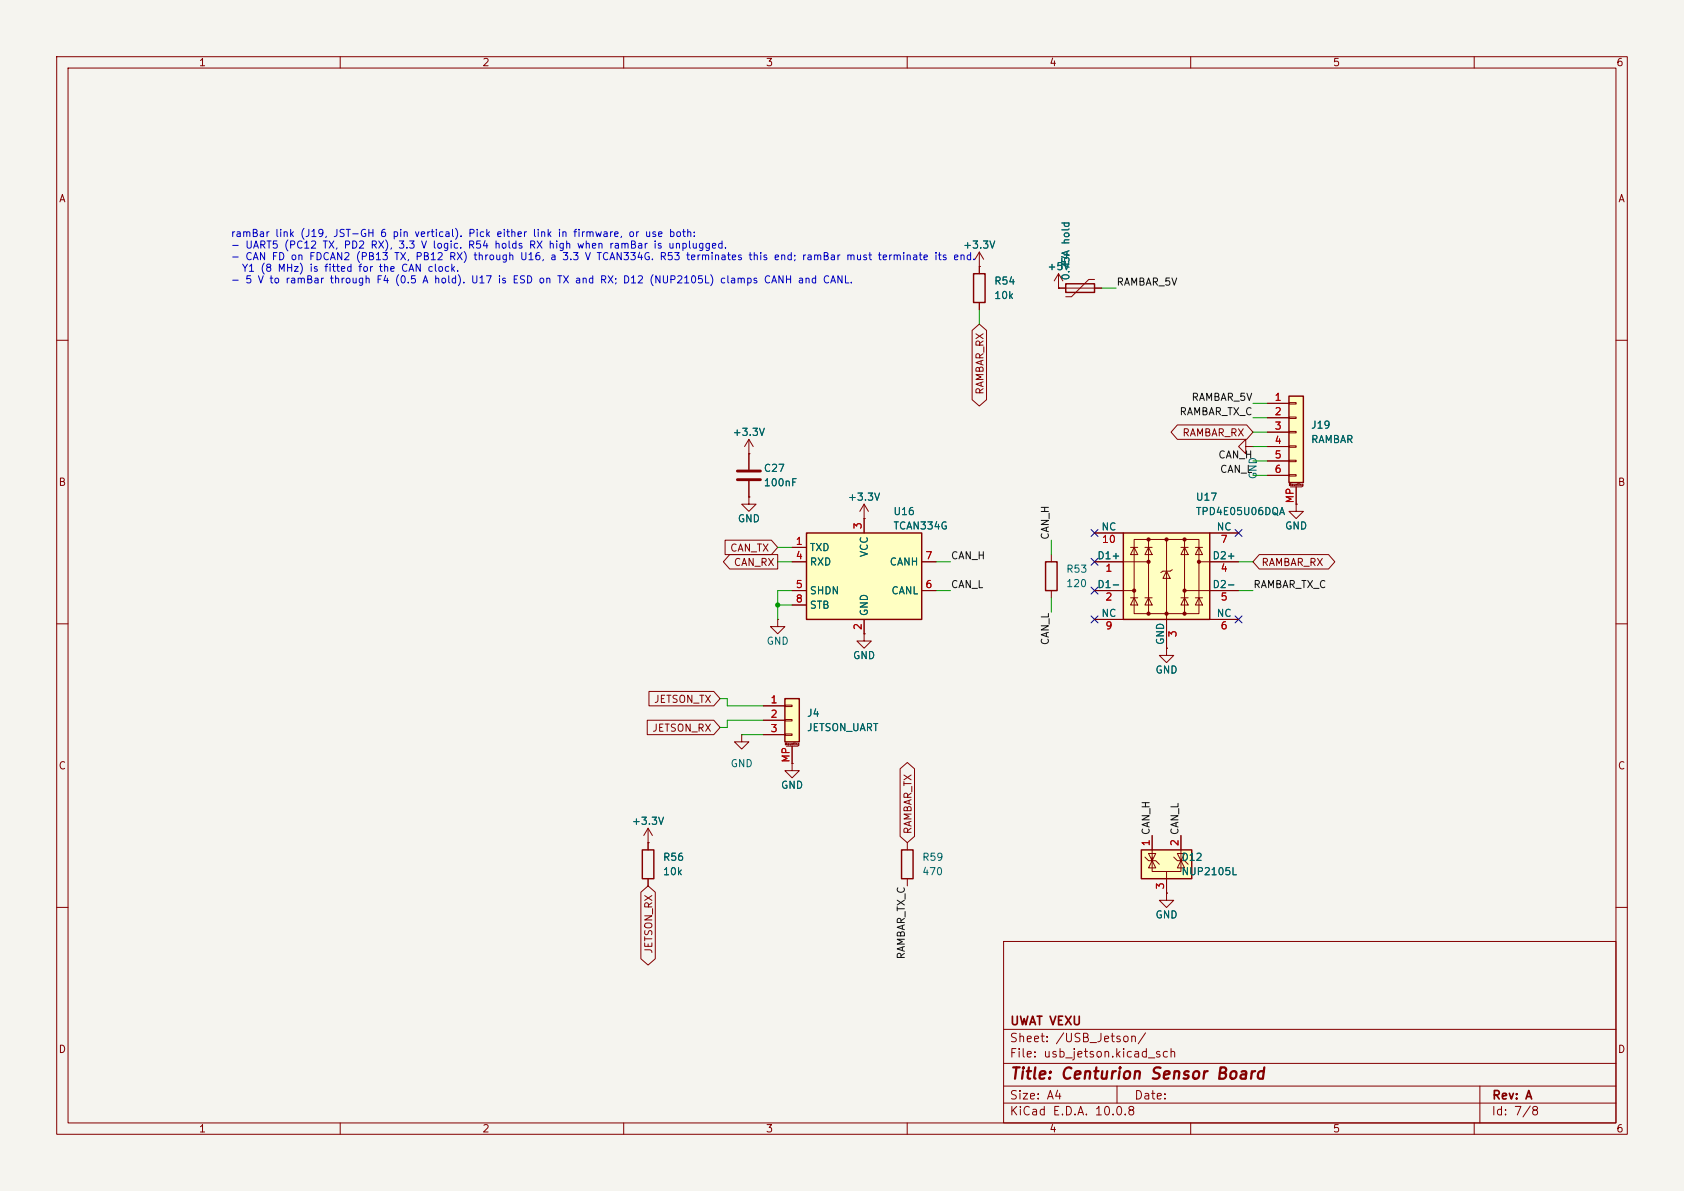
[picture p25: page 7]

ramBar link (J19, JST-GH 6 pin vertical). Pick either link in firmware, or use both: - UART5 (PC12 TX, PD2 RX), 3.3 V logic. R54 holds RX high when ramBar is unplugged. - CAN FD on FDCAN2 (PB13 TX, PB12 RX) through U16, a 3.3 V TCAN334G. R53 terminates this end; ramBar must terminate its end. Y1 (8 MHz) is fitted for the CAN clock. - 5 V to ramBar through F4 (0.5 A hold). U17 is ESD on TX and RX; D12 (NUP2105L) clamps CANH and CANL. J4

UWAT VEXU
Sheet: /USB_Jetson/
File: usb_jetson.kicad_sch
Title: Centurion Sensor Board

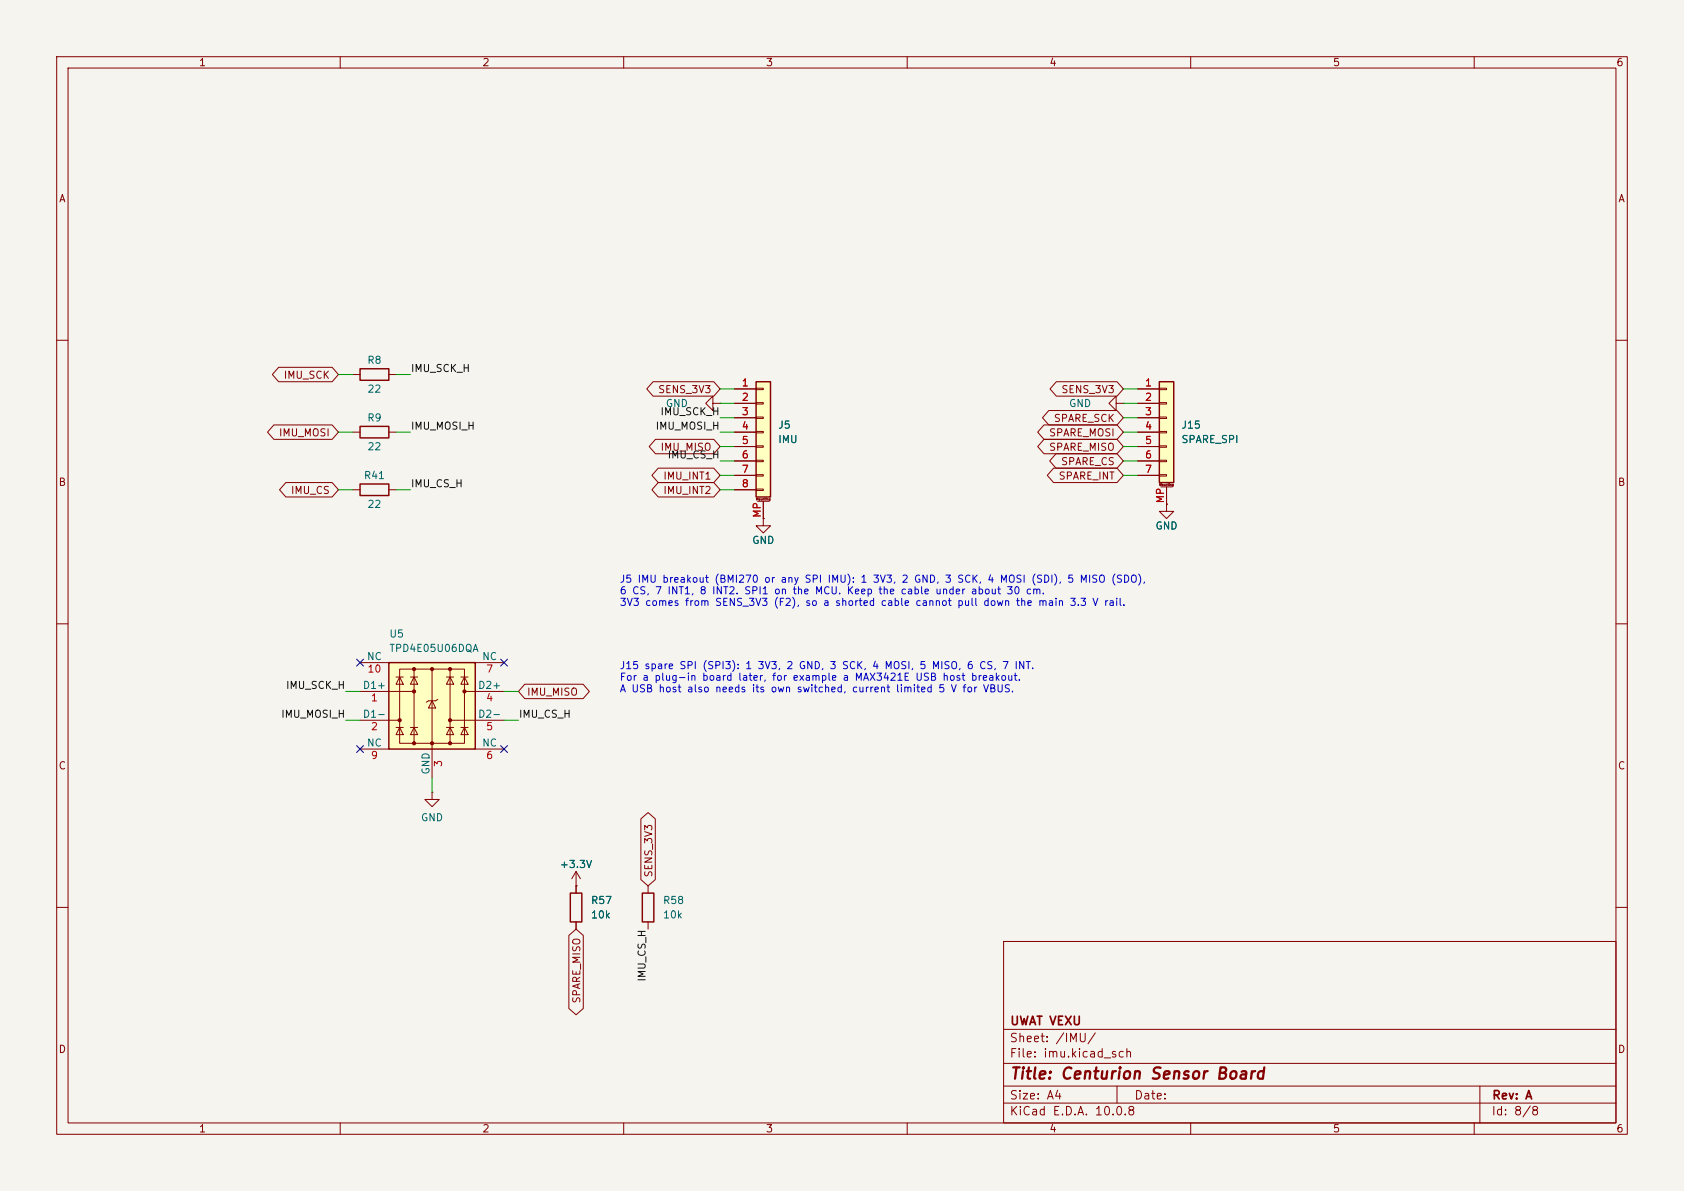
[picture p26: page 8]

J15 spare SPI (SPI3): 1 3V3, 2 GND, 3 SCK, 4 MOSI, 5 MISO, 6 CS, 7 INT. For a plug-in board later, for example a MAX3421E USB host breakout. A USB host also needs its own switched, current limited 5 V for VBUS. J5 IMU breakout (BMI270 or any SPI IMU): 1 3V3, 2 GND, 3 SCK, 4 MOSI (SDI), 5 MISO (SDO), 6 CS, 7 INT1, 8 INT2. SPI1 on the MCU. Keep the cable under about 30 cm. 3V3 comes from SENS_3V3 (F2), so a shorted cable cannot pull down the main 3.3 V rail. +3.3VR57

UWAT VEXU
Sheet: /IMU/
File: imu.kicad_sch
Title: Centurion Sensor Board
