UW-VexU/UWAT-Centurion-Board/powerJackal/docs/powerJackal_revA_schematic.pdf

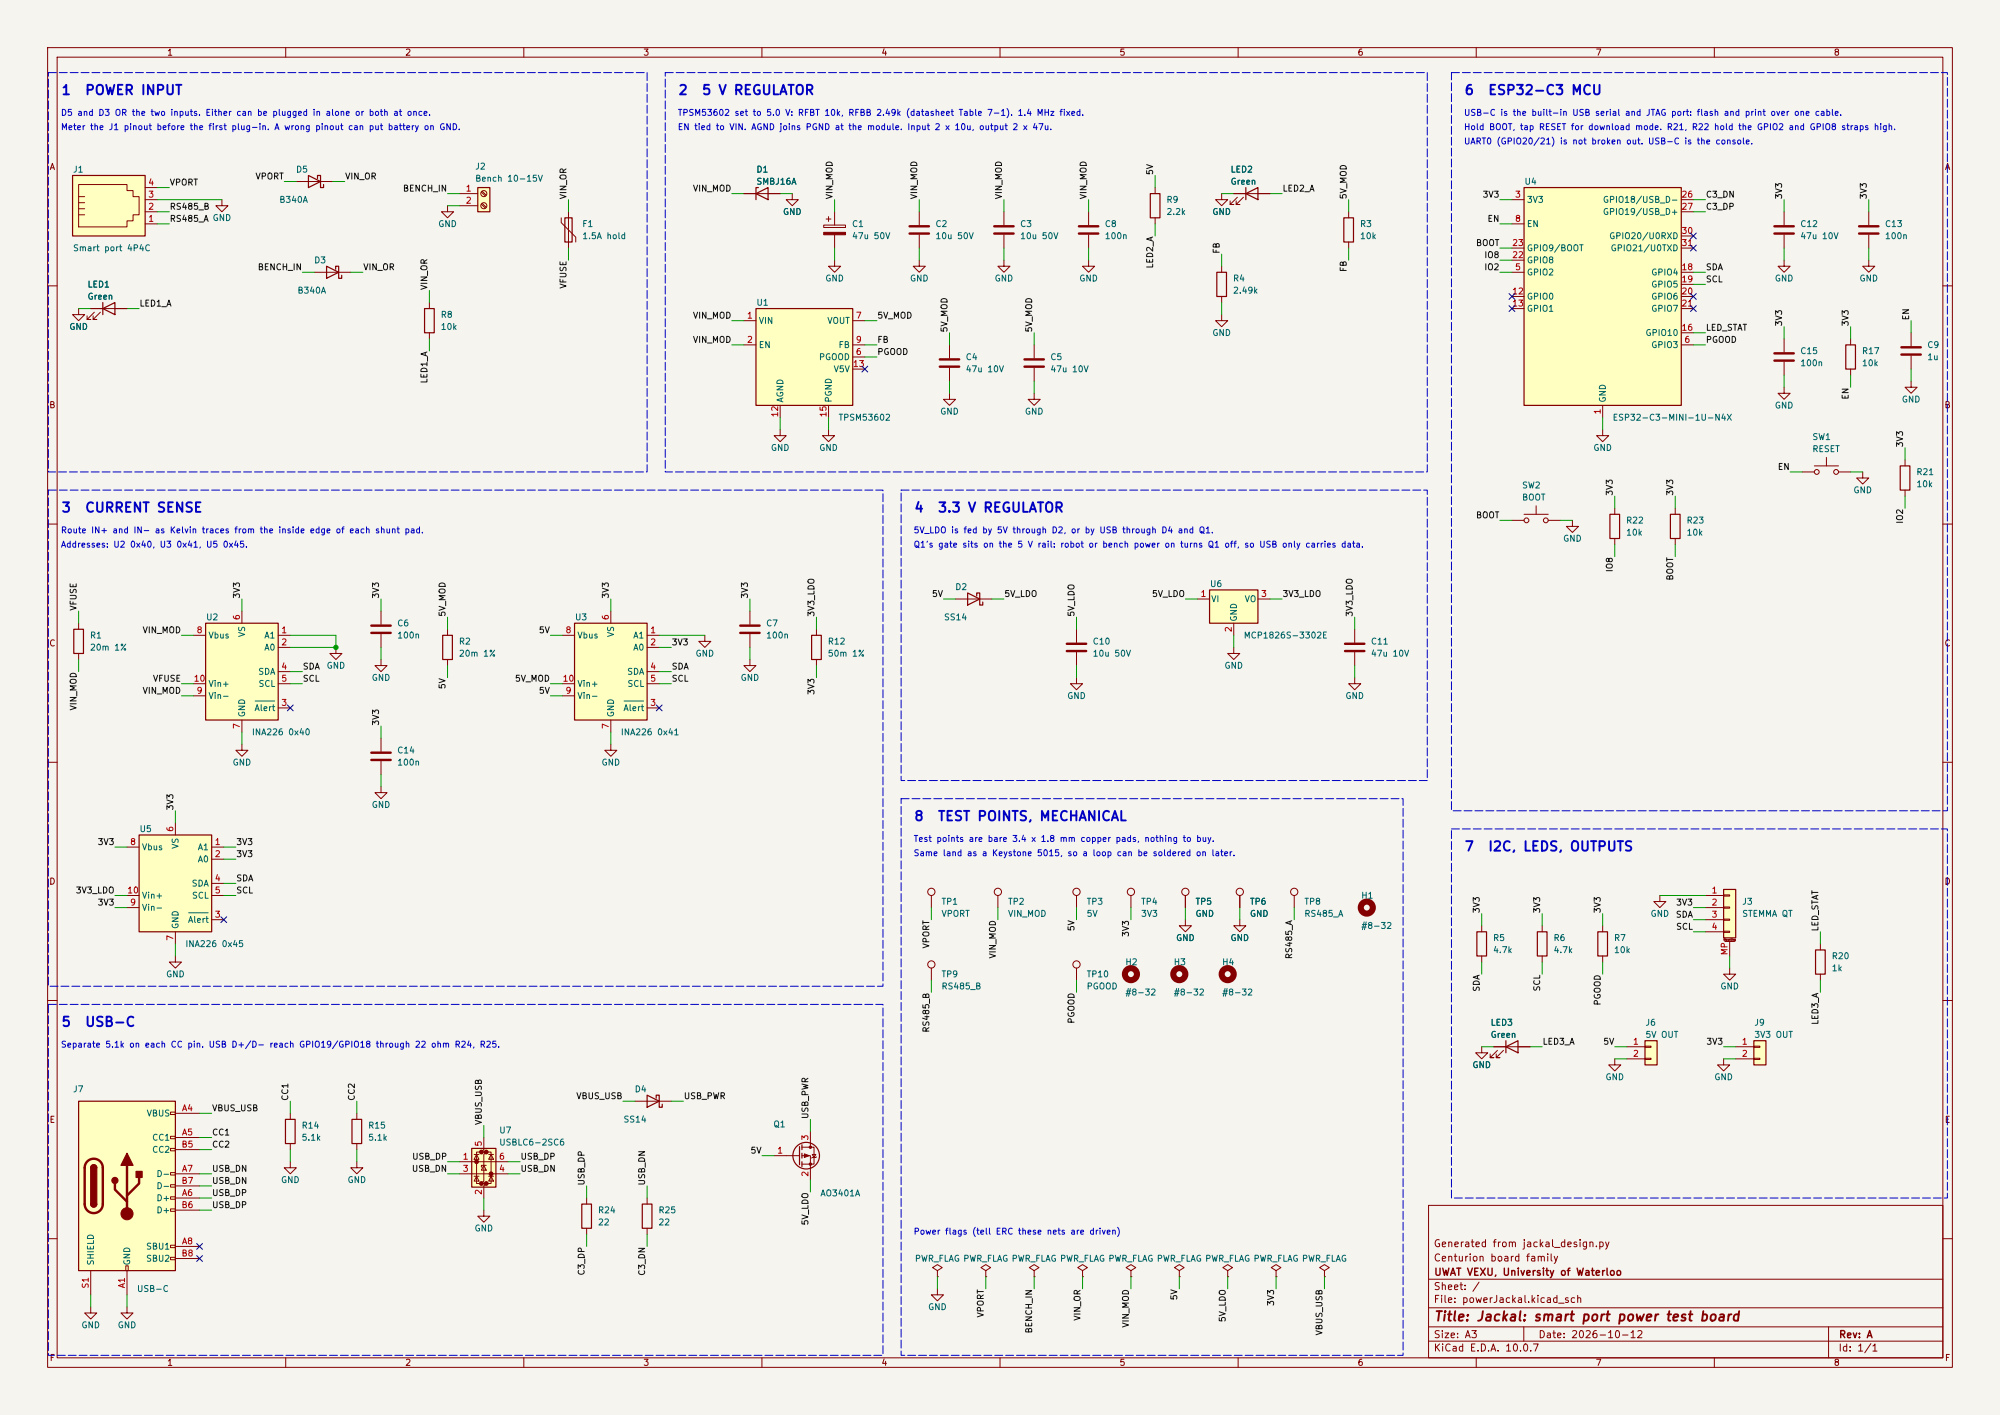
[picture p27: page 1]

USB-C is the built-in USB serial and JTAG port: flash and print over one cable. 6 ESP32-C3 MCU

TPSM53602 set to 5.0 V: RFBT 10k, RFBB 2.49k (datasheet Table 7-1). 1.4 MHz fixed. 5V_LDO is fed by 5V through D2, or by USB through D4 and Q1. Separate 5.1k on each CC pin. USB D+/D- reach GPIO19/GPIO18 through 22 ohm R24, R25.

UART0 (GPIO20/21) is not broken out. USB-C is the console. Hold BOOT, tap RESET for download mode. R21, R22 hold the GPIO2 and GPIO8 straps high.

Route IN+ and IN- as Kelvin traces from the inside edge of each shunt pad.

Test points are bare 3.4 x 1.8 mm copper pads, nothing to buy. Q1's gate sits on the 5 V rail: robot or bench power on turns Q1 off, so USB only carries data.

Power flags (tell ERC these nets are driven)

Generated from jackal_design.py
Centurion board family
UWAT VEXU, University of Waterloo
Sheet: /
File: powerJackal.kicad_sch
Title: Jackal: smart port power test board

Size: A3 | Rev: A | F Date: 2026-10-12
KiCad E.D.A. 10.0.7 | Id: 1/1
