UW-VexU/UWAT-Centurion-Board/stellaNova/docs/uwat-stellaNova-schematic.pdf

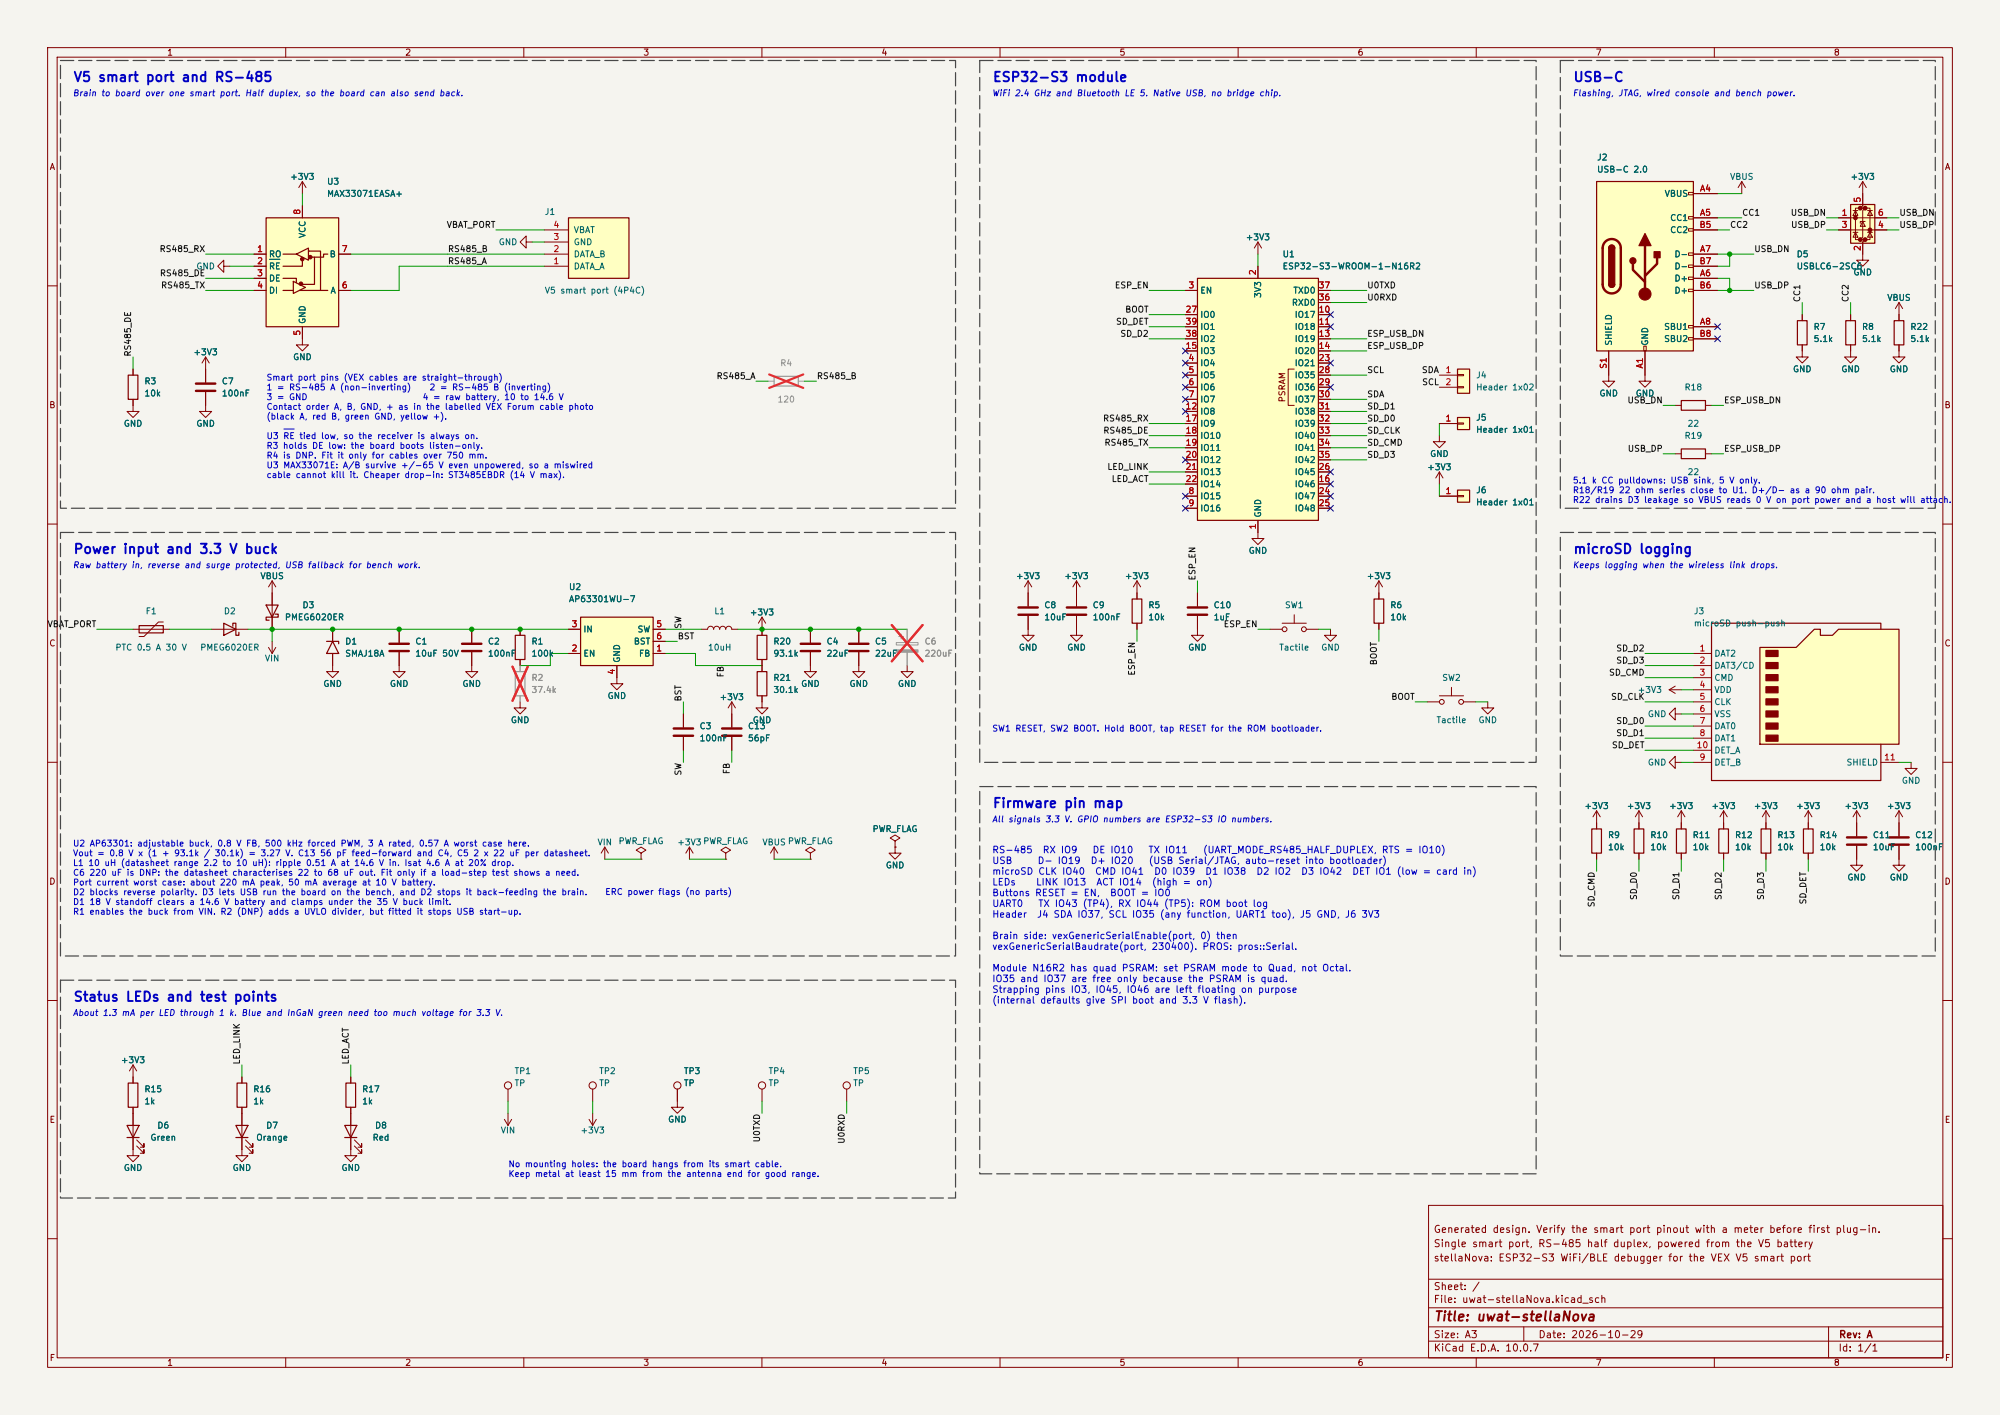
[picture p28: page 1]

Brain to board over one smart port. Half duplex, so the board can also send back. Status LEDs and test points

Flashing, JTAG, wired console and bench power. V5 smart port and RS-485

WiFi 2.4 GHz and Bluetooth LE 5. Native USB, no bridge chip.

(black A, red B, green GND, yellow +). U3 RE tied low, so the receiver is always on. R3 holds DE low: the board boots listen-only. R4 is DNP. Fit it only for cables over 750 mm. U3 MAX33071E: A/B survive +/-65 V even unpowered, so a miswired

cable cannot kill it. Cheaper drop-in: ST3485EBDR (14 V max).

Power input and 3.3 V buck

Keeps logging when the wireless link drops.

vexGenericSerialBaudrate(port, 230400). PROS: pros::Serial. Module N16R2 has quad PSRAM: set PSRAM mode to Quad, not Octal.

IO35 and IO37 are free only because the PSRAM is quad.
Strapping pins IO3, IO45, IO46 are left floating on purpose
(internal defaults give SPI boot and 3.3 V flash).

Generated design. Verify the smart port pinout with a meter before first plug-in. R16

Single smart port, RS-485 half duplex, powered from the V5 battery
stellaNova: ESP32-S3 WiFi/BLE debugger for the VEX V5 smart port

Size: A3 | Rev: A | F Date: 2026-10-29
KiCad E.D.A. 10.0.7 | Id: 1/1
