UW-VexU/UWAT-Centurion-Board/centurion/centurion.kicad_pcb

## KiCad design centurion/centurion.kicad_pcb (2026-11-05)

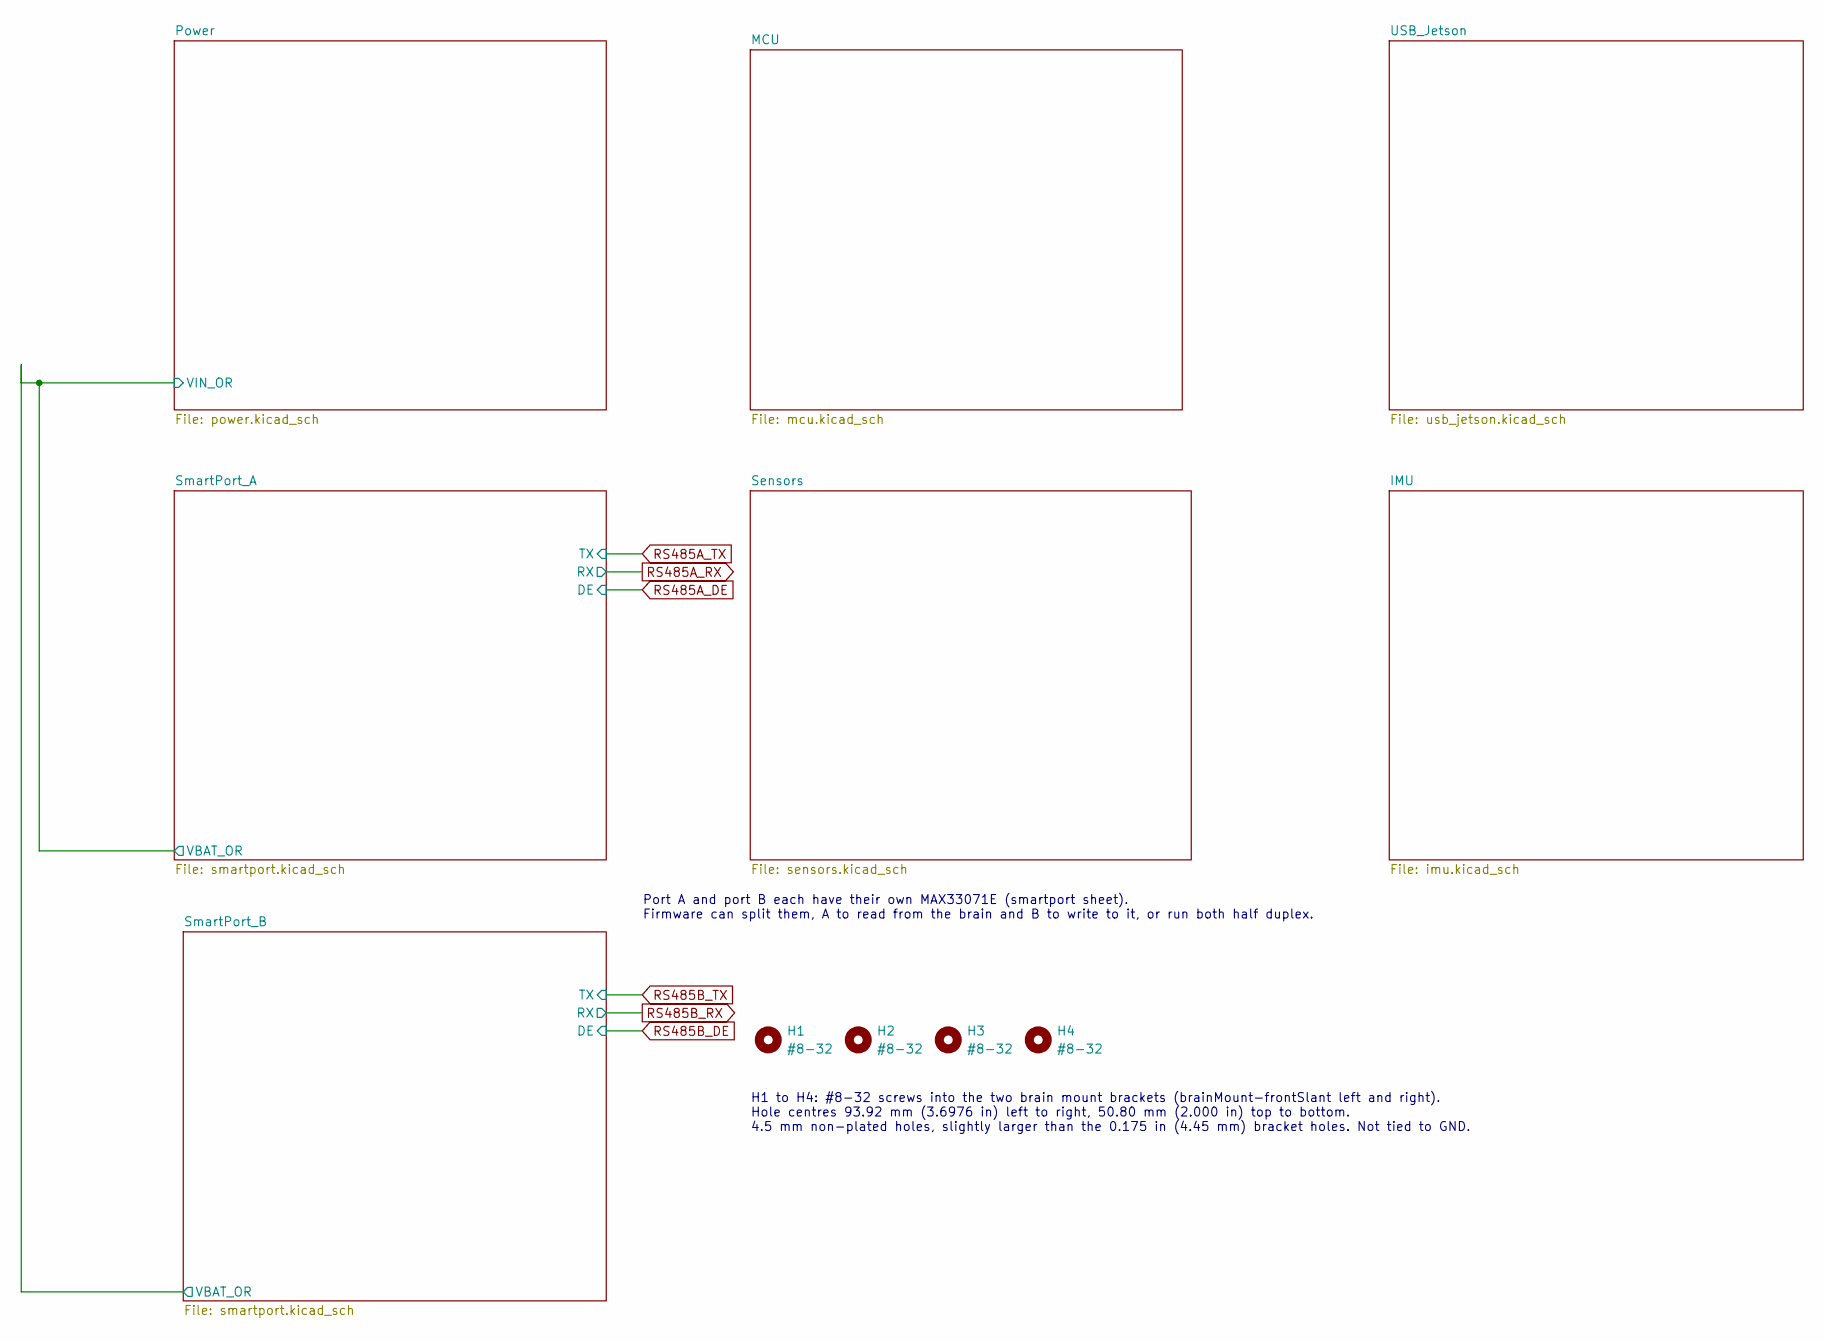
[picture p29: schematic centurion.kicad_sch, Centurion Sensor Board]

Parts:
H1, H2, H3, H4: #8-32; MountingHole_4.5mm_8-32

Notes on the sheet:
Port A and port B each have their own MAX33071E (smartport sheet). Firmware can split them, A to read from the brain and B to write to it, or run both half duplex.
H1 to H4: #8-32 screws into the two brain mount brackets (brainMount-frontSlant left and right). Hole centres 93.92 mm (3.6976 in) left to right, 50.80 mm (2.000 in) top to bottom. 4.5 mm non-plated holes, slightly larger than the 0.175 in (4.45 mm) bracket holes. Not tied to GND.

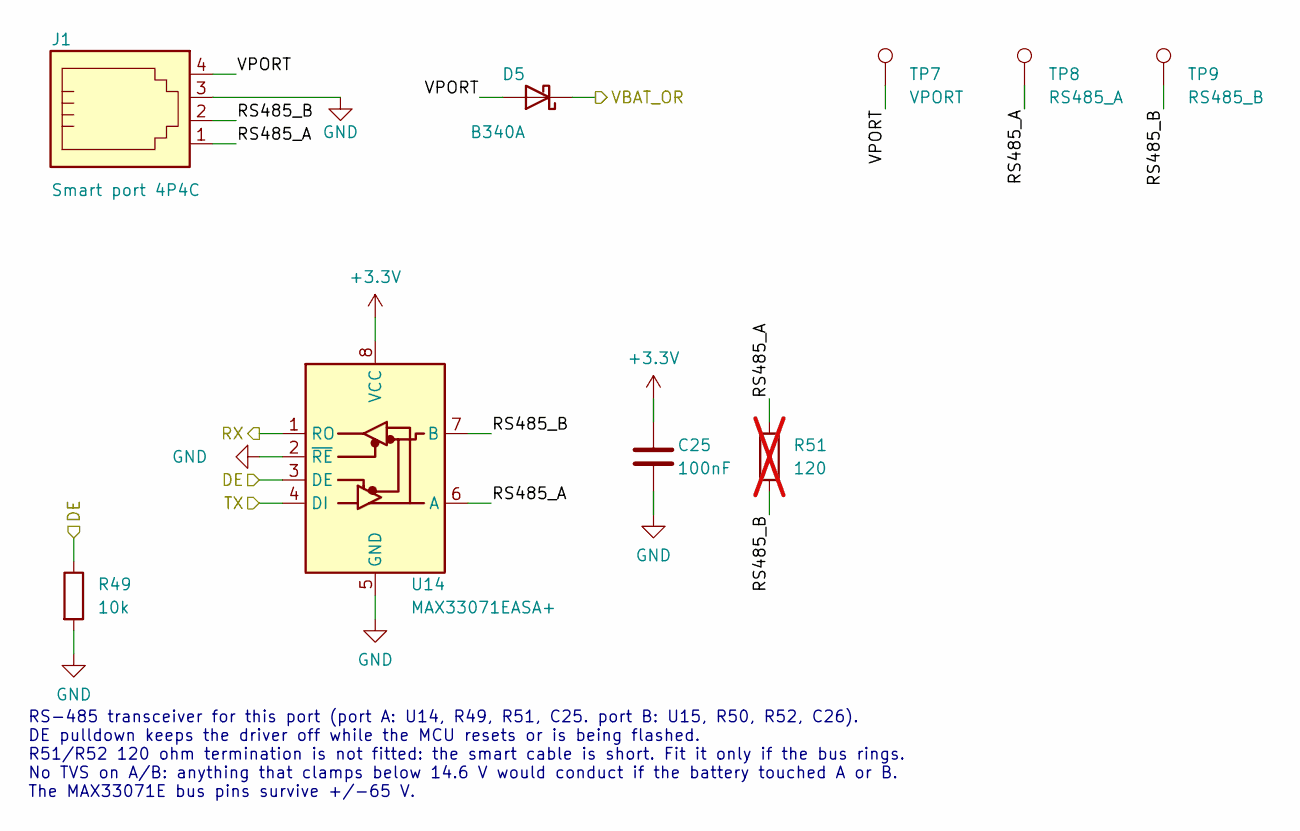
[picture p30: schematic smartport.kicad_sch, Centurion Sensor Board]

Parts:
C25: 100nF; C_0805_2012Metric; MPN CC0805KRX7R9BB104
D5: B340A; D_SMA; MPN B340A-13-F
J1: Smart port 4P4C; Molex_95501-2441_4P4C_Horizontal; MPN 0955012441
R49: 10k; R_0805_2012Metric; MPN RC0805FR-0710KL
R51: 120; R_0805_2012Metric; MPN RC0805FR-07120RL; not fitted
TP7: VPORT; TestPoint_Pad_D1.5mm
TP8: RS485_A; TestPoint_Pad_D1.5mm
TP9: RS485_B; TestPoint_Pad_D1.5mm
U14: MAX33071EASA+; SOIC-8_3.9x4.9mm_P1.27mm; MPN MAX33071EASA+

Connections:
+3.3V: C25.1, U14.8 (VCC); also elsewhere on the board
/Power/VIN_OR: D5.1 (K); also elsewhere on the board
/SmartPort_A/RS485_A: J1.1, R51.1, TP8.1, U14.6 (A)
/SmartPort_A/RS485_B: J1.2, R51.2, TP9.1, U14.7 (B)
/SmartPort_A/VPORT: D5.2 (A), J1.4, TP7.1
GND: C25.2, J1.3, R49.2, U14.2 (~RE), U14.5 (GND); also elsewhere on the board
RS485A_DE: R49.1, U14.3 (DE); also elsewhere on the board
RS485A_RX: U14.1 (RO); also elsewhere on the board
RS485A_TX: U14.4 (DI); also elsewhere on the board

Parts of its further copies:
C26: 100nF; C_0805_2012Metric; MPN CC0805KRX7R9BB104
D11: B340A; D_SMA; MPN B340A-13-F
J2: Smart port 4P4C; Molex_95501-2441_4P4C_Horizontal; MPN 0955012441
R50: 10k; R_0805_2012Metric; MPN RC0805FR-0710KL
R52: 120; R_0805_2012Metric; MPN RC0805FR-07120RL; not fitted
TP10: VPORT; TestPoint_Pad_D1.5mm
TP11: RS485_A; TestPoint_Pad_D1.5mm
TP12: RS485_B; TestPoint_Pad_D1.5mm
U15: MAX33071EASA+; SOIC-8_3.9x4.9mm_P1.27mm; MPN MAX33071EASA+

Connections of its further copies:
+3.3V: C26.1, U15.8 (VCC); also elsewhere on the board
/Power/VIN_OR: D11.1 (K); also elsewhere on the board
/SmartPort_B/RS485_A: J2.1, R52.1, TP11.1, U15.6 (A)
/SmartPort_B/RS485_B: J2.2, R52.2, TP12.1, U15.7 (B)
/SmartPort_B/VPORT: D11.2 (A), J2.4, TP10.1
GND: C26.2, J2.3, R50.2, U15.2 (~RE), U15.5 (GND); also elsewhere on the board
RS485B_DE: R50.1, U15.3 (DE); also elsewhere on the board
RS485B_RX: U15.1 (RO); also elsewhere on the board
RS485B_TX: U15.4 (DI); also elsewhere on the board

Notes on the sheet:
RS-485 transceiver for this port (port A: U14, R49, R51, C25. port B: U15, R50, R52, C26). DE pulldown keeps the driver off while the MCU resets or is being flashed. R51/R52 120 ohm termination is not fitted: the smart cable is short. Fit it only if the bus rings. No TVS on A/B: anything that clamp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

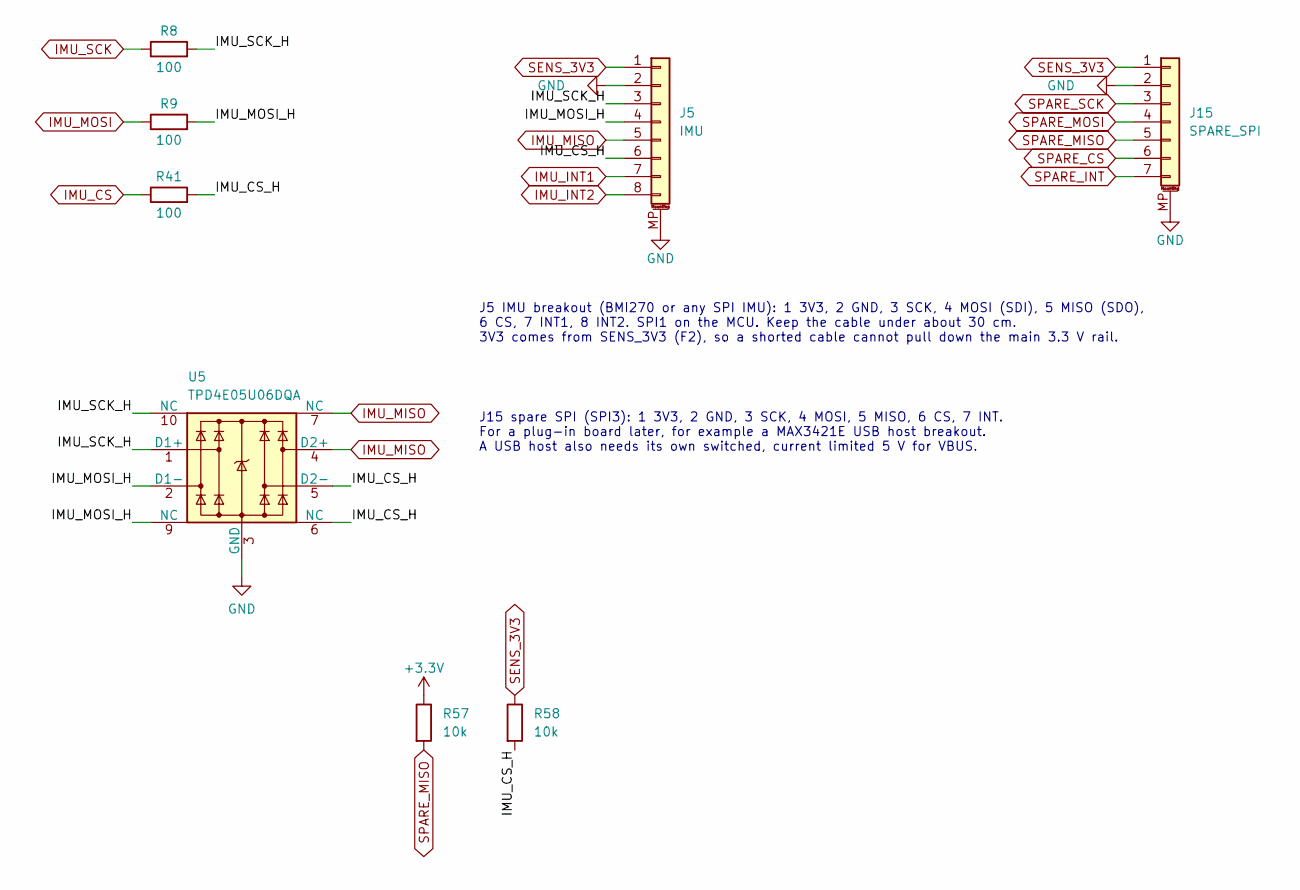
[picture p31: schematic imu.kicad_sch, Centurion Sensor Board]

Parts:
J5: IMU; JST_GH_BM08B-GHS-TBT_1x08-1MP_P1.25mm_Vertical; MPN BM08B-GHS-TBT
J15: SPARE_SPI; JST_GH_BM07B-GHS-TBT_1x07-1MP_P1.25mm_Vertical; MPN BM07B-GHS-TBT
R8, R9, R41: 100; R_0805_2012Metric; MPN RC0805FR-07100RL
R57, R58: 10k; R_0805_2012Metric; MPN RC0805FR-0710KL
U5: TPD4E05U06DQA; TI_DQA_USON-10_2.5x1.0mm_P0.5mm; MPN TPD4E05U06QDQARQ1

Connections:
+3.3V: R57.1; also elsewhere on the board
/IMU/IMU_CS_H: J5.6, R41.2, R58.2, U5.5 (D2-), U5.6 (NC)
/IMU/IMU_MOSI_H: J5.4, R9.2, U5.2 (D1-), U5.9 (NC)
/IMU/IMU_SCK_H: J5.3, R8.2, U5.1 (D1+), U5.10 (NC)
GND: J5.2, J5.MP (MountPin), J15.2, J15.MP (MountPin), U5.3 (GND), U5.8 (GND); also elsewhere on the board
IMU_CS: R41.1; also elsewhere on the board
IMU_INT1: J5.7; also elsewhere on the board
IMU_INT2: J5.8; also elsewhere on the board
IMU_MISO: J5.5, U5.4 (D2+), U5.7 (NC); also elsewhere on the board
IMU_MOSI: R9.1; also elsewhere on the board
IMU_SCK: R8.1; also elsewhere on the board
SENS_3V3: J5.1, J15.1, R58.1; also elsewhere on the board
SPARE_CS: J15.6; also elsewhere on the board
SPARE_INT: J15.7; also elsewhere on the board
SPARE_MISO: J15.5, R57.2; also elsewhere on the board
SPARE_MOSI: J15.4; also elsewhere on the board
SPARE_SCK: J15.3; also elsewhere on the board

Notes on the sheet:
J5 IMU breakout (BMI270 or any SPI IMU): 1 3V3, 2 GND, 3 SCK, 4 MOSI (SDI), 5 MISO (SDO), 6 CS, 7 INT1, 8 INT2. SPI1 on the MCU. Keep the cable under about 30 cm. 3V3 comes from SENS_3V3 (F2), so a shorted cable cannot pull down the main 3.3 V rail.
J15 spare SPI (SPI3): 1 3V3, 2 GND, 3 SCK, 4 MOSI, 5 MISO, 6 CS, 7 INT. For a plug-in board later, for example a MAX3421E USB host breakout. A USB host also needs its own switched, current limited 5 V for VBUS.

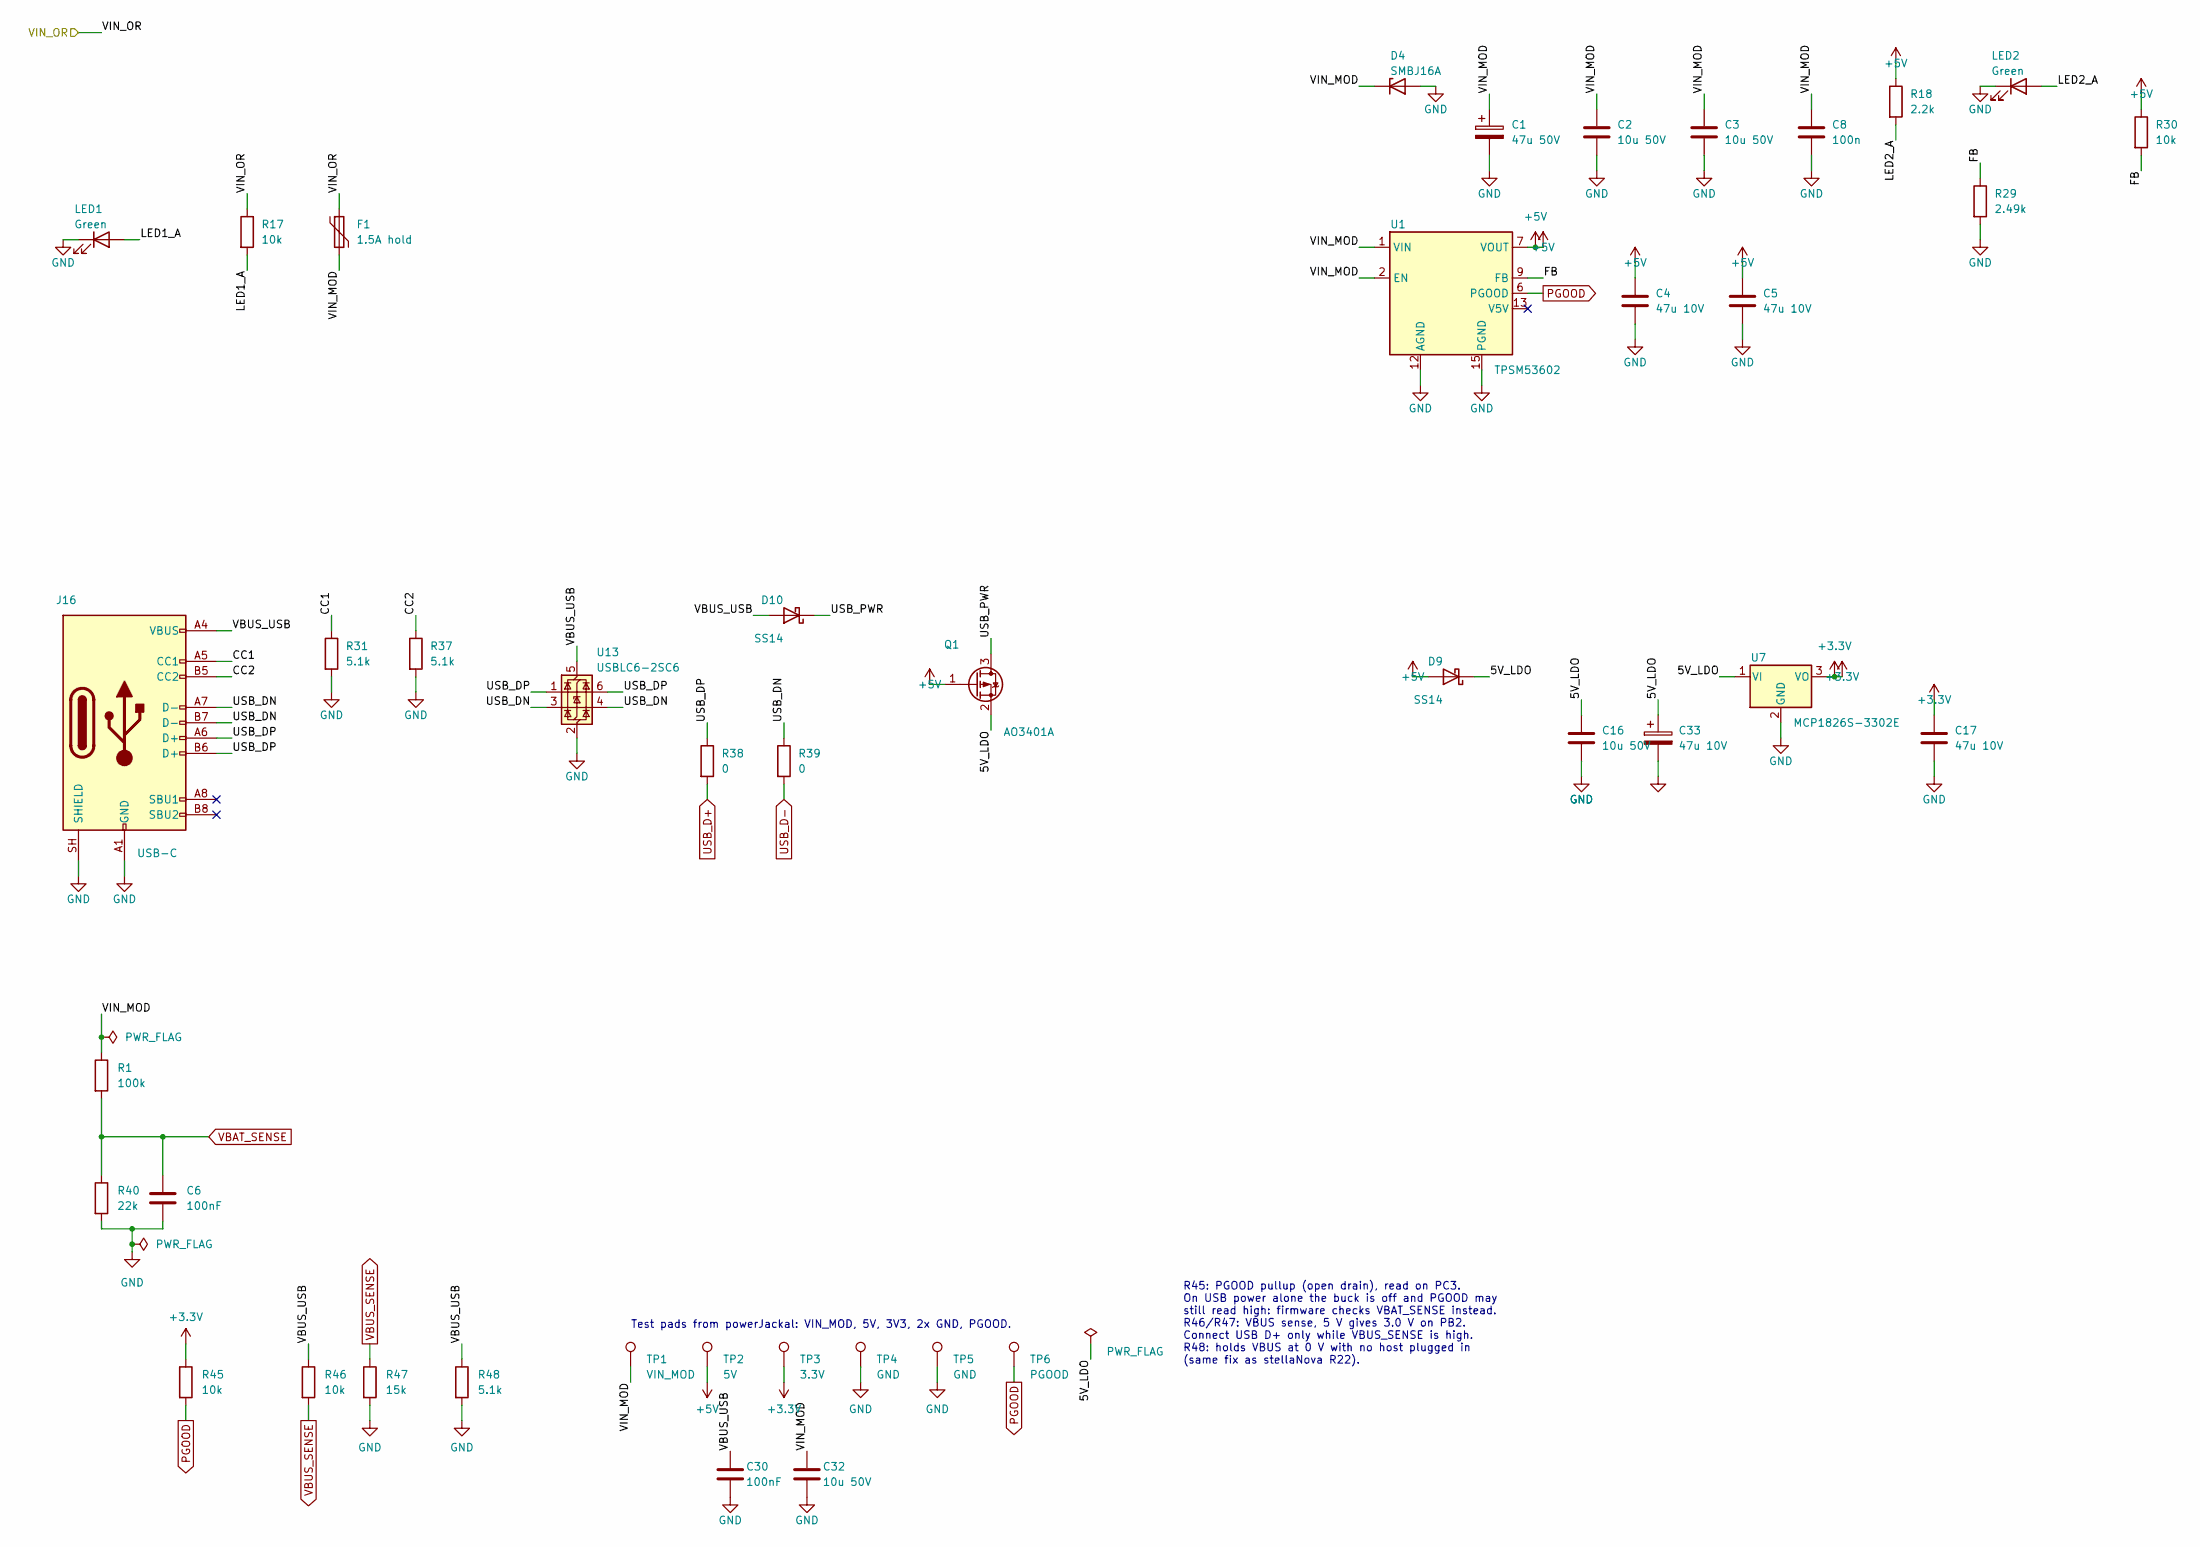
[picture p32: schematic power.kicad_sch, Centurion Sensor Board]

Parts:
C1: 47u 50V; CP_Radial_D6.3mm_P2.50mm; MPN EEU-FR1H470
C2, C3, C16, C32: 10u 50V; C_1210_3225Metric; MPN CL32B106KBJNNNE
C4, C5, C17: 47u 10V; C_1206_3216Metric; MPN GRM31CR61A476ME15L
C6, C30: 100nF; C_0805_2012Metric; MPN CC0805KRX7R9BB104
C8: 100n; C_0805_2012Metric; MPN CC0805KRX7R9BB104
C33: 47u 10V; CP_EIA-3528-21_Kemet-B; MPN T520B476M010ATE070
D4: SMBJ16A; D_SMB; MPN SMBJ16A
D9, D10: SS14; D_SMA; MPN SS14-E3/61T
F1: 1.5A hold; Fuse_Littelfuse_2016L; MPN 2016L150/33DR
J16: USB-C; USB_C_Receptacle_GCT_USB4105-xx-A_16P_TopMnt_Horizontal; MPN USB4105-GF-A
LED1, LED2: Green; LED_0603_1608Metric; MPN LTST-C191KGKT
Q1: AO3401A; SOT-23; MPN AO3401A
R1: 100k; R_0805_2012Metric; MPN RC0805FR-07100KL
R17, R30, R45, R46: 10k; R_0805_2012Metric; MPN RC0805FR-0710KL
R18: 2.2k; R_0805_2012Metric; MPN RC0805FR-072K2L
R29: 2.49k; R_0805_2012Metric; MPN RC0805FR-072K49L
R31, R37, R48: 5.1k; R_0805_2012Metric; MPN RMCF0805FT5K10
R38, R39: 0; R_0805_2012Metric; MPN RC0805JR-070RL
R40: 22k; R_0805_2012Metric; MPN RC0805FR-0722KL
R47: 15k; R_0805_2012Metric; MPN RC0805FR-0715KL
TP1: VIN_MOD; TestPoint_Pad_D1.5mm
TP2: 5V; TestPoint_Pad_D1.5mm
TP3: 3.3V; TestPoint_Pad_D1.5mm
TP4, TP5: GND; TestPoint_Pad_D1.5mm
TP6: PGOOD; TestPoint_Pad_D1.5mm
U1: TPSM53602; Texas_B3QFN-14-1EP_5x5.5mm_P0.65mm_ThermalVia; MPN TPSM53602RDAR
U7: MCP1826S-3302E; SOT-223-3_TabPin2; MPN MCP1826ST-3302E/DB
U13: USBLC6-2SC6; SOT-23-6; MPN USBLC6-2SC6

Connections:
+3.3V: C17.1, R45.1, TP3.1, U7.3 (VO); also elsewhere on the board
+5V: C4.1, C5.1, D9.2 (A), Q1.1 (G), R18.1, R30.1, TP2.1, U1.7 (VOUT), U1.8 (VOUT); also elsewhere on the board
/Power/5V_LDO: C16.1, C33.1, D9.1 (K), Q1.2 (S), U7.1 (VI)
/Power/CC1: J16.A5 (CC1), R31.1
/Power/CC2: J16.B5 (CC2), R37.1
/Power/FB: R29.1, R30.2, U1.9 (FB)
/Power/LED1_A: LED1.2 (A), R17.2
/Power/LED2_A: LED2.2 (A), R18.2
/Power/USB_DN: J16.A7 (D-), J16.B7 (D-), R39.1, U13.3 (I/O2), U13.4 (I/O2)
/Power/USB_DP: J16.A6 (D+), J16.B6 (D+), R38.1, U13.1 (I/O1), U13.6 (I/O1)
/Power/USB_PWR: D10.1 (K), Q1.3 (D)
/Power/VBUS_USB: C30.1, D10.2 (A), J16.A4 (VBUS), J16.A9 (VBUS), J16.B4 (VBUS), J16.B9 (VBUS), R46.1, R48.1, U13.5 (VBUS)
/Power/VIN_MOD: C1.1, C2.1, C3.1, C8.1, C32.1, D4.1 (K), F1.2, R1.1, TP1.1, U1.1 (VIN), U1.2 (EN), U1.14 (VIN)
/Power/VIN_OR: F1.1, R17.1; also elsewhere on the board
GND: C1.2, C2.2, C3.2, C4.2, C5.2, C6.2, C8.2, C16.2, C17.2, C30.2, C32.2, C33.2, D4.2 (A), J16.A1 (GND), J16.A12 (GND), J16.B1 (GND), J16.B12 (GND), J16.SH (SHIELD), LED1.1 (K), LED2.1 (K), R29.2, R31.2, R37.2, R40.2, R47.2, R48.2, TP4.1, TP5.1, U1.3 (NC), U1.10 (NC), U1.11 (NC), U1.12 (AGND), U1.15 (PGND), U7.2 (GND), U13.2 (GND); also elsewhere on the board
PGOOD: R45.2, TP6.1, U1.6 (PGOOD); also elsewhere on the board
USB_D+: R38.2; also elsewhere on the board
USB_D-: R39.2; also elsewhere on the board
VBAT_SENSE: C6.1, R1.2, R40.1; also elsewhere on the board
VBUS_SENSE: R46.2, R47.1; also elsewhere on the board

Notes on the sheet:
R45: PGOOD pullup (open drain), read on PC3. On USB power alone the buck is off and PGOOD may still read high: firmware checks VBAT_SENSE instead. R46/R47: VBUS sense, 5 V gives 3.0 V on PB2. Connect USB D+ only while VBUS_SENSE is high. R48: holds VBUS at 0 V with no host plugged in (same fix as s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
Test pads from powerJackal: VIN_MOD, 5V, 3V3, 2x GND, PGOOD.

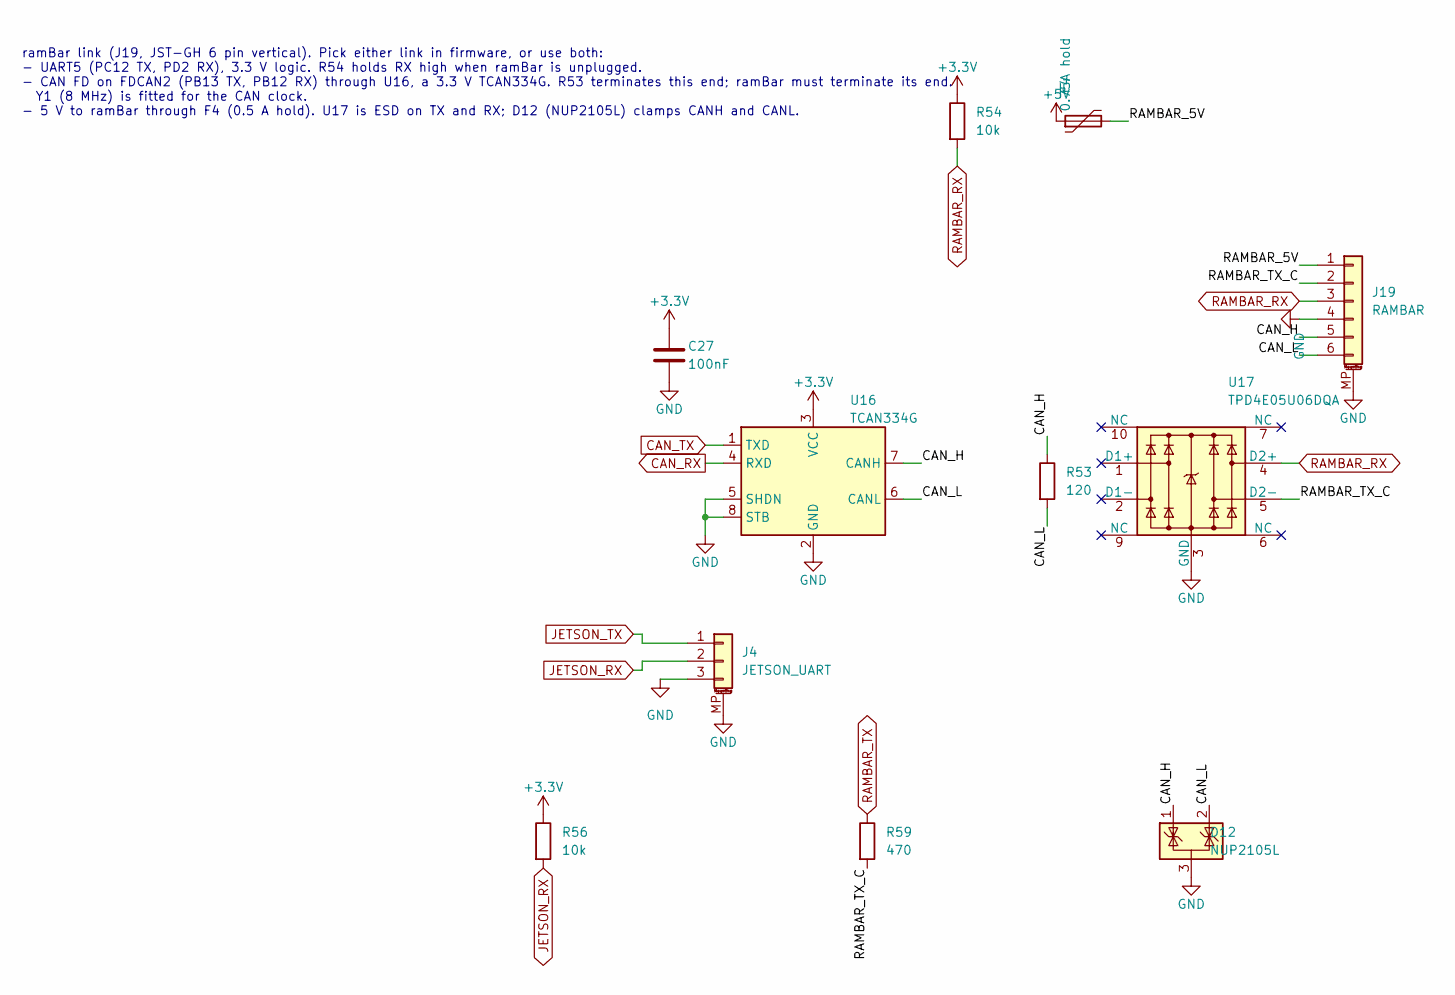
[picture p33: schematic usb_jetson.kicad_sch, Centurion Sensor Board]

Parts:
C27: 100nF; C_0805_2012Metric; MPN CC0805KRX7R9BB104
D12: NUP2105L; SOT-23; MPN NUP2105LT1G
F4: 0.75A hold; Fuse_1206_3216Metric; MPN MF-NSMF075-2
J4: JETSON_UART; JST_GH_BM03B-GHS-TBT_1x03-1MP_P1.25mm_Vertical; MPN BM03B-GHS-TBT
J19: RAMBAR; JST_GH_BM06B-GHS-TBT_1x06-1MP_P1.25mm_Vertical; MPN BM06B-GHS-TBT
R53: 120; R_0805_2012Metric; MPN RC0805FR-07120RL
R54, R56: 10k; R_0805_2012Metric; MPN RC0805FR-0710KL
R59: 470; R_0805_2012Metric; MPN RC0805FR-07470RL
U16: TCAN334G; SOIC-8_3.9x4.9mm_P1.27mm; MPN TCAN334GDR
U17: TPD4E05U06DQA; TI_DQA_USON-10_2.5x1.0mm_P0.5mm; MPN TPD4E05U06QDQARQ1

Connections:
+3.3V: C27.1, R54.1, R56.1, U16.3 (VCC); also elsewhere on the board
+5V: F4.1; also elsewhere on the board
/USB_Jetson/CAN_H: D12.1 (K), J19.5, R53.1, U16.7 (CANH)
/USB_Jetson/CAN_L: D12.2 (K), J19.6, R53.2, U16.6 (CANL)
/USB_Jetson/RAMBAR_5V: F4.2, J19.1
/USB_Jetson/RAMBAR_TX_C: J19.2, R59.2, U17.5 (D2-)
CAN_RX: U16.4 (RXD); also elsewhere on the board
CAN_TX: U16.1 (TXD); also elsewhere on the board
GND: C27.2, D12.3 (A), J4.3, J4.MP (MountPin), J19.4, J19.MP (MountPin), U16.2 (GND), U16.5 (SHDN), U16.8 (STB), U17.3 (GND), U17.8 (GND); also elsewhere on the board
JETSON_RX: J4.2, R56.2; also elsewhere on the board
JETSON_TX: J4.1; also elsewhere on the board
RAMBAR_RX: J19.3, R54.2, U17.4 (D2+); also elsewhere on the board
RAMBAR_TX: R59.1; also elsewhere on the board

Notes on the sheet:
ramBar link (J19, JST-GH 6 pin vertical). Pick either link in firmware, or use both: - UART5 (PC12 TX, PD2 RX), 3.3 V logic. R54 holds RX high when ramBar is unplugged. - CAN FD on FDCAN2 (PB13 TX, PB12 RX) through U16, a 3.3 V TCAN334G. R53 terminates this end; ramBar must terminate its end. Y1 (8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

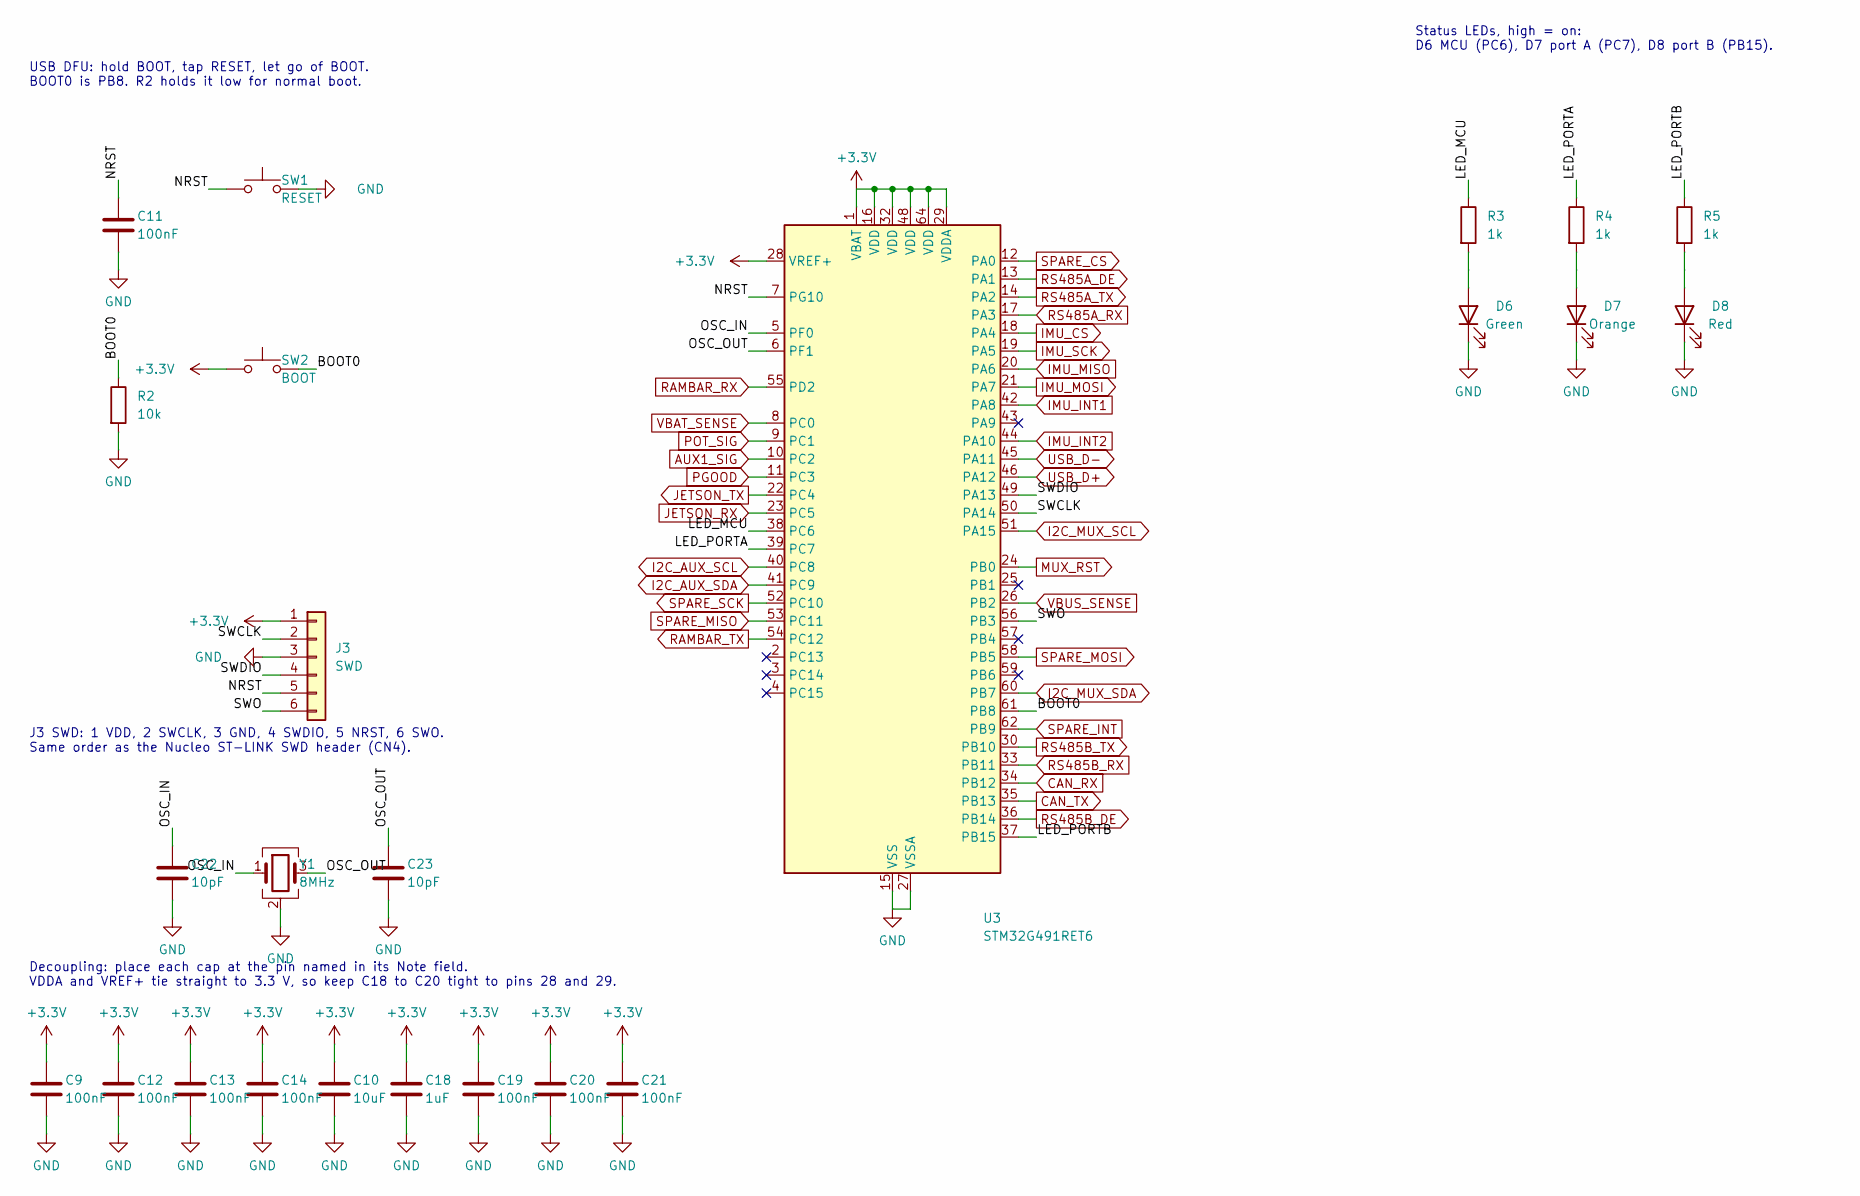
[picture p34: schematic mcu.kicad_sch, Centurion Sensor Board]

Parts:
C9, C11, C12, C13, C14, C19, C20, C21: 100nF; C_0805_2012Metric; MPN CC0805KRX7R9BB104
C10: 10uF; C_0805_2012Metric; MPN GRM21BR61E106KA73K
C18: 1uF; C_0805_2012Metric; MPN CC0805KKX7R8BB105
C22, C23: 10pF; C_0805_2012Metric; MPN CC0805JRNPO9BN100
D6: Green; LED_0603_1608Metric; MPN LTST-C191KGKT
D7: Orange; LED_0603_1608Metric; MPN LTST-C191KFKT
D8: Red; LED_0603_1608Metric; MPN LTST-C191KRKT
J3: SWD; PinHeader_1x06_P2.54mm_Vertical; MPN PRPC040SAAN-RC
R2: 10k; R_0805_2012Metric; MPN RC0805FR-0710KL
R3, R4, R5: 1k; R_0805_2012Metric; MPN RC0805FR-071KL
SW1: RESET; SW_SPST_TL3342; MPN TL3342F160QG
SW2: BOOT; SW_SPST_TL3342; MPN TL3342F160QG
U3: STM32G491RET6; LQFP-64_10x10mm_P0.5mm; MPN STM32G491RET6
Y1: 8MHz; Crystal_SMD_3225-4Pin_3.2x2.5mm; MPN ABM8AIG-8.000MHZ-8-V1R-T

Connections:
+3.3V: C9.1, C10.1, C12.1, C13.1, C14.1, C18.1, C19.1, C20.1, C21.1, J3.1, SW2.1, U3.1 (VBAT), U3.16 (VDD), U3.28 (VREF+), U3.29 (VDDA), U3.32 (VDD), U3.48 (VDD), U3.64 (VDD); also elsewhere on the board
/MCU/BOOT0: R2.1, SW2.2, U3.61 (PB8)
/MCU/LED_MCU: R3.1, U3.38 (PC6)
/MCU/LED_PORTA: R4.1, U3.39 (PC7)
/MCU/LED_PORTB: R5.1, U3.37 (PB15)
/MCU/NRST: C11.1, J3.5, SW1.1, U3.7 (PG10)
/MCU/OSC_IN: C22.1, U3.5 (PF0), Y1.1
/MCU/OSC_OUT: C23.1, U3.6 (PF1), Y1.3
/MCU/SWCLK: J3.2, U3.50 (PA14)
/MCU/SWDIO: J3.4, U3.49 (PA13)
/MCU/SWO: J3.6, U3.56 (PB3)
AUX1_SIG: U3.10 (PC2); also elsewhere on the board
CAN_RX: U3.34 (PB12); also elsewhere on the board
CAN_TX: U3.35 (PB13); also elsewhere on the board
GND: C9.2, C10.2, C11.2, C12.2, C13.2, C14.2, C18.2, C19.2, C20.2, C21.2, C22.2, C23.2, D6.1 (K), D7.1 (K), D8.1 (K), J3.3, R2.2, SW1.2, U3.15 (VSS), U3.27 (VSSA), U3.31 (VSS), U3.47 (VSS), U3.63 (VSS), Y1.2 (G), Y1.4 (G); also elsewhere on the board
I2C_AUX_SCL: U3.40 (PC8); also elsewhere on the board
I2C_AUX_SDA: U3.41 (PC9); also elsewhere on the board
I2C_MUX_SCL: U3.51 (PA15); also elsewhere on the board
I2C_MUX_SDA: U3.60 (PB7); also elsewhere on the board
IMU_CS: U3.18 (PA4); also elsewhere on the board
IMU_INT1: U3.42 (PA8); also elsewhere on the board
IMU_INT2: U3.44 (PA10); also elsewhere on the board
IMU_MISO: U3.20 (PA6); also elsewhere on the board
IMU_MOSI: U3.21 (PA7); also elsewhere on the board
IMU_SCK: U3.19 (PA5); also elsewhere on the board
JETSON_RX: U3.23 (PC5); also elsewhere on the board
JETSON_TX: U3.22 (PC4); also elsewhere on the board
MUX_RST: U3.24 (PB0); also elsewhere on the board
unnamed: D6.2 (A), R3.2
unnamed: D7.2 (A), R4.2
unnamed: D8.2 (A), R5.2
PGOOD: U3.11 (PC3); also elsewhere on the board
POT_SIG: U3.9 (PC1); also elsewhere on the board
RAMBAR_RX: U3.55 (PD2); also elsewhere on the board
RAMBAR_TX: U3.54 (PC12); also elsewhere on the board
RS485A_DE: U3.13 (PA1); also elsewhere on the board
RS485A_RX: U3.17 (PA3); also elsewhere on the board
RS485A_TX: U3.14 (PA2); also elsewhere on the board
RS485B_DE: U3.36 (PB14); also elsewhere on the board
RS485B_RX: U3.33 (PB11); also elsewhere on the board
RS485B_TX: U3.30 (PB10); also elsewhere on the board
SPARE_CS: U3.12 (PA0); also elsewhere on the board
SPARE_INT: U3.62 (PB9); also elsewhere on the board
SPARE_MISO: U3.53 (PC11); also elsewhere on the board
SPARE_MOSI: U3.58 (PB5); also elsewhere on the board
SPARE_SCK: U3.52 (PC10); also elsewhere on the board
USB_D+: U3.46 (PA12); also elsewhere on the board
USB_D-: U3.45 (PA11); also elsewhere on the board
VBAT_SENSE: U3.8 (PC0); also elsewhere on the board
VBUS_SENSE: U3.26 (PB2); also elsewhere on the board

Notes on the sheet:
Decoupling: place each cap at the pin named in its Note field. VDDA and VREF+ tie straight to 3.3 V, so keep C18 to C20 tight to pins 28 and 29.
USB DFU: hold BOOT, tap RESET, let go of BOOT. BOOT0 is PB8. R2 holds it low for normal boot.
J3 SWD: 1 VDD, 2 SWCLK, 3 GND, 4 SWDIO, 5 NRST, 6 SWO. Same order as the Nucleo ST-LINK SWD header (CN4).
Status LEDs, high = on: D6 MCU (PC6), D7 port A (PC7), D8 port B (PB15).
