UW-VexU/UWAT-Centurion-Board/centurion/centurion.kicad_pcb

## KiCad design centurion/centurion.kicad_pcb (continued)

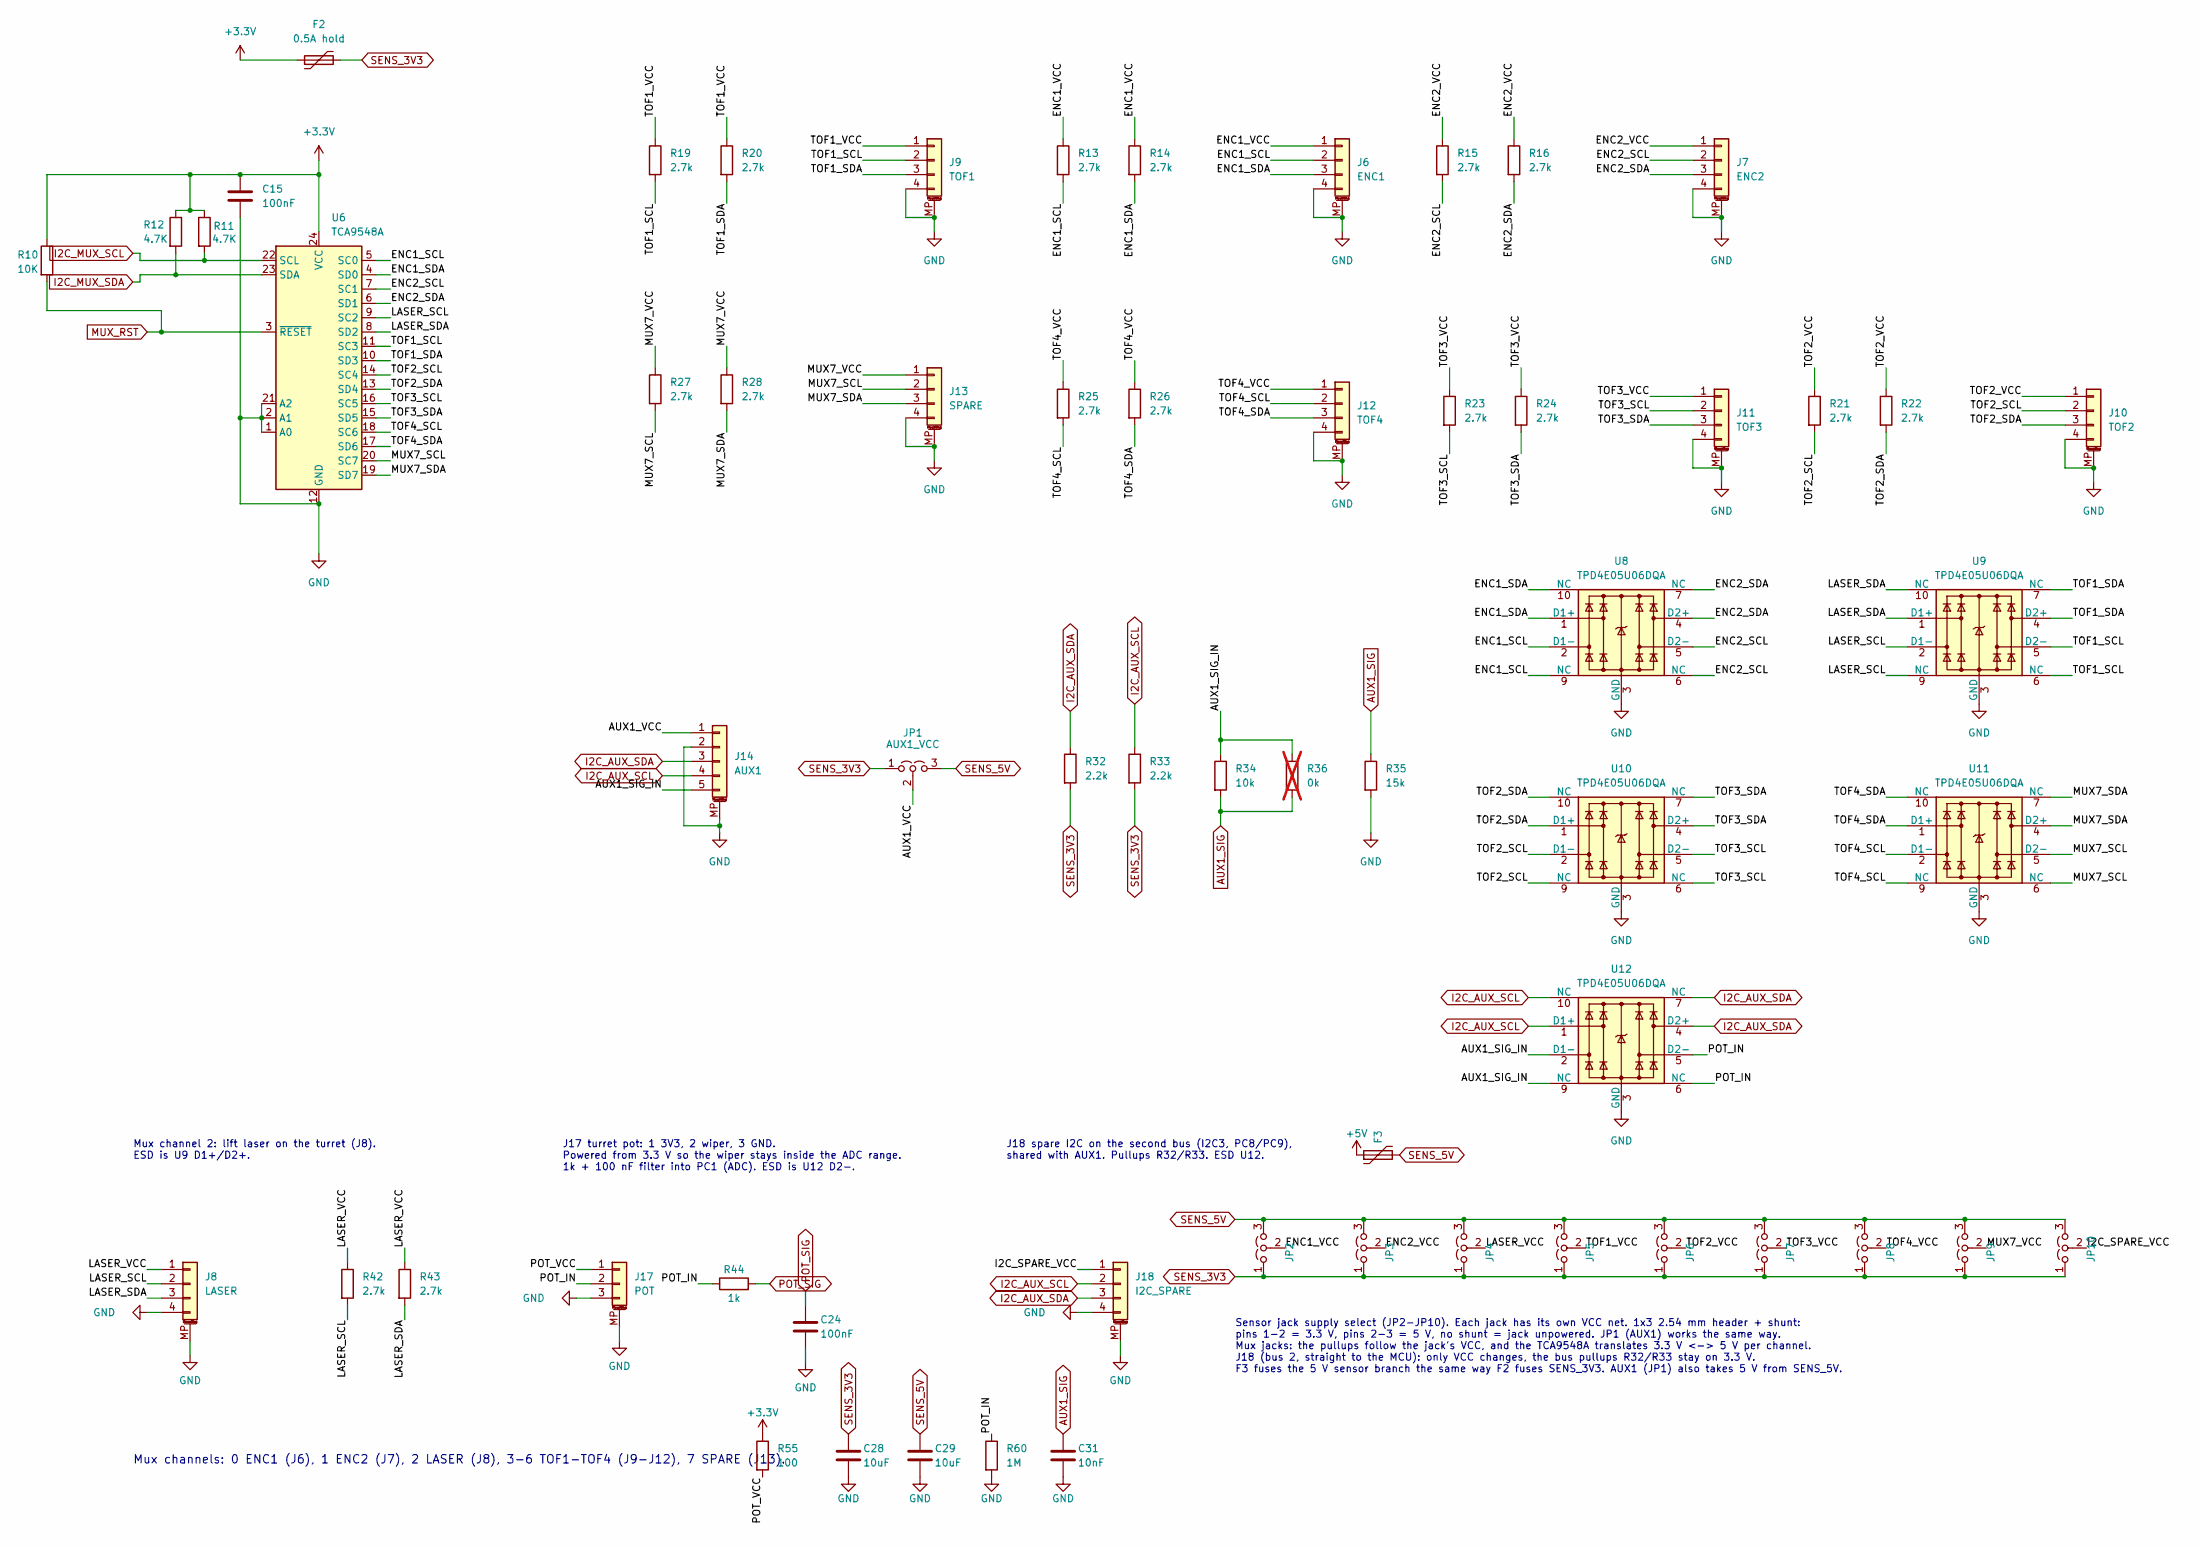
[picture p35: schematic sensors.kicad_sch, Centurion Sensor Board]

Parts:
C15, C24: 100nF; C_0805_2012Metric; MPN CC0805KRX7R9BB104
C28, C29: 10uF; C_0805_2012Metric; MPN GRM21BR61E106KA73K
C31: 10nF; C_0805_2012Metric; MPN CC0805KRX7R9BB103
F2, F3: 0.5A hold; Fuse_1206_3216Metric; MPN MF-NSMF050-2
J6: ENC1; JST_GH_SM04B-GHS-TB_1x04-1MP_P1.25mm_Horizontal; MPN SM04B-GHS-TB
J7: ENC2; JST_GH_SM04B-GHS-TB_1x04-1MP_P1.25mm_Horizontal; MPN SM04B-GHS-TB
J8: LASER; JST_GH_SM04B-GHS-TB_1x04-1MP_P1.25mm_Horizontal; MPN SM04B-GHS-TB
J9: TOF1; JST_GH_SM04B-GHS-TB_1x04-1MP_P1.25mm_Horizontal; MPN SM04B-GHS-TB
J10: TOF2; JST_GH_SM04B-GHS-TB_1x04-1MP_P1.25mm_Horizontal; MPN SM04B-GHS-TB
J11: TOF3; JST_GH_SM04B-GHS-TB_1x04-1MP_P1.25mm_Horizontal; MPN SM04B-GHS-TB
J12: TOF4; JST_GH_SM04B-GHS-TB_1x04-1MP_P1.25mm_Horizontal; MPN SM04B-GHS-TB
J13: SPARE; JST_GH_SM04B-GHS-TB_1x04-1MP_P1.25mm_Horizontal; MPN SM04B-GHS-TB
J14: AUX1; JST_GH_SM05B-GHS-TB_1x05-1MP_P1.25mm_Horizontal; MPN SM05B-GHS-TB
J17: POT; JST_GH_SM03B-GHS-TB_1x03-1MP_P1.25mm_Horizontal; MPN SM03B-GHS-TB
J18: I2C_SPARE; JST_GH_SM04B-GHS-TB_1x04-1MP_P1.25mm_Horizontal; MPN SM04B-GHS-TB
JP1: AUX1_VCC; PinHeader_1x03_P2.54mm_Vertical
JP2: ENC1_VCC; PinHeader_1x03_P2.54mm_Vertical
JP3: ENC2_VCC; PinHeader_1x03_P2.54mm_Vertical
JP4: LASER_VCC; PinHeader_1x03_P2.54mm_Vertical
JP5: TOF1_VCC; PinHeader_1x03_P2.54mm_Vertical
JP6: TOF2_VCC; PinHeader_1x03_P2.54mm_Vertical
JP7: TOF3_VCC; PinHeader_1x03_P2.54mm_Vertical
JP8: TOF4_VCC; PinHeader_1x03_P2.54mm_Vertical
JP9: MUX7_VCC; PinHeader_1x03_P2.54mm_Vertical
JP10: I2C_SPARE_VCC; PinHeader_1x03_P2.54mm_Vertical
R10: 10K; R_0805_2012Metric; MPN RC0805FR-0710KL
R11, R12: 4.7K; R_0805_2012Metric; MPN RC0805FR-074K7L
R13, R14, R15, R16, R19, R20, R21, R22, R23, R24, R25, R26, R27, R28, R42, R43: 2.7k; R_0805_2012Metric; MPN RC0805FR-072K7L
R32, R33: 2.2k; R_0805_2012Metric; MPN RC0805FR-072K2L
R34: 10k; R_0805_2012Metric; MPN RC0805FR-0710KL
R35: 15k; R_0805_2012Metric; MPN RC0805FR-0715KL
R36: 0k; R_0805_2012Metric; MPN RC0805JR-070RL; not fitted
R44: 1k; R_0805_2012Metric; MPN RC0805FR-071KL
R55: 100; R_0805_2012Metric; MPN RC0805FR-07100RL
R60: 1M; R_0805_2012Metric; MPN RC0805FR-071ML
U6: TCA9548A; TSSOP-24_4.4x7.8mm_P0.65mm; MPN TCA9548APWR
U8, U9, U10, U11, U12: TPD4E05U06DQA; TI_DQA_USON-10_2.5x1.0mm_P0.5mm; MPN TPD4E05U06QDQARQ1

Connections:
+3.3V: C15.1, F2.1, R10.1, R11.1, R12.1, R55.1, U6.24 (VCC); also elsewhere on the board
+5V: F3.1; also elsewhere on the board
/Sensors/AUX1_SIG_IN: J14.5, R34.1, R36.1, U12.2 (D1-), U12.9 (NC)
/Sensors/AUX1_VCC: J14.1, JP1.2 (C)
/Sensors/ENC1_SCL: J6.2, R13.2, U6.5 (SC0), U8.2 (D1-), U8.9 (NC)
/Sensors/ENC1_SDA: J6.3, R14.2, U6.4 (SD0), U8.1 (D1+), U8.10 (NC)
/Sensors/ENC1_VCC: J6.1, JP2.2 (C), R13.1, R14.1
/Sensors/ENC2_SCL: J7.2, R15.2, U6.7 (SC1), U8.5 (D2-), U8.6 (NC)
/Sensors/ENC2_SDA: J7.3, R16.2, U6.6 (SD1), U8.4 (D2+), U8.7 (NC)
/Sensors/ENC2_VCC: J7.1, JP3.2 (C), R15.1, R16.1
/Sensors/I2C_SPARE_VCC: J18.1, JP10.2 (C)
/Sensors/LASER_SCL: J8.2, R42.2, U6.9 (SC2), U9.2 (D1-), U9.9 (NC)
/Sensors/LASER_SDA: J8.3, R43.2, U6.8 (SD2), U9.1 (D1+), U9.10 (NC)
/Sensors/LASER_VCC: J8.1, JP4.2 (C), R42.1, R43.1
/Sensors/MUX7_SCL: J13.2, R27.2, U6.20 (SC7), U11.5 (D2-), U11.6 (NC)
/Sensors/MUX7_SDA: J13.3, R28.2, U6.19 (SD7), U11.4 (D2+), U11.7 (NC)
/Sensors/MUX7_VCC: J13.1, JP9.2 (C), R27.1, R28.1
/Sensors/POT_IN: J17.2, R44.1, R60.1, U12.5 (D2-), U12.6 (NC)
/Sensors/POT_VCC: J17.1, R55.2
/Sensors/TOF1_SCL: J9.2, R19.2, U6.11 (SC3), U9.5 (D2-), U9.6 (NC)
/Sensors/TOF1_SDA: J9.3, R20.2, U6.10 (SD3), U9.4 (D2+), U9.7 (NC)
/Sensors/TOF1_VCC: J9.1, JP5.2 (C), R19.1, R20.1
/Sensors/TOF2_SCL: J10.2, R21.2, U6.14 (SC4), U10.2 (D1-), U10.9 (NC)
/Sensors/TOF2_SDA: J10.3, R22.2, U6.13 (SD4), U10.1 (D1+), U10.10 (NC)
/Sensors/TOF2_VCC: J10.1, JP6.2 (C), R21.1, R22.1
/Sensors/TOF3_SCL: J11.2, R23.2, U6.16 (SC5), U10.5 (D2-), U10.6 (NC)
/Sensors/TOF3_SDA: J11.3, R24.2, U6.15 (SD5), U10.4 (D2+), U10.7 (NC)
/Sensors/TOF3_VCC: J11.1, JP7.2 (C), R23.1, R24.1
/Sensors/TOF4_SCL: J12.2, R25.2, U6.18 (SC6), U11.2 (D1-), U11.9 (NC)
/Sensors/TOF4_SDA: J12.3, R26.2, U6.17 (SD6), U11.1 (D1+), U11.10 (NC)
/Sensors/TOF4_VCC: J12.1, JP8.2 (C), R25.1, R26.1
AUX1_SIG: C31.1, R34.2, R35.1, R36.2; also elsewhere on the board
GND: C15.2, C24.2, C28.2, C29.2, C31.2, J6.4, J6.MP (MountPin), J7.4, J7.MP (MountPin), J8.4, J8.MP (MountPin), J9.4, J9.MP (MountPin), J10.4, J10.MP (MountPin), J11.4, J11.MP (MountPin), J12.4, J12.MP (MountPin), J13.4, J13.MP (MountPin), J14.2, J14.MP (MountPin), J17.3, J17.MP (MountPin), J18.4, J18.MP (MountPin), R35.2, R60.2, U6.1 (A0), U6.2 (A1), U6.12 (GND), U6.21 (A2), U8.3 (GND), U8.8 (GND), U9.3 (GND), U9.8 (GND), U10.3 (GND), U10.8 (GND), U11.3 (GND), U11.8 (GND), U12.3 (GND), U12.8 (GND); also elsewhere on the board
I2C_AUX_SCL: J14.4, J18.2, R33.1, U12.1 (D1+), U12.10 (NC); also elsewhere on the board
I2C_AUX_SDA: J14.3, J18.3, R32.1, U12.4 (D2+), U12.7 (NC); also elsewhere on the board
I2C_MUX_SCL: R11.2, U6.22 (SCL); also elsewhere on the board
I2C_MUX_SDA: R12.2, U6.23 (SDA); also elsewhere on the board
MUX_RST: R10.2, U6.3 (~RESET); also elsewhere on the board
POT_SIG: C24.1, R44.2; also elsewhere on the board
SENS_3V3: C28.1, F2.2, JP1.1 (A), JP2.1 (A), JP3.1 (A), JP4.1 (A), JP5.1 (A), JP6.1 (A), JP7.1 (A), JP8.1 (A), JP9.1 (A), JP10.1 (A), R32.2, R33.2; also elsewhere on the board
SENS_5V: C29.1, F3.2, JP1.3 (B), JP2.3 (B), JP3.3 (B), JP4.3 (B), JP5.3 (B), JP6.3 (B), JP7.3 (B), JP8.3 (B), JP9.3 (B), JP10.3 (B)

Notes on the sheet:
Mux channel 2: lift laser on the turret (J8). ESD is U9 D1+/D2+.
J17 turret pot: 1 3V3, 2 wiper, 3 GND. Powered from 3.3 V so the wiper stays inside the ADC range. 1k + 100 nF filter into PC1 (ADC). ESD is U12 D2-.
J18 spare I2C on the second bus (I2C3, PC8/PC9), shared with AUX1. Pullups R32/R33. ESD U12.
Mux channels: 0 ENC1 (J6), 1 ENC2 (J7), 2 LASER (J8), 3-6 TOF1-TOF4 (J9-J12), 7 SPARE (J13).
Sensor jack supply select (JP2-JP10). Each jack has its own VCC net. 1x3 2.54 mm header + shunt: pins 1-2 = 3.3 V, pins 2-3 = 5 V, no shunt = jack unpowered. JP1 (AUX1) works the same way. Mux jacks: the pullups follow the jack's VCC, and the TCA9548A translates 3.3 V <-> 5 V per channel. J18 (bus 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

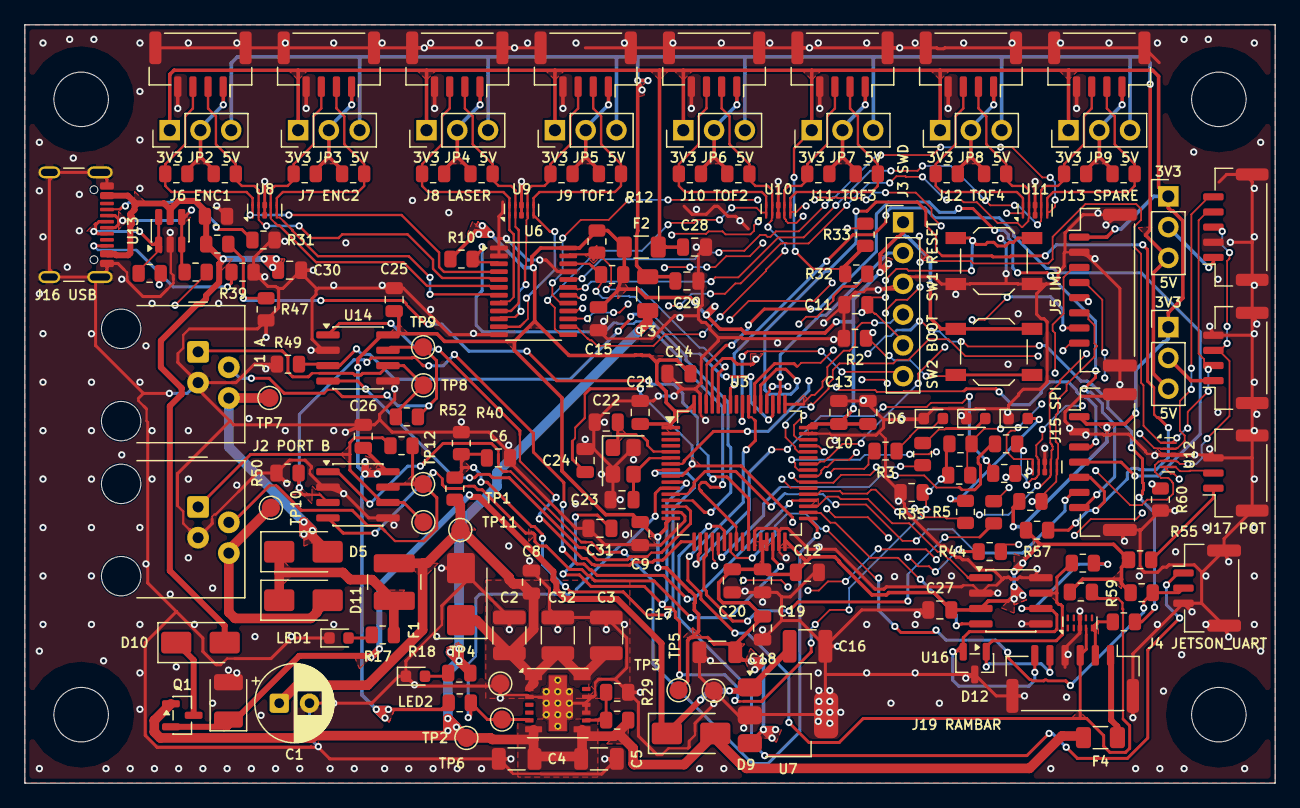
[picture p36: board centurion.kicad_pcb from above]

Board: 4 copper layers, 103.2 x 62.6 mm, 169 parts (0 on the bottom side), 107 nets.
