UW-VexU/UWAT-Centurion-Board/imuBoard/imuBoard.kicad_pcb

## KiCad design imuBoard/imuBoard.kicad_pcb (2026-11-04)

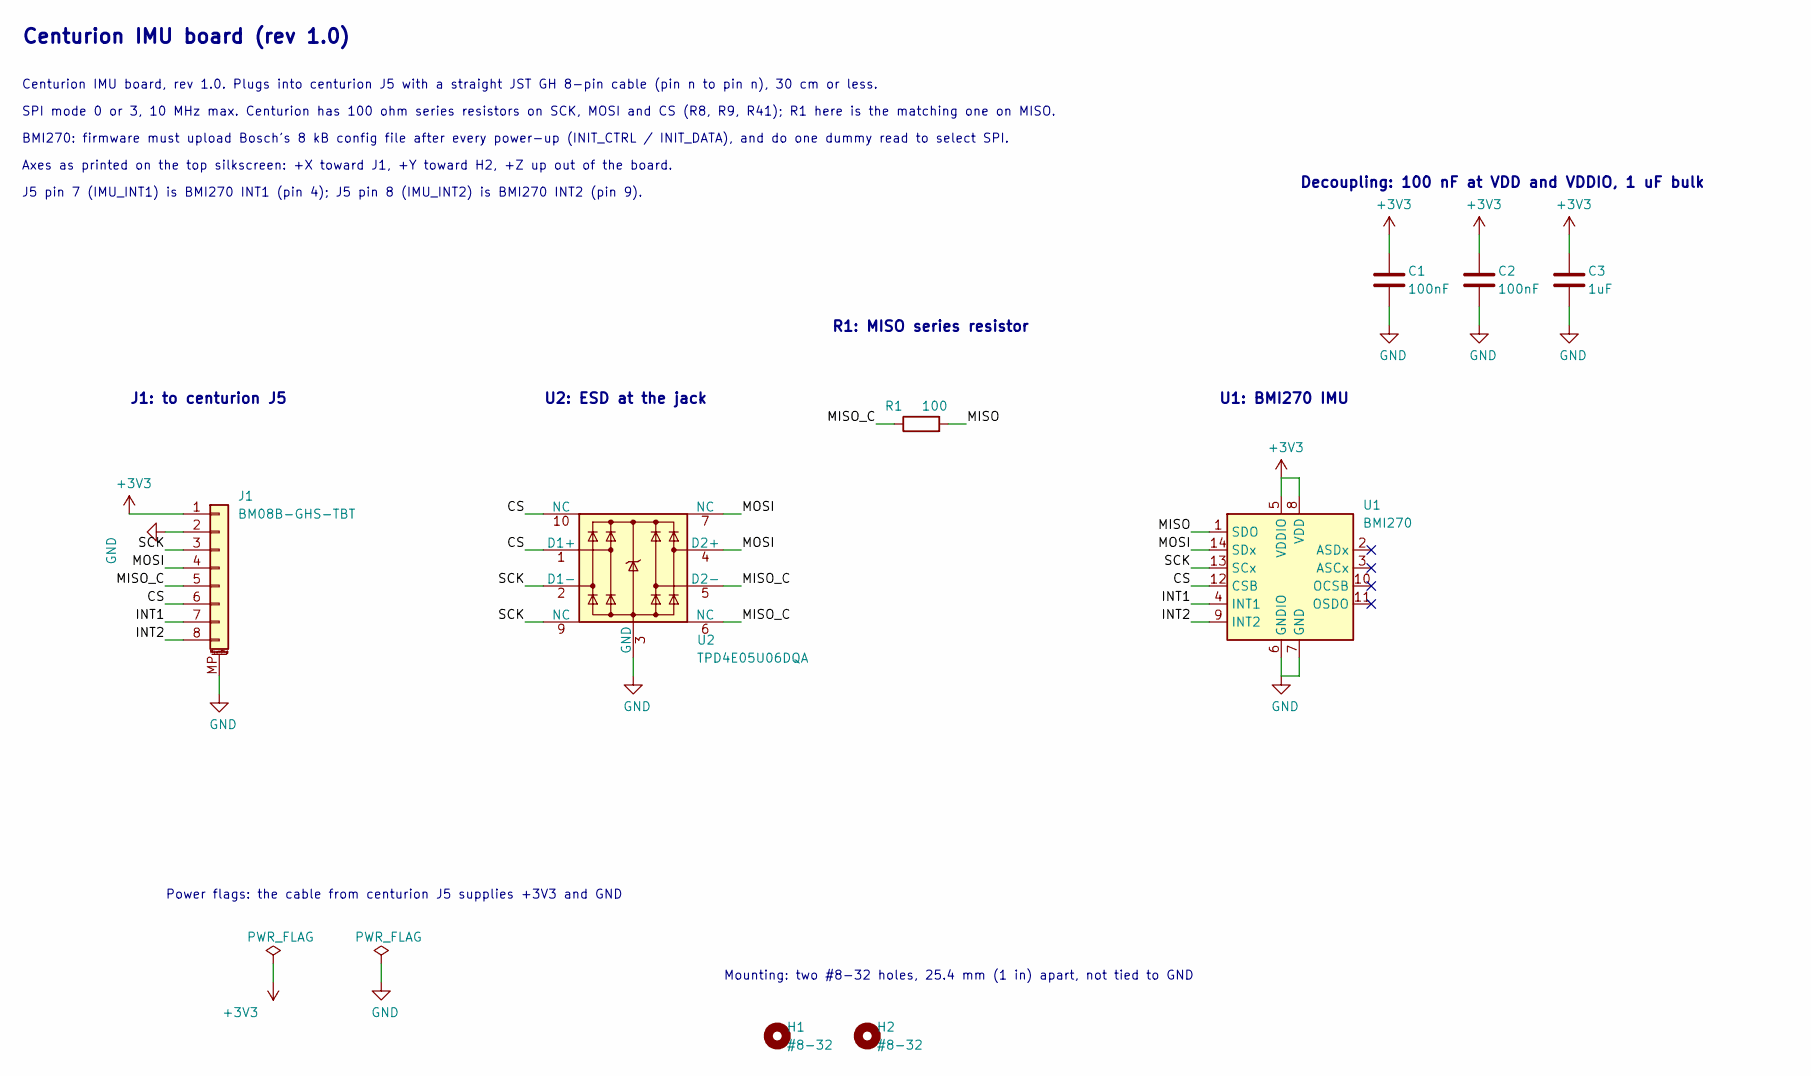
[picture p37: schematic imuBoard.kicad_sch, Centurion IMU board]

Parts:
C1, C2: 100nF; C_0805_2012Metric; MPN CC0805KRX7R9BB104
C3: 1uF; C_0805_2012Metric; MPN CC0805KKX7R8BB105
H1, H2: #8-32; MountingHole_4.5mm_8-32
J1: BM08B-GHS-TBT; JST_GH_BM08B-GHS-TBT_1x08-1MP_P1.25mm_Vertical; MPN BM08B-GHS-TBT
R1: 100; R_0805_2012Metric; MPN RC0805FR-07100RL
U1: BMI270; Bosch_LGA-14_3x2.5mm_P0.5mm; MPN BMI270
U2: TPD4E05U06DQA; TI_DQA_USON-10_2.5x1.0mm_P0.5mm; MPN TPD4E05U06QDQARQ1

Connections:
+3V3: C1.1, C2.1, C3.1, J1.1, U1.5 (VDDIO), U1.8 (VDD)
/CS: J1.6, U1.12 (CSB), U2.1 (D1+), U2.10 (NC)
/INT1: J1.7, U1.4 (INT1)
/INT2: J1.8, U1.9 (INT2)
/MISO: R1.2, U1.1 (SDO)
/MISO_C: J1.5, R1.1, U2.5 (D2-), U2.6 (NC)
/MOSI: J1.4, U1.14 (SDx), U2.4 (D2+), U2.7 (NC)
/SCK: J1.3, U1.13 (SCx), U2.2 (D1-), U2.9 (NC)
GND: C1.2, C2.2, C3.2, J1.2, J1.MP (MountPin), U1.6 (GNDIO), U1.7 (GND), U2.3 (GND), U2.8 (GND)

Notes on the sheet:
Power flags: the cable from centurion J5 supplies +3V3 and GND
Mounting: two #8-32 holes, 25.4 mm (1 in) apart, not tied to GND
Centurion IMU board (rev 1.0)
Centurion IMU board, rev 1.0. Plugs into centurion J5 with a straight JST GH 8-pin cable (pin n to pin n), 30 cm or less.
SPI mode 0 or 3, 10 MHz max. Centurion has 100 ohm series resistors on SCK, MOSI and CS (R8, R9, R41); R1 here is the matching one on MISO.
BMI270: firmware must upload Bosch's 8 kB config file after every power-up (INIT_CTRL / INIT_DATA), and do one dummy read to select SPI.
Axes as printed on the top silkscreen: +X toward J1, +Y toward H2, +Z up out of the board.
J5 pin 7 (IMU_INT1) is BMI270 INT1 (pin 4); J5 pin 8 (IMU_INT2) is BMI270 INT2 (pin 9).
J1: to centurion J5
U2: ESD at the jack
R1: MISO series resistor
U1: BMI270 IMU
Decoupling: 100 nF at VDD and VDDIO, 1 uF bulk

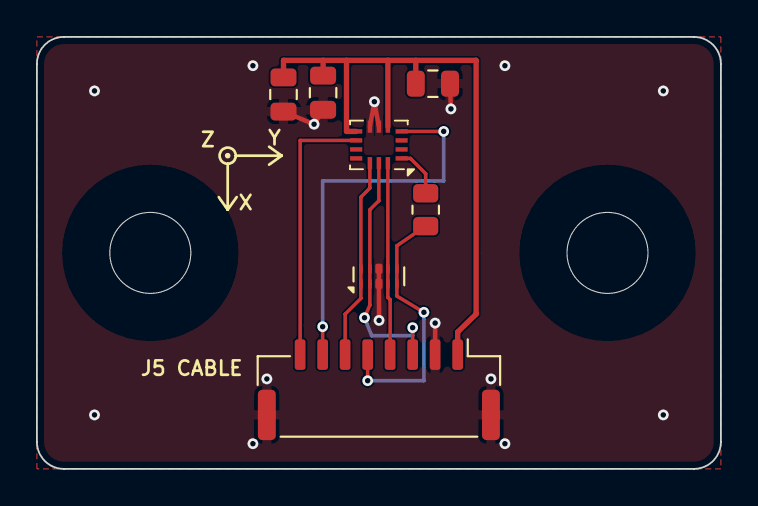
[picture p38: board imuBoard.kicad_pcb from above]

Board: 2 copper layers, 38.0 x 24.0 mm, 10 parts (0 on the bottom side), 9 nets.

Other parts of the board:
AX1: AXES
