UW-VexU/UWAT-Centurion-Board/stellaNova/uwat-stellaNova.kicad_pcb

## KiCad design stellaNova/uwat-stellaNova.kicad_pcb (2026-10-31)

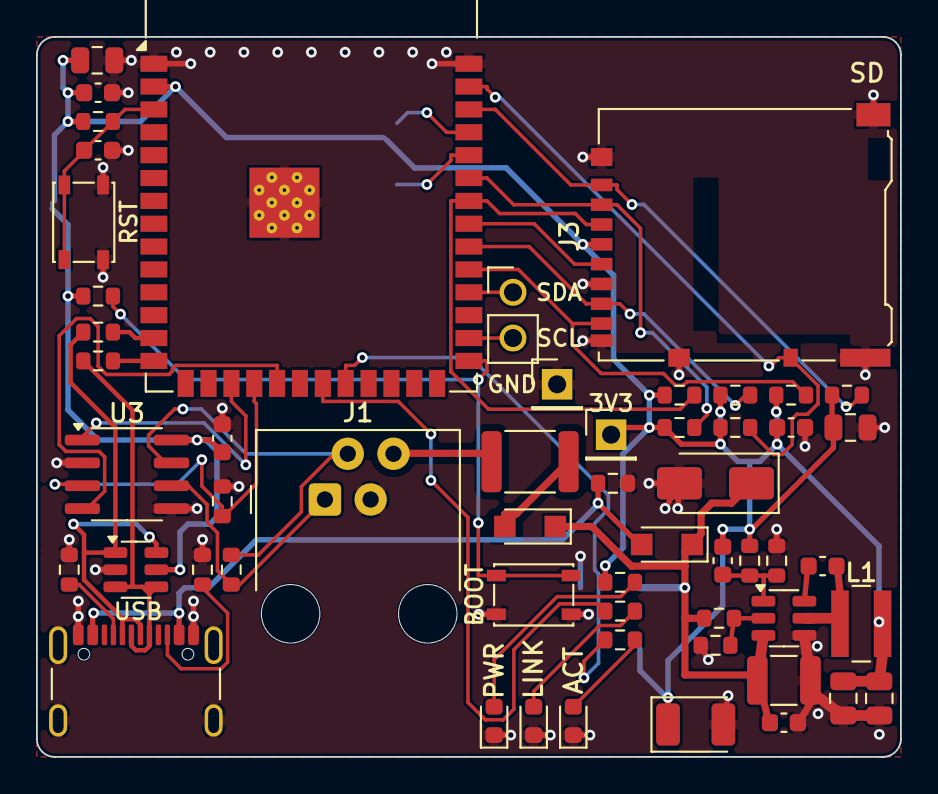
[picture p39: board uwat-stellaNova.kicad_pcb from above]

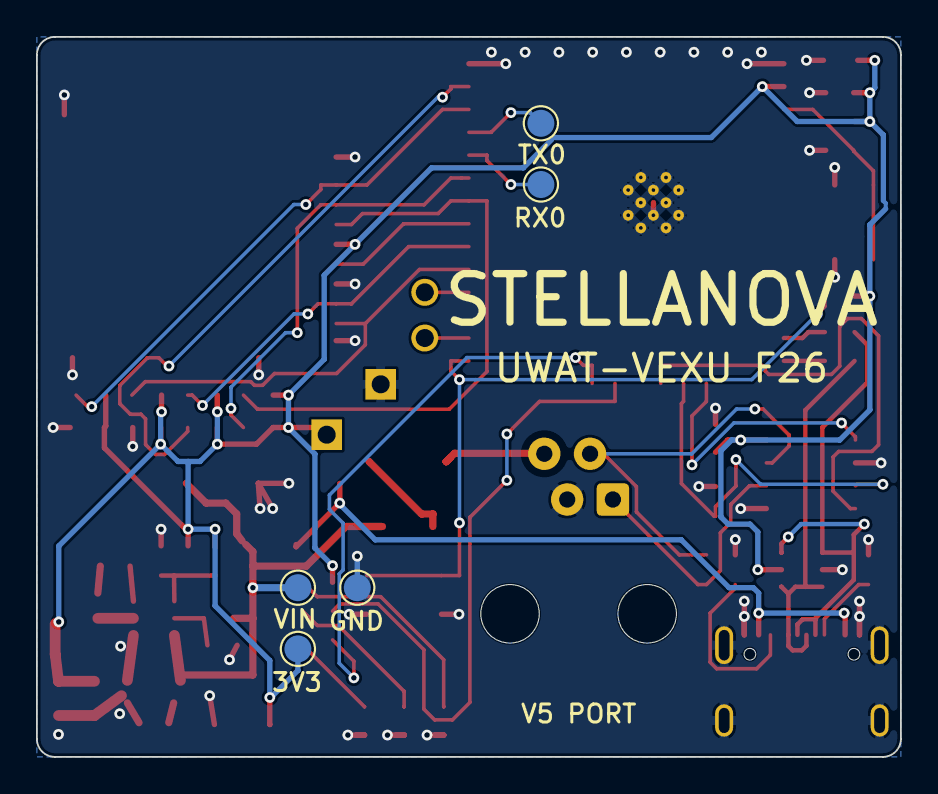
[picture p40: board uwat-stellaNova.kicad_pcb from below]

Board: 2 copper layers, 48.0 x 40.0 mm, 60 parts (5 on the bottom side), 39 nets.

Parts:
C1: 10uF 50V; C_1210_3225Metric
C2, C3, C7, C9, C12: 100nF; C_0603_1608Metric
C4, C5: 22uF; C_0805_2012Metric
C6: 220uF; CP_EIA-3528-21_Kemet-B
C8, C11: 10uF; C_0805_2012Metric
C10: 1uF; C_0603_1608Metric
C13: 56pF; C_0603_1608Metric
D1: SMAJ18A; D_SMA
D2, D3: PMEG6020ER; Nexperia_CFP3_SOD-123W
D5: USBLC6-2SC6; SOT-23-6
D6: Green; LED_0603_1608Metric
D7: Orange; LED_0603_1608Metric
D8: Red; LED_0603_1608Metric
F1: PTC 0.5 A 30 V; Fuse_1812_4532Metric
J1: V5 smart port (4P4C); Molex_95501-2441_4P4C_Horizontal
J2: USB-C 2.0; USB_C_Receptacle_GCT_USB4105-xx-A_16P_TopMnt_Horizontal
J3: microSD push-push; microSD_HC_Hirose_DM3AT-SF-PEJM5
J4: Header 1x02; PinHeader_1x02_P2.54mm_Vertical_Compact
J5, J6: Header 1x01; PinHeader_1x01_P2.54mm_Vertical_Compact
L1: 10uH; L_Wuerth_MAPI-4030
R1: 100k; R_0603_1608Metric
R2: 37.4k; R_0603_1608Metric
R3, R5, R6, R9, R10, R11, R12, R13, R14: 10k; R_0603_1608Metric
R4: 120; R_0603_1608Metric
R7, R8, R22: 5.1k; R_0603_1608Metric
R15, R16, R17: 1k; R_0603_1608Metric
R18, R19: 22; R_0603_1608Metric
R20: 93.1k; R_0603_1608Metric
R21: 30.1k; R_0603_1608Metric
SW1, SW2: Tactile; SW_SPST_PTS810
TP1, TP2, TP3, TP4, TP5: TP; TestPoint_Pad_D1.5mm
U1: ESP32-S3-WROOM-1-N16R2; ESP32-S3-WROOM-1
U2: AP63301WU-7; TSOT-23-6
U3: MAX33071EASA+; SOIC-8_3.9x4.9mm_P1.27mm

Connections:
+3V3: C4.1, C5.1, C6.1, C7.1, C8.1, C9.1, C11.1, C12.1, C13.1, D5.5, J3.4, J6.1, L1.2, R5.1, R6.1, R9.1, R10.1, R11.1, R12.1, R13.1, R14.1, R15.1, R20.1, TP2.1, U1.2, U3.8
/BOOT: R6.2, SW2.1, U1.27
/BST: C3.1, U2.6
/CC1: J2.A5, R7.1
/CC2: J2.B5, R8.1
/ESP_EN: C10.1, R5.2, SW1.1, U1.3
/ESP_USB_DN: R18.2, U1.13
/ESP_USB_DP: R19.2, U1.14
/FB: C13.2, R20.2, R21.1, U2.1
/LED_ACT: R17.1, U1.22
/LED_LINK: R16.1, U1.21
/RS485_A: J1.1, R4.1, U3.6
/RS485_B: J1.2, R4.2, U3.7
/RS485_DE: R3.1, U1.18, U3.3
/RS485_RX: U1.17, U3.1
/RS485_TX: U1.19, U3.4
/SCL: J4.2, U1.28
/SDA: J4.1, U1.30
/SD_CLK: J3.5, U1.33
/SD_CMD: J3.3, R9.2, U1.34
/SD_D0: J3.7, R10.2, U1.32
/SD_D1: J3.8, R11.2, U1.31
/SD_D2: J3.1, R12.2, U1.38
/SD_D3: J3.2, R13.2, U1.35
/SD_DET: J3.10, R14.2, U1.39
/SW: C3.2, L1.1, U2.5
/U0RXD: TP5.1, U1.36
/U0TXD: TP4.1, U1.37
/USB_DN: D5.1, D5.6, J2.A7, J2.B7, R18.1
/USB_DP: D5.3, D5.4, J2.A6, J2.B6, R19.1
/VBAT_PORT: F1.1, J1.4
GND: C1.2, C2.2, C4.2, C5.2, C6.2, C7.2, C8.2, C9.2, C10.2, C11.2, C12.2, D1.2, D5.2, D6.1, D7.1, D8.1, J1.3, J2.A1, J2.A12, J2.B1, J2.B12, J2.S1, J3.6, J3.9, J3.11, J5.1, R2.2, R3.2, R7.2, R8.2, R21.2, R22.2, SW1.2, SW2.2, TP3.1, U1.1, U1.40, U1.41, U2.4, U3.2, U3.5
unnamed: D2.2, F1.2
unnamed: D6.2, R15.2
unnamed: D7.2, R16.2
unnamed: D8.2, R17.2
unnamed: R1.2, R2.1, U2.2
VBUS: D3.2, J2.A4, J2.A9, J2.B4, J2.B9, R22.1
VIN: C1.1, C2.1, D1.1, D2.1, D3.1, R1.1, TP1.1, U2.3
