UW-VexU/UWAT-Centurion-Board/(commit log)

2026-10-11 power components import
2026-10-27 Ignore KiCad local history folder
2026-10-27 Add project footprint library
2026-10-27 Power sheet: input protection and 5V buck
2026-10-27 Power sheet complete, wired to smart ports
2026-10-27 Remove KiCad crash backup from repo
2026-10-27 IMU sheet complete
2026-10-27 Sensors sheet: sensor fuse, mux A, channel labels
2026-10-29 Sensors sheet: 8 encoder/ToF ports on mux A
2026-10-29 Sensors sheet: mux B, 3 aux ports, spare header
2026-10-29 Sensors sheet complete: ESD protection
2026-10-29 power jackal v1
2026-10-30 jackal gerber rev 1-1
2026-10-30 stellaNova debug board init
2026-10-30 2 layer stellaNova - bom
2026-10-31 Power sheet: reuse powerJackal power input, 5V, 3.3V and USB-C; add battery sense
2026-10-31 SmartPort: Molex jack + B340A from powerJackal; remove old USB parts
2026-11-03 temp push - needs routing grounds
2026-11-04 bom update again
2026-11-04 imu started breakout
2026-11-05 sample 4 layer fab
2026-11-05 gerber script tooling
2026-11-06 bom updates - p3
